Sprudlwassr/FlexPrint/documents/graphics/Letzter Versuchsaufbau.jpg

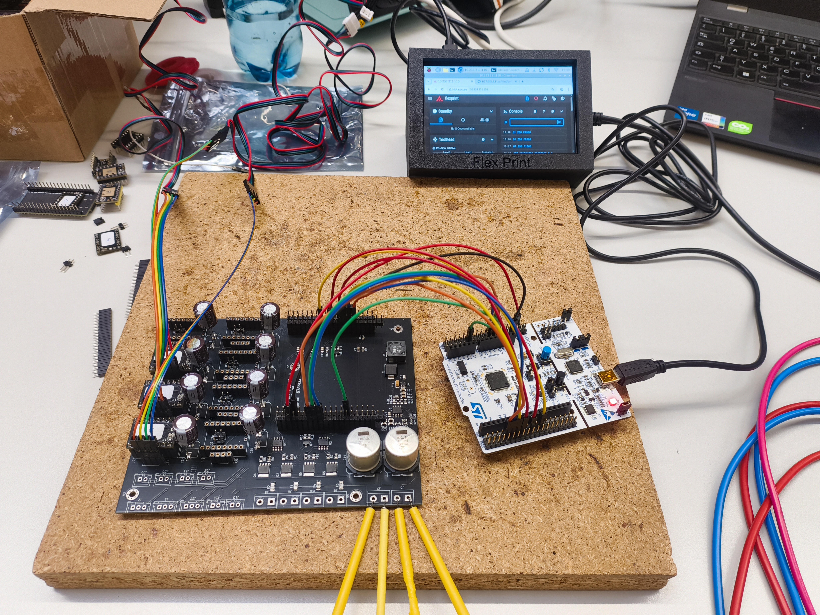
documents/graphics/Letzter Versuchsaufbau.jpg
