Sprudlwassr/FlexPrint/documents/graphics/IMG_20260625_225233708.jpg

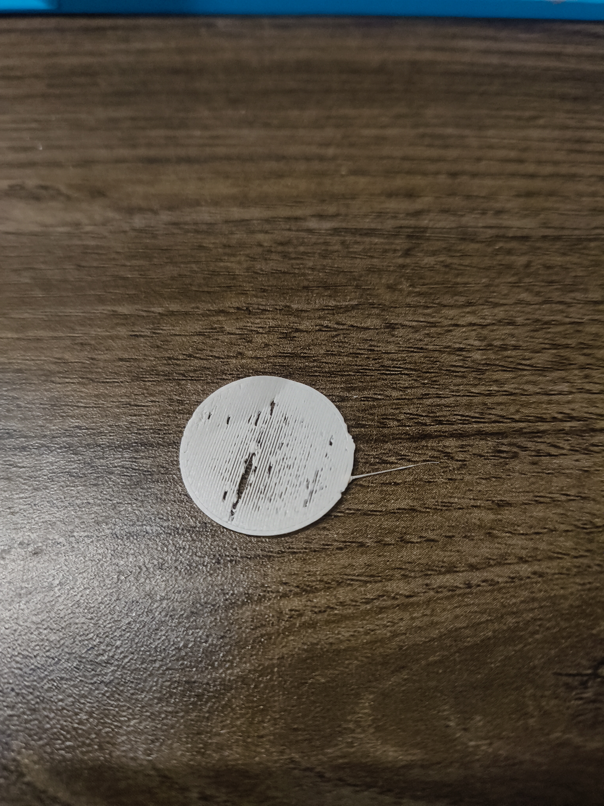
documents/graphics/IMG_20260625_225233708.jpg
