Sprudlwassr/FlexPrint/documents/Doku_Fab_v1.docx

# 1 Entwicklung der Steppertreiberplatine

## Anforderungen an die Treiberplatine

Kernaufgabe der Platine ist es, einen bipolaren Schrittmotor sauber zu treiben – und das unter Bedingungen, die sowohl elektrisch als auch thermisch einiges verlangen. Der Einsatz im 3D-Drucker bringt dabei zwei Anforderungen besonders in den Vordergrund: Der Motor soll möglichst leise laufen, und der Strom muss stabil geregelt bleiben. Damit Motorstrom und Microstepping nicht fest verdrahtet sind, sondern sich flexibel einstellen lassen, wird eine serielle Schnittstelle zur digitalen Konfiguration benötigt.

Mit 24 V Versorgungsspannung arbeitet das System – die Leistungsseite der Platine muss das von Grund auf berücksichtigen. Leiterbahnen, die hohe Motorströme führen, brauchen entsprechend Querschnitt. Auf der anderen Seite der Platine, dort wo die Logik sitzt, ist 3,3 V das Maß der Dinge, passend zur verwendeten Mikrocontrollerumgebung.

Von Anfang an war Modularität gewünscht. Jeder Treiber bekommt seine eigene kleine Platine – fällt einer aus, lässt er sich rasch tauschen, ohne den Rest anzufassen. Nebenbei macht das die Anordnung auf dem Mainboard flexibler und erlaubt es, Wärme dort abzuführen, wo es am sinnvollsten ist.

Mehrere Treiber teilen sich einen gemeinsamen UART-Bus, weshalb jede Platine eindeutig adressierbar sein muss. Lötbrücken oder Konfigurationspads bieten sich dafür an. Daneben müssen STEP, DIR und ENABLE als Steuersignale für den Echtzeitbetrieb verfügbar sein.

Thermisch darf man sich keine Schwächen erlauben: Verlustleistung, die nicht abgeführt wird, wird zum Problem. Großzügig dimensionierte Kupferflächen und eine gut durchdachte Bauteilplatzierung sind hier die entscheidenden Maßnahmen.

## Auswahl des Treiber-IC

Der Treiber muss den Strom sauber regeln und dabei effizient arbeiten. Konfiguriert wird er über UART, was Pins am Mikrocontroller spart. Der Betrieb soll leise sein und Microstepping muss ebenfalls unterstützt werden damit die Bewegung feiner wird.
Elektrisch gelten folgende Vorgaben:

- 3,3V Logikpegel, weil der Mikrocontroller damit arbeitet.
- Auf der Motorseite mindestens 24V
- Dauerströme zwischen 1A und 2A RMS müssen problemlos funktionieren.

Basierend auf den Anforderungen der Treiberplatine fiel die Wahl auf den TMC2209 Treiber-IC. Er deckt alle benötigten Funktionen, wie den leisen Betrieb mittels StealthChop Technologie oder UART Konfiguration von bis zu 4 Chips pro UART, ab. Der TMC2209 arbeitet mit 24V Motorspannung und bis zu 2 Ampere (Dauerstrom). Auch wichtig ist, dass der Treiber mit den 3.3V Logikspannung die auf dem Mainboard verwendet werden klarkommt.

## Funktionsbeschreibung des Treibers

Der TMC2209 ist ein Stepper-Treiber-IC von Trinamic, der für den Einsatz in 3D-Druckern und ähnlichen Anwendungen entwickelt wurde. Er treibt bipolare Schrittmotoren mit bis zu 2A Dauerstrom und 24V Motorspannung.

Die Stromregelung läuft intern über ein Chopper-Verfahren. Dabei wird die Motorspannung schnell ein- und ausgeschaltet, quasi eine Pulsweitenmodulation, bis der gewünschte Strom erreicht ist. Der TMC2209 nutzt dafür den StealthChop2 Modus, der den Motor sehr leise macht weil die Schaltfrequenz optimiert wird. Bei höheren Geschwindigkeiten schaltet er automatisch auf SpreadCycle um, was eine präzisere Regelung bringt.

Microstepping unterstützt der TMC2209 bis zu 1/256 Schritt, was die Bewegung deutlich feiner und ruhiger macht. Konfiguriert wird alles über UART, bis zu 4 Chips können auf einem Bus betrieben werden – jeder mit eigener Adresse.

Zusätzlich hat der TMC2209 eine StallGuard Funktion, die eine sensorlose Endlagenerkennung ermöglicht. Der Motor läuft gegen einen Anschlag, der Treiber erkennt den erhöhten Widerstand und meldet das dem Mikrocontroller – ganz ohne extra Endschalter.

Die Logikseite arbeitet mit 3,3V, was direkt mit den meisten Mikrocontrollern kompatibel ist.

## Dimensionierung der Sense-Widerstände

[Tabelle aus Datenblatt S.52]

Shunt-Widerstände müssen sorgfältig ausgewählt werden. Der volle Motorstrom fließt durch die Shunt-Widerstände. Aufgrund des Chopper-Betriebs sind die Shunt-Widerstände gepulsten Strömen aus den MOSFET-Brücken ausgesetzt. Daher ist ein induktivitätsarmer Typ wie Film- oder Kompositionswiderstände erforderlich, um Spannungsspitzen zu vermeiden, die ein Schwingen an den Stromsensor-Eingängen verursachen und zu instabilen Messergebnissen führen würden.

Ebenso ist ein induktivitätsarmes, niederohmiges Leiterplattenlayout unerlässlich. Gemeinsame GND-Pfade für die beiden Shunt-Widerstände müssen unbedingt vermieden werden, da dies zu einer Kopplung zwischen den beiden Strommesssignalen führen würde. Eine massive Massefläche ist am besten geeignet.

Der Shunt-Widerstand muss in der Lage sein, den Motorspitzenstrom bei Motorstillstand zu führen, sofern die Standby-Leistung nicht reduziert wird. Unter normalen Bedingungen führt der Shunt-Widerstand weniger als den Effektivstrom der Spule, da während der Freilaufphasen (Slow Decay) kein Strom durch den Shunt-Widerstand fließt. Ein Typ mit 0,5 W ist für die meisten Anwendungen bis 1,2 A Effektivstrom ausreichend.

Für das Projekt wurde ein Shunt von 120m Ohm ausgewählt. Aus der Tabelle kann entnommen werden, dass dies einen RMS-Strom von 1.64A zur Folge hat. Der größte Vorteil von ~1.7A zu den maximalen ~2A ist, dass die Verlustleistung um knapp 40% verringert wird, bei nur 17% Einbußen an Kraft. Dazu kommt, dass der TMC2209 Chip, wenn er am Limit (2A) läuft, nicht mehr schön im StealthChop Modus bleibt und dann Schrittverluste auftreten können.

## UART-Kommunikation

### Übersicht

Der TMC2209 nutzt eine Single-Wire UART-Schnittstelle – das heißt, Senden und Empfangen laufen über einen einzigen Pin: PDN_UART.

Die Baudrate wird automatisch erkannt, muss also nicht fest konfiguriert werden. Typisch werden 9.600 – 500.000 Baud verwendet (Standard 115.200 Baud).

### One-Wire Bus

Normalerweise hat UART zwei Leitungen: TX (Senden) und RX (Empfangen). Beim TMC2209 werden beide auf einer einzigen Leitung zusammengeführt.

Das geht so:

[BILD VOM UART PIN RX UND TX MIT 1K]

TX und RX des Mikrocontrollers sind über einen 1-kΩ-Widerstand miteinander verbunden und führen gemeinsam zum PDN_UART-Pin des TMC2209.

Alles, was der Mikrocontroller sendet, landet auch sofort auf seiner eigenen RX-Leitung → das nennt man Echo. Diese Echo-Bytes müssen in der Software einfach ignoriert/übersprungen werden.

Der Bus muss im Leerlauf auf High liegen (wie bei Standard-UART).

Es wird immer nur in eine Richtung gleichzeitig kommuniziert (Halbduplex).

Bis zu 4 TMC2209 können an einem Bus hängen – Adresse wird über die Pins MS1 und MS2 eingestellt.

### Datagrammstruktur

Jede Kommunikation besteht aus kurzen Datenpaketen (Datagrammen).

Schreiben (4 → 8 Bytes vom MC zum TMC2209):

Byte | Inhalt
0 | Sync
1 | Adresse
2 | Register + Write
3-6 | 32-Bit Datenwort (MSB beginnend)
7 | CRC (Prüfsumme)

Lesen (erst 4 Bytes senden, dann 8 Bytes Antwort empfangen):

Byte | Inhalt
0 | Sync
1 | Adresse
2 | Register (ohne Write)
3 | CRC

Die Antwort des Treibers sieht aus wie der Schreibvorgang mit 8 Byte Paketgröße.

### Adressierung

Die Adressen der Chips werden über die Pins MS1 und MS2 wie folgt eingestellt:

MS2 | MS1 | Adresse
0 | 0 | 0
0 | 1 | 1
1 | 0 | 2
1 | 1 | 3

## STEP/DIR Signalführung

### Übersicht

STEP und DIR sind im Prinzip zwei simple Signale. Das Step-Signal gibt an, ob ein Schritt gemacht werden soll oder nicht und das Dir-Signal gibt an, in welche Richtung der Schritt geht.

### Pegel & Kompatibilität

Der TMC2209 unterstützt sowohl 3,3 V als auch 5 V Logik – welcher Pegel gilt, eingestellt wird dies über den VCC_IO-Pin.

Liegt VCC_IO auf 3,3 V, arbeiten alle digitalen Pins mit 3,3-V-CMOS-Pegeln.

Wichtig dabei: Die Eingänge STEP, DIR und ENN sind nicht 5V-tolerant, wenn VCC_IO auf 3,3 V liegt.

### Timing

Die Signale müssen bestimmte Mindestzeiten einhalten, damit der Treiber jeden Schritt zuverlässig erkennt.

Die wichtigste Regel betrifft das Verhältnis von DIR und STEP: DIR muss mindestens 20 ns vor der steigenden Flanke von STEP stabil anliegen (Setup-Zeit, t_DSU), und auch nach der Flanke noch mindestens 20 ns gehalten werden (Hold-Zeit, t_DHD).

Wechseln DIR und STEP zu exakt dem gleichen Zeitpunkt, kann der Treiber einen falschen Schritt in die falsche Richtung machen.

Der STEP-Puls selbst muss mindestens 100 ns High bleiben (t_HIGH) und danach mindestens 100 ns Low bleiben (t_LOW), bevor der nächste Puls kommen darf. Kürzere Pulse werden vom Treiber möglicherweise gar nicht erkannt.

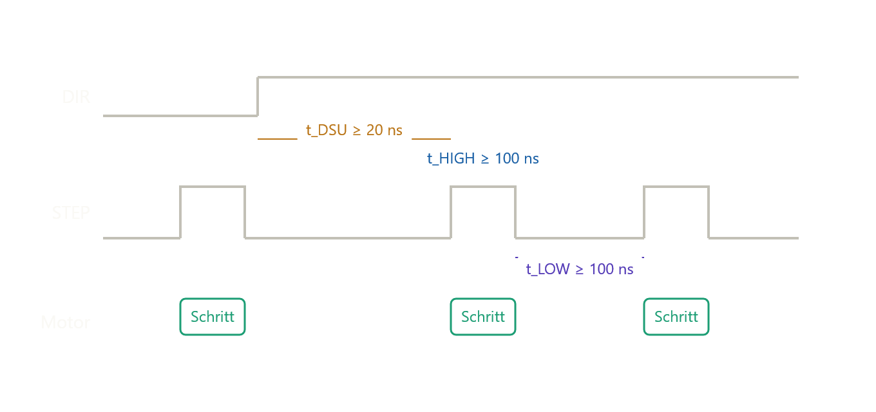
[picture p3: figure]

## Versorgungsspannung der Treiber

Jeder TMC2209 benötigt zwei getrennte Versorgungsspannungen: VM (Motorversorgung) und VIO (Logikversorgung).

### VM – Motorversorgung (24V)

VM wird direkt vom 24V Hauptnetzteil gespeist und versorgt die H-Brücken des Treibers, die den Motorstrom schalten. Pro Treiber ist ein 100µF Elektrolytkondensator (C36) parallel zu VM geschaltet, der als Bulk-Speicher dient und kurzzeitige Stromspitzen beim Schalten der H-Brücken abpuffert.

### VIO – Logikversorgung (3.3V)

VIO wird von der 3.3V Schiene des Mainboards gespeist, die vom MIC5219-3.3YM5 LDO (Linearregler) bereitgestellt wird. Dieser wird seinerseits vom TPS54560BDDA (12V→5V Schaltregler) versorgt — die vollständige Kaskade lautet also: 24V → 12V (extern) → 5V (TPS54560BDDA) → 3.3V (MIC5219). VIO versorgt die digitale Logik des TMC2209 sowie die UART-Schnittstelle. Pro Treiber ist ein 100nF Keramikkondensator (C20) an VIO platziert.

### Einschaltreihenfolge

Die korrekte Einschaltreihenfolge (VM vor VIO) ist hardwareseitig durch einen Spannungsteiler an dem Enable-Pin (EN) des TPS54560BDDA abgesichert. Die Widerstände R25 (11kΩ) und R26 (100kΩ) bilden einen Spannungsteiler von der 24V Schiene auf EN — der Regler bleibt solange deaktiviert bis die 24V Versorgung eine Schwelle von ca. 12.6V überschreitet. Da VM direkt von 24V kommt ohne weitere Wandlerstufe, ist garantiert dass VM bereits stabil anliegt bevor der TPS54560BDDA die 5V Schiene und damit die gesamte VIO-Kaskade (5V → 3.3V) aktiviert.

## Entkopplung und Filterung

Um hochfrequente Störungen durch das schnelle Schalten der H-Brücken zu unterdrücken und eine stabile Versorgung sicherzustellen, sind an jedem TMC2209 mehrere Entkopplungsmaßnahmen implementiert.

### VM-Entkopplung

An der VM-Versorgung jedes Treibers ist am Mainboard ein 100µF Elektrolytkondensator, dieser wird benötigt zum Spannungsspitzen durch die Motoransteuerung kompensieren. Auf der Treiberplatine sind zusätzlich 2x 10µF sowie 3x 100nF an VM vorgesehen. Der Charge-Pump Kondensator C3 an CPO/CPI ist laut Datenblatt für den internen Spannungsverdoppler des TMC2209 erforderlich. Dieser wird benötigt um die Treiber FETs vollständig durchzuschalten.

### VIO-Entkopplung

An VIO ist am Steckplatz der Treiberplatine ein 100nF Keramikkondensator (C20) platziert, dieser unterdrückt hochfrequente Störungen auf der Logikversorgung die durch UART-Kommunikation oder digitale Schaltvorgänge entstehen können. Dazu kommen weitere zwei Kondensatoren C1 (100nF) und C2 (4.7µF), die auf der Treiberplatine selbst, möglichst nah am IC platziert sind.

## Thermisches Design

### Verlustleistung

Der TMC2209 dissipiert im Betrieb Verlustleistung primär über die integrierten H-Brücken. Die Verlustleistung pro Treiber berechnet sich nach:

P=I^2 *R_(dson)

Der TMC2209 besitzt laut Datenblatt einen kombinierten R_DS(on) von ca. 0.34Ω (High-Side + Low-Side je 0.17Ω). Damit ergibt sich:

Bei 0.8A RMS (Inbetriebnahme/Testbetrieb): P=0.8^2 *0.34=0.22W pro Treiber

Bei 1.5A RMS (Volllastbetrieb): P=1.5^2 *0.34=0.77W pro Treiber

Bei sieben verbauten Treibern (2x XY, 3x Z, 1x Extruder, 1x Reserve) ergibt sich die gesamte thermische Last:

Bei 0.8A: P_(ges) =7*0.22W=1.53W

Bei 1.5A: P_(ges) =7*0.77W=5.36W

### Wärmeableitung über das PCB

Der TMC2209 im QFN28-Gehäuse besitzt ein freiliegendes Thermal Pad auf der Unterseite, das den Großteil der Wärme an das PCB abgibt. Da die Treiberplatine als separates Modul ausgeführt ist (15.48 × 20.44mm), wurde unter dem Thermal Pad eine Matrix aus Thermal Vias platziert die die Wärme auf die Rückseite der Platine überträgt. Dort vergrößert eine Kupferfläche die effektive Abstrahlfläche. Ein direktes Exposed Pad auf der Rückseite wurde aus fertigungstechnischen Gründen nicht vorgesehen.

### Aktive Kühlung

Auf der Oberseite jedes Treibermoduls wird ein kompakter Kühlkörper aufgeklebt. Das Druckergehäuse wird mit mindestens einem Lüfter ausgestattet der für ausreichend Luftzirkulation im Elektronikbereich sorgt und die von den Kühlkörpern abgegebene Wärme abtransportiert.

## Schaltplan der Treiberplatine

Der vollständige Schaltplan der Treiberplatine ist in Abbildung X dargestellt. Er zeigt den TMC2209 im QFN28-Gehäuse mit allen peripheren Beschaltungselementen: die Entkopplungskondensatoren an VM und VIO, den Charge-Pump Kondensator C3, die Sense-Widerstände R4 und R5 (je 120 mΩ) zur Strommessung, sowie den PDN_UART Anschluss mit Pull-up Widerstand R2 (20kΩ). Der einstellbare Widerstand RV1 ermöglicht die manuelle Anpassung des Referenzstroms über VREF. Die Motorausgänge (OUTA1, OUTA2, OUTB1, OUTB2) sowie alle Steuersignale (STEP, DIR, EN, UART) werden über zwei 8-polige Steckverbinder (J1, J2) nach außen geführt.

## Layout der Treiberplatine

Das PCB-Layout der Treiberplatine ist in Abbildung X dargestellt. Die Platine hat eine Abmessung von 15.48 × 20.44mm und ist als zweiseitiges Layout ausgeführt. Der TMC2209 ist zentral platziert, die Entkopplungskondensatoren an VM befinden sich direkt oberhalb des ICs um die parasitären Induktivitäten der Versorgungsleitungen minimal zu halten. Die Sense-Widerstände R4 und R5 sind unmittelbar an den Motorausgängen platziert. Unter dem Thermal Pad des TMC2209 befindet sich eine Via-Matrix zur thermischen Anbindung an die Rückseite. Die Steckverbinder sind an den Außenkanten der Platine angeordnet um eine einfache Montage auf dem Mainboard zu ermöglichen.

## Aufbau der Treiberplatine

[Bilder vom Aufbau/Testaufbau]

Der Aufbau der Treiberplatine erwies sich aus mechanischer Sicht relativ einfach trotz des sehr kleinen Formfaktors der Platinen. Nachdem alle Platinen aufgebaut waren, wurde eine optische Kontrolle an allen Platinen durchgeführt, die keine Mängel hervor hob. Schließlich wurde die Eingangsimpedanz-Messung gemacht. Zu den eigenst hergestellten Platinen wurde auch ein Satz fertige Treiberboards gekauft für unwahrscheinlichen Fall, dass der eigene Entwurf scheitert. Um die Eingangsimpedanz zu kontrollieren wurde auch eine gekaufte Platine gemessen. Die Impedanzen waren alle ca. auf gleichem Niveau, außer bei einer Platine, diese hatte einen Kurzschluss am Chip der nicht beseitigt werden konnte.
[BILD VON MESSUNG]

Nach der Impedanzmessung folgt der erste Testaufbau. Dabei wurde ein kritisches Detail des Datenblatts zunächst nicht beachtet: Die Logikversorgung VIO darf nicht vor der Motorversorgung VM angelegt werden. Bei falscher Einschaltreihenfolge wird der Treiber zerstört. Im Zuge der Inbetriebnahme wurden auf diese Weise zwei TMC2209 beschädigt, was die Notwendigkeit einer hardwareseitigen Absicherung der Einschaltreihenfolge verdeutlichte - die in Kapitel 1.7 beschriebene Lösung über den Spannungsteiler an EN des TPS54560BDDA wurde daraufhin implementiert.

Der Grund für die Empfindlichkeit liegt in der Halbleitertechnologie: Wenn VIO anliegt aber VM noch nicht vorhanden ist, versucht der Treiber zu initialisieren, ohne dass die Leistungsstufe betriebsbereit ist. Die Gate-Spannung der H-Brücken ist in diesem Zustand undefiniert und die internen Schutzschaltungen arbeiten nicht korrekt. Wird VM anschließend angelegt, entsteht ein unkontrollierter Einschaltstrom der die H-Brücken irreversibel zerstört.
[BILD ZUHAUSE MESSAUFBAU FALLS VORHANDEN]

Nachdem die Einschaltreihenfolge korrigiert wurde, konnte der Treiber erfolgreich in Betrieb genommen werden. Über das Potentiometer wurde die Stromgrenze auf ca. 1A eingestellt. Nach dem Einschalten der Versorgungsspannungen war der erste Schritt der Funktionsprüfung zu kontrollieren ob der Haltestrom aktiv ist. Da sich der Motor nicht von Hand drehen ließ, war die grundlegende Funktion bestätigt.

Anschließend wurde versucht den Motor mittels eines ESP32 anzusteuern. Dazu wurden zunächst nur die Signale STEP und DIR verwendet. Mit wenigen Zeilen Code begann sich der Motor zu drehen, jedoch mit starken Vibrationen. Eine Überprüfung aller Anschlüsse und der Verdrahtung ergab keinen Fehler.

Daraufhin wurde die Ansteuerung über die One-Wire UART Schnittstelle versucht. Hierfür wurde eine bestehende Bibliothek für den ESP32 verwendet. Nach einigen Versuchen drehte sich der Motor über UART deutlich ruhiger und nahezu geräuschlos. Die Ursache für die Vibrationen bei der reinen STEP/DIR Ansteuerung lag vermutlich in der fehlenden UART-Konfiguration - ohne diese arbeitet der TMC2209 mit den internen Standardwerten, was unter anderem die StealthChop und Interpolationsfunktionen deaktiviert lässt und zu erhöhten Vibrationen führt.

[BILD ZUHAUSE MESSAUFBAU / SIGNALE FALLS VORHANDEN]

# 2 Entwicklung des Mainboards

## Anforderungen

Das Mainboard bildet das Herzstück des 3D-Druckers und übernimmt die zentrale Steuerung aller Antriebe, Heizungen, Sensoren und Lüfter. Die Anforderungen ergeben sich direkt aus dem mechanischen Aufbau des Druckers sowie den eingesetzten Komponenten.

### Motoransteuerung

Der Drucker verfügt über sieben aktiv genutzte Schrittmotoren: zwei für die CoreXY-Kinematik (X, Y), drei für die Z-Achse, zwei für die Extruder sowie einen inaktiven Reservetreiber für zukünftige Erweiterungen. Jeder Motor wird über einen eigenen TMC2209 Treiber angesteuert, der als separates Modul auf das Mainboard gesteckt wird. Das Mainboard muss dafür acht Steckplätze mit je STEP, DIR, EN und UART bereitstellen.

### Heizungsansteuerung

Zwei Hotends und ein beheiztes Druckbett müssen angesteuert werden. Die Hotends werden mit 24V und je 60W betrieben, das Druckbett mit 24V und 288W. Für jeden Kanal ist eine eigene MOSFET-Treiberstufe mit Sicherung vorgesehen.

### Temperatursensoren

Für jedes Hotend sowie für das Druckbett ist ein Thermistor-Eingang erforderlich. Die Signale werden über einen ADC-Pin des Mikrocontrollers eingelesen.

### Lüftersteuerung

Zwei PWM-gesteuerte Lüfterkanäle sind für die Bauteilkühlung der Toolheads vorgesehen. Die Gehäuse- und Elektronikkühlung wird über separat versorgte Lüfter ohne PWM-Regelung realisiert.

### Endstops

Drei Endstop-Eingänge für die Achsen X, Y und Z sind erforderlich. Die Signale werden mit Pullup-Widerständen auf 3,3V gehalten.

### Spannungsversorgung

Das Mainboard wird mit 24V versorgt. Intern werden daraus 12V (extern gewandelt), 5V (TPS54560BDDA) und 3,3V (MIC5219) erzeugt. Die 3,3V Schiene versorgt den Mikrocontroller und die Logik aller Treiber.

### Modularität und Erweiterbarkeit

Durch den modularen Aufbau mit steckbaren Treibermodulen lassen sich defekte Treiber einfach tauschen. Ein Reservesteckplatz ermöglicht die spätere Erweiterung um einen weiteren Motor ohne Änderung am Mainboard.

## Auswahl des Mikrocontrollers

Zu Beginn der Planung wurde der ESP32 als Hauptcontroller in Betracht gezogen, da er über integriertes WLAN, ausreichend GPIO-Pins und eine hohe Rechenleistung verfügt. Im Verlauf der Konzeptionsphase stellte sich jedoch heraus, dass Klipper - die gewählte Firmware - den ESP32 nicht als vollwertigen MCU unterstützt, sondern lediglich als WLAN-Brücke zwischen Host und eigenem Mikrocontroller. Da Klipper eine enge Echtzeitkommunikation zwischen Host (Raspberry Pi) und MCU erfordert, fiel die Wahl auf den STM32F446RE, der von Klipper vollständig unterstützt wird.

Als Trägerboard wurde das STM32F446RE Nucleo Development Board gewählt. Dieses Board stellt alle benötigten Pins des STM32F446RE über Steckleisten zur Verfügung und verfügt über einen integrierten ST-Link Debugger, der das Flashen und Debuggen der Klipper-Firmware ohne zusätzliche Hardware ermöglicht. Für den Einsatz in einem Diplomarbeitsprojekt bietet das Nucleo Board damit einen wesentlichen Vorteil gegenüber einem direkt bestückten STM32: es reduziert die Komplexität des Mainboard-Designs und minimiert das Risiko von Bestückungsfehlern am Mikrocontroller selbst.

Der STM32F446RE verfügt über ausreichend GPIO-Pins für alle benötigten Funktionen: sieben STEP/DIR/EN Signale für die Schrittmotortreiber, mehrere UART-Busse für die TMC2209 Kommunikation, ADC-Eingänge für die Temperatursensoren sowie PWM-Ausgänge für Heizungen und Lüfter.

## Funktionsbeschreibung des Mikrocontrollers

Der STM32F446RE ist ein 32-Bit Mikrocontroller der STM32F4-Serie von STMicroelectronics, basierend auf dem ARM Cortex-M4 Kern mit einer Taktfrequenz von bis zu 180 MHz sowie einer integrierten Floating Point Unit (FPU). Diese Rechenleistung ist für den Einsatz mit Klipper wichtig, da die Firmware eine hohe Schrittrate für präzise Bewegungssteuerung erfordert.

### Relevante Peripherie für das Mainboard

Für die Schrittmotortreiber werden pro Treiber je ein GPIO-Pin für STEP, DIR und EN verwendet — insgesamt 24 Pins für acht Treiber. Die UART-Kommunikation mit den TMC2209 erfolgt über dedizierte USART-Schnittstellen des STM32, wobei mehrere Treiber einen gemeinsamen Bus teilen und über ihre MS1/MS2 Pins adressiert werden.

Die Temperatursensoren für Hotends und Druckbett werden über die integrierten ADC-Eingänge eingelesen. Der STM32F446RE verfügt über drei ADC-Einheiten mit insgesamt 16 verfügbaren Kanälen, was ausreichend Reserve für alle Temperaturmessungen und zukünftige Erweiterungen bietet.

Für die PWM-gesteuerten Ausgänge (Heizungen, Lüfter) werden Timer-Peripherien des STM32 genutzt. Die Endstop-Signale werden als einfache GPIO-Eingänge mit Pull-up Widerständen eingelesen.

Die Kommunikation zwischen STM32 und dem Raspberry Pi als Host erfolgt über den integrierten ST-Link des Nucleo Boards, der sich gegenüber dem Raspberry Pi als virtueller COM-Port über USB meldet. Klipper nutzt diese serielle Verbindung zur Echtzeitkommunikation mit dem Mikrocontroller.

## Spannungsversorgung

### Übersicht der Versorgungsschienen

Das Mainboard wird mit 24V vom Hauptnetzteil versorgt. Daraus werden intern mehrere Spannungsebenen erzeugt die für die verschiedenen Komponenten benötigt werden:

Spannung | Verwendung
24V | Motoren, Hotends, Druckbett, Lüfter
12V | Versorgung für Schaltregler, FET Steuerspannung
5V | Lüfter
3.3V | Logikspannung, Nucleo Board und Treiber Versorgung

### 24V auf 5V Schaltregler (TPS54560BDDA)

Die 5V Versorgung wird durch den Schaltregler TPS54560BDDA erzeugt, der aus der extern gewandelten 12V Schiene speist. Der Regler arbeitet als Tiefsetzsteller mit einer Induktivität von 7.2µH und drei parallelen Ausgangskondensatoren (je 47µF) zur Glättung. Die Ausgangsspannung wird über den Spannungsteiler R21 (53.6kΩ) und R22 (10.2kΩ) am FB-Pin auf 5V eingestellt. Am Eingang sind vier parallele 2.2µF Keramikkondensatoren zur Entkopplung platziert.

Die Aktivierung des Reglers ist hardwareseitig über einen Spannungsteiler an EN abgesichert - wie bereits in Kapitel 1.7 beschrieben, stellt dieser sicher dass die 5V Schiene und damit die gesamte VIO-Kaskade erst aktiv wird wenn die 24V Versorgung stabil anliegt.

### 5V auf 3,3V Linearregler (MIC5219)

Die 3,3V Versorgung wird durch den LDO-Linearregler MIC5219-3.3YM5 aus der 5V Schiene erzeugt. Am Ausgang sind ein 2.2µF Tantalkondensator sowie ein 470pF Keramikkondensator zur Stabilisierung platziert. Der MIC5219 versorgt die Logik aller TMC2209 Treiber (VIO), die Endstop-Pullups sowie die digitalen Signalleitungen des Mainboards.

### Einschaltreihenfolge

Die Einschaltreihenfolge wurde bereits ausführlich in Kapitel 1.7 behandelt und gilt unverändert für das Mainboard. VM (24V) liegt stets vor VIO (3,3V) an, was durch den Spannungsteiler an EN des TPS54560BDDA hardwareseitig sichergestellt ist.

## Ansteuerung der Schrittmotortreiber

### STEP/DIR/EN Signalführung

Wie in Kapitel 1.6 beschrieben, erfolgt die Grundansteuerung jedes TMC2209 über drei Signale: STEP, DIR und EN. Auf dem Mainboard führt der STM32F446RE diese Signale über dedizierte GPIO-Pins zu den jeweiligen Treibersteckplätzen. Pro Treiber sind die drei Leitungen direkt vom Nucleo Board zu den Steckverbindern der Treibermodule geroutet.

Der EN-Pin ist bei allen Treibern aktiv-low, das bedeutet der Treiber ist deaktiviert wenn EN auf High liegt. Beim Start des Systems sind alle EN-Pins durch Pull-up Widerstände auf 3,3V gezogen, wodurch die Treiber erst dann Strom in die Motoren schalten wenn Klipper die Kontrolle übernommen hat und die Pins aktiv auf Low zieht. Dies verhindert unkontrollierte Motorbewegungen beim Hochfahren des Systems.

### UART-Bus Verteilung

Die Konfiguration der TMC2209 erfolgt über UART wie in Kapitel 1.5 beschrieben. Auf dem Mainboard sind die acht Treiber auf zwei UART-Busse aufgeteilt, da der TMC2209 maximal vier Chips pro Bus unterstützt. Die Adressierung erfolgt über die MS1 und MS2 Pins der Treibermodule, die über Lötbrücken oder Steckbrücken eingestellt werden.

Die UART-Leitungen werden vom STM32 über 1kΩ Widerstände auf den gemeinsamen Bus geführt, wie in der One-Wire Beschaltung aus Kapitel 1.5.2 beschrieben. Jeder Treiber ist damit einzeln konfigurierbar und auslesbar ohne die anderen Treiber am Bus zu beeinflussen.

## Hotend- und Bettansteuerung

### Auswahl MIC4426

Für die Ansteuerung der Leistungs-MOSFETs wird der MIC4426 Gate-Treiber IC eingesetzt. Der MIC4426 ist ein dualer Low-Side MOSFET-Treiber der mit einer Versorgungsspannung von 4,5V bis 18V betrieben werden kann und Ausgangsströme von bis zu 1,5A liefert. Auf dem Mainboard wird er mit 12V versorgt, was ausreichend Gate-Spannung liefert um die eingesetzten N-Kanal MOSFETs vollständig durchzusteuern. Der Logikeingang des MIC4426 erkennt Signale ab 2,4V als High, womit die 3,3V Ausgangspegel des STM32 direkt kompatibel sind ohne zusätzliche Pegelanpassung.

Beide Ausgänge des MIC4426 sind invertierend — ein High-Signal am Eingang ergibt ein Low-Signal am Ausgang und umgekehrt. Das bedeutet dass die Steuersignale vom STM32 in der Klipper-Konfiguration mit dem ! Operator invertiert werden müssen, damit die MOSFETs im Ruhezustand gesperrt bleiben und die Heizelemente nicht unkontrolliert aufheizen.

### Signalweg

Das PWM-Signal vom STM32 (3,3V Logikpegel) wird an den Eingang des MIC4426 geführt. Da der MIC4426 invertierend arbeitet und mit 12V versorgt wird, gibt er am Ausgang ein invertiertes Signal mit 12V Hub aus. Dieses Signal treibt direkt das Gate des PSMN5R2-60YL MOSFET. Mit 12V Gate-Spannung schaltet der MOSFET vollständig durch und gibt den Strompfad von 24V durch das Heizelement nach GND frei.

### MOSFET Auswahl

Für alle drei Heizkreise (zwei Hotends, ein Druckbett) wird der PSMN5R2-60YL N-Kanal MOSFET eingesetzt. Dieser eignet sich durch seinen niedrigen R_DS(on) von 5.2mΩ besonders gut für die hohen Ströme des Druckbetts (288W / 24V = 12A). Jeder MOSFET ist mit einem 100kΩ Pull-down Widerstand am Gate gegen GND beschaltet, der sicherstellt dass das Gate im ungetriebenen Zustand definiert auf Low liegt und der MOSFET gesperrt bleibt.

### Schutzmaßnahmen

Jeder Heizkreis ist durch eine eigene Sicherung abgesichert. Das Druckbett erhält eine 15A Sicherung (288W / 24V ≈ 12A, mit 25% Reserve), die beiden Hotends je eine 3A Sicherung (60W / 24V = 2.5A, mit Reserve). Im Fehlerfall schützt die Sicherung vor einem Kabelbrand.

### Thermisches Design der MOSFETs

Die Verlustleistung der MOSFETs berechnet sich nach:

P=I^2 *R_(dson)

Der PSMN5R2-60YL hat laut Datenblatt einen typischen R_DS(on) von 5,2mΩ bei V_GS = 10V. Mit 12V Gate-Spannung vom MIC4426 liegt der tatsächliche R_DS(on) noch etwas darunter, weshalb die Berechnung als konservative Abschätzung gilt.

Hotend (I = 2,5A): P=2.5^2 *0.0052=0.033W pro MOSFET

Druckbett (I = 12A): P=12^2 *0.0052=0.749W

Die Verlustleistungen sind aufgrund des sehr niedrigen R_DS(on) gering. Die MOSFETs sind im SOT669 Gehäuse ausgeführt, das ein freiliegendes Thermal Pad auf der Unterseite besitzt über das die Wärme direkt an das PCB abgegeben wird. Im Layout sind unter den MOSFETs großzügige Kupferflächen vorgesehen die als Wärmesenke dienen. Eine zusätzliche aktive Kühlung ist aufgrund der geringen Verlustleistungen nicht erforderlich - die passive Wärmeabgabe über die Kupferfläche ist ausreichend.

## Lüftersteuerung

Für die PWM-Steuerung der Bauteilkühlung sind zwei unabhängige Lüfterkanäle vorgesehen. Als Schaltelement wird jeweils ein AO3400A N-Kanal MOSFET im SOT-23 Gehäuse eingesetzt. Der AO3400A ist für diese Anwendung gut geeignet da er bei einer Gate-Spannung von 3,3V bereits vollständig durchschaltet - ein vorgelagerter Gate-Treiber wie der MIC4426 ist daher nicht erforderlich, der STM32 kann den MOSFET direkt ansteuern.

Die Bauteilkühlung wird mit 24V versorgt und über PWM-Signale vom STM32 geregelt. Klipper steuert die Lüfterdrehzahl abhängig von der Druckgeschwindigkeit und dem verwendeten Material.

Für die Verlustleistung gilt analog zu Kapitel 2.6.5:

P=I^2 *R_(dson)

Ein typischer 24V Lüfter zieht ca. 0,1–0,3A. Der AO3400A hat einen R_DS(on) von ca. 40mΩ bei V_GS = 3,3V.

Damit ergibt sich: P=0.33^2 *0.04=0.004W

Die Verlustleistung ist vernachlässigbar gering, eine zusätzliche Wärmeabfuhr ist nicht erforderlich.

### Hotend- und Gehäuselüfter

Der Hotend-Lüfter sowie die Gehäuselüfter für die Elektronikkühlung werden nicht über PWM geregelt sondern laufen dauerhaft mit voller Drehzahl sobald das System mit Spannung versorgt wird. Sie sind direkt an die 24V beziehungsweise 5V Versorgung angeschlossen ohne schaltbare Stufe. Diese Vereinfachung ist bewusst gewählt da zum Beispiel der Hotend-Lüfter aus Sicherheitsgründen immer laufen soll solange das System aktiv ist, und die Gehäuselüfter eine konstante Kühlung der Elektronik sicherstellen sollen.

## Temperatursensoren

Für die Temperaturerfassung werden an beiden Hotends sowie am Druckbett NTC-Thermistoren eingesetzt. Ein NTC (Negative Temperature Coefficient) Widerstand verringert seinen Widerstandswert mit steigender Temperatur - diese Widerstandsänderung wird vom ADC des STM32 ausgelesen und in Klipper in einen Temperaturwert umgerechnet.

### Beschaltung

Jeder Thermistor ist als Spannungsteiler gegen 3,3V beschaltet: ein fixer Pull-up Widerstand liegt zwischen 3,3V und dem ADC-Pin, der Thermistor zwischen ADC-Pin und GND. Mit steigender Temperatur sinkt der Thermistorwiderstand, die Spannung am ADC-Pin sinkt ebenfalls - Klipper berechnet daraus über eine Kennlinie die aktuelle Temperatur.

### Sensor-Typ

In der Klipper-Konfiguration muss der korrekte Sensor-Typ angegeben werden damit die Kennlinie stimmt. Für das Bambu X1C Klon Hotend wird der Typ Generic 3950 verwendet, was dem NTC 3950 100k Thermistor entspricht.

### ADC Schutz

Die Thermistor-Eingänge sind empfindlich gegenüber Überspannungen. Ein zu hoher Spannungswert am ADC-Pin - beispielsweise durch einen Kabelbruch oder Kurzschluss - wird von Klipper als ADC out of range Fehler erkannt und löst einen sofortigen Shutdown des Druckers aus um Schäden zu verhindern.

## Endstops

Für die Achsenbegrenzung sind drei Endstop-Eingänge auf dem Mainboard vorgesehen: je einen für die X-, Y- und Z-Achse. Es werden mechanische Endschalter verwendet die einen einfachen Schließkontakt bilden.

### Beschaltung

Jeder Endstop-Eingang ist über einen Pull-up Widerstand auf 3,3V gezogen. Im Ruhezustand (Schalter offen) liegt der IO-Pin auf High. Wird der Schalter betätigt, verbindet er den Pin mit GND und der Pegel fällt auf Low. Klipper wertet diesen Pegelwechsel als ausgelösten Endstop und stoppt die Bewegung der entsprechenden Achse.

### Positionierung

Die X- und Y-Endstops sind fix am Rahmen des Druckers montiert. Der Z-Endstop wird durch den Klicky Probe am Toolhead ersetzt, der automatisch vor der Z-Kalibrierung aufgenommen und danach wieder abgelegt wird.

### Signalpegel

Da die Endstops passive mechanische Schalter sind benötigen sie keine eigene Versorgungsspannung. Der Pull-up auf 3,3V wird direkt vom Mainboard bereitgestellt und ist kompatibel mit den GPIO-Eingängen des STM32.

## Entkopplung und Filterung

Die grundlegenden Prinzipien der Entkopplung wurden bereits in Kapitel 1.8 für die Treiberplatine beschrieben. Auf dem Mainboard werden dieselben Maßnahmen angewendet, ergänzt durch zusätzliche Entkopplung an den Mainboard spezifischen Komponenten.

### Versorgungseingang

An den Versorgungseingängen sind je ein 470µF Elektrolytkondensator an der 12V sowie an der 24V Schiene platziert. Diese puffern kurzzeitige Stromspitzen und stabilisieren die Eingangsspannung.

### Schaltregler TPS54560BDDA

Am Eingang des Schaltreglers sind vier parallele 2,2µF Keramikkondensatoren zur hochfrequenten Entkopplung platziert. Am Ausgang befinden sich drei parallele 47µF Kondensatoren zur Glättung der 5V Schiene. Der Bootstrap-Kondensator (0,1µF) versorgt den internen High-Side Gate-Treiber des Schaltreglers: Da der Source-Pin des High-Side MOSFETs nicht auf GND liegt sondern mit dem Schaltknoten mitschwimmt, wird der Bootstrap-Kondensator in der Off-Phase über eine interne Diode aufgeladen und liefert in der On-Phase die nötige erhöhte Gate-Spannung - quasi eine lokale Hilfsspannungsquelle. Die Kompensationsnetzwerke sind laut Datenblatt für den stabilen Betrieb des Regelkreises erforderlich.

### Linearregler MIC5219

Am Ausgang des MIC5219 sind ein Tantalkondensator (2,2µF) sowie ein Keramikkondensator (470pF) zur Stabilisierung der 3,3V Schiene platziert.

### Treibersteckplätze

An jedem der acht Treibersteckplätze sind je ein 100nF Keramikkondensator an VIO sowie ein 100µF Elektrolytkondensator an VM platziert. Diese puffern kurzzeitige Stromspitzen beim Schalten der H-Brücken lokal am Steckplatz.

### Thermistor-Eingänge

Jeder der vier Thermistor-Eingänge ist mit einem 10µF Kondensator gegen Analog-Ground entkoppelt. Ein Pull-up Widerstand von je 4,7kΩ auf 3,3V stellt den korrekten Ruhepegel sicher.

## Schaltplan des Mainboards

Der vollständige Schaltplan des Mainboards ist in Abbildung X dargestellt. Er zeigt alle Funktionsblöcke des Mainboards: die Spannungsversorgung mit TPS54560BDDA und MIC5219, das Nucleo F446RE Development Board als Hauptcontroller, die acht Treibersteckplätze mit Entkopplung, die MOSFET-Treiberstufen für Hotends und Druckbett mit MIC4426, die Lüftersteuerung mit AO3400A MOSFETs, die Thermistor-Eingänge sowie die Endstop-Anschlüsse. Der Schaltplan ist in KiCad erstellt und in funktionale Blöcke unterteilt um die Übersichtlichkeit zu gewährleisten.

## Layout des Mainboards

Das PCB-Layout des Mainboards ist in Abbildung X dargestellt. Die Platine ist als zweiseitiges Layout ausgeführt. Die Treibersteckplätze sind in zwei Reihen angeordnet - vier Steckplätze für die Z-Achsen und den zweiten Extruder in der oberen Reihe, sowie X, Y, Extruder und Reserve in der unteren Reihe. Das Nucleo Board wird über zwei Steckleisten aufgesteckt und nimmt den zentralen Bereich der Platine ein. Die Leistungskomponenten (MOSFETs, Sicherungen, Versorgungsanschlüsse) sind an den Außenkanten platziert um kurze Wege für die hohen Ströme zu gewährleisten und die Wärmeentwicklung vom Nucleo Board fernzuhalten.

## Aufbau und Inbetriebnahme des Mainboards

[Bilder vom Aufbau]

Die Bestückung des Mainboards erfolgte manuell. Nach der optischen Kontrolle aller Lötstellen wurde zunächst die Spannungsversorgung überprüft - die 5V und 3,3V Schienen wurden ohne Last gemessen und auf korrekte Ausgangsspannung kontrolliert. Anschließend wurde das Nucleo Board aufgesteckt und Klipper auf den STM32F446RE geflasht.

Die ersten Tests galten den Schrittmotoren. Nach dem Anschließen der Motoren zeigte sich das eine falsche Polung der Motorspulen zu einer umgekehrten Drehrichtung führt, was durch Invertierung der Drehrichtung in der Klipper-Konfiguration korrigiert werden kann. In einem Fall wurden die beiden Spulenpaare eines Motors überkreuzt angeschlossen — der Motor vibrierte stark und drehte sich nicht. Ursache ist das bei überkreuztem Anschluss die magnetischen Felder der beiden Spulen nicht mehr im richtigen Phasenverhältnis zueinander stehen und kein gerichtetes Drehmoment erzeugen können. Nach korrekter Verdrahtung drehten alle Motoren einwandfrei.

Die anschließende Inbetriebnahme der Heizkreise zeigte ein unerwartetes Verhalten: Das Hotend heizte unmittelbar nach dem Einschalten unkontrolliert auf. Die Ursache lag in der invertierenden Charakteristik des MIC4426 in Kombination mit dem beim Start undefiniertem Zustand der STM32 Pins - wie in Kapitel 2.6.1 beschrieben. Das Problem wurde durch die Invertierung der Heizpins in der Klipper-Konfiguration mit dem ! Operator behoben.

Nach der Korrektur konnte der PID-Regler für das Hotend erfolgreich kalibriert werden.

Als verbesserungswürdig stellte sich im Nachhinein heraus dass keine PWM-Steuerung für Hotend- und Gehäuselüfter vorgesehen wurde, was die Geräuschentwicklung des Druckers unnötig erhöht. Zusätzliche Versorgungsanschlüsse für 5V und 12V wären sinnvoll um externe Komponenten einfacher versorgen zu können. Ein Verpolschutz am Versorgungseingang fehlt in der aktuellen Version und sollte in einer Revision ergänzt werden um das Board vor falscher Polung zu schützen. Die Position des Nucleo Boards auf der Platine erwies sich als suboptimal und muss in einer überarbeiteten Version angepasst werden.

In einer zukünftigen Revision wäre es zudem sinnvoll den STM32F446RE direkt auf das Mainboard zu bestücken anstatt das Nucleo Development Board zu verwenden - insbesondere wenn mehr Funktionen benötigt werden. Dies würde den Formfaktor reduzieren, die Robustheit erhöhen und eine direkte USB-Verbindung zum Raspberry Pi ermöglichen ohne den Umweg über den ST-Link.

# 3 Mechanischer Aufbau

## Anforderungen an die Mechanik

Der Drucker soll einen möglichst großen Druckbereich bei gleichzeitig hoher Druckgeschwindigkeit und Präzision bieten. Die CoreXY Kinematik wurde gewählt da sie im Vergleich zu kartesischen Systemen höhere Druckgeschwindigkeiten ermöglicht, weil der Druckkopf leichter ist - die Motoren sind fix am Rahmen montiert und bewegen sich nicht mit. Der modulare Aufbau mit dem MadMax Toolchanger ermöglicht zusätzlich den Einsatz mehrerer Toolheads.

## Rahmen

Als Rahmenmaterial werden 4040 Aluminiumprofile verwendet, die durch ihre doppelte Profilbreite gegenüber den üblichen 2020 Profilen eine deutlich höhere Steifigkeit bieten. Dies reduziert Vibrationen während des Drucks und ermöglicht höhere Druckgeschwindigkeiten ohne Qualitätsverlust. Die XY-Gantry ist aus leichteren 2020 Profilen aufgebaut um das bewegte Gewicht zu minimieren.

## Kinematik

### Prinzip

Bei der CoreXY Kinematik sind beide Motoren für die X/Y Bewegung fix am Rahmen montiert. Die Bewegung des Druckkopfes ergibt sich aus der kombinierten Ansteuerung beider Motoren: Drehen beide Motoren in die gleiche Richtung bewegt sich der Druckkopf in X-Richtung, drehen sie gegenläufig in Y-Richtung. Der Riemen wird dabei in einem charakteristischen H-Muster geführt.

### Linearführungen

Für die Y-Achse werden MGN12 Linearschienen eingesetzt, für die X-Achse die schmalere MGN9. Die leichtere MGN9 auf der X-Achse reduziert das bewegte Gewicht der Gantry was sich positiv auf die erreichbare Druckgeschwindigkeit und die Resonanzfrequenz des Systems auswirkt.

### Z-Achse

Die Z-Achse wird durch drei unabhängig angesteuerte NEMA17 Motoren mit 8mm Gewindespindeln realisiert. Durch die unabhängige Ansteuerung der drei Z-Motoren kann das Druckbett automatisch ausgerichtet werden - Klipper gleicht Unebenheiten durch unterschiedliche Ansteuerung der drei Motoren aus (Z-Tilt).

## Druckbett

Das beheizte Druckbett hat eine Fläche von 400 × 400mm. Die Verbindung zwischen Druckbett und den drei Z-Spindeln erfolgt über eine Maxwell Kupplung. Diese kinematische Kupplung besteht aus drei Kontaktpunkten die das Druckbett eindeutig und reproduzierbar positionieren ohne es zu überkoppeln - das Bett kann sich thermisch ausdehnen ohne Verspannungen zu erzeugen, und ist gleichzeitig jederzeit einfach abnehmbar.

### Maxwell Kupplung

Eine Maxwell Kupplung ist eine kinematische Lagerung die auf dem Prinzip der exakten Zwangsbedingung basiert. Ein starrer Körper im dreidimensionalen Raum hat sechs Freiheitsgrade - drei translatorische (X,Y,Z) und drei rotatorische. Um ihn eindeutig zu positionieren müssen genau sechs Freiheitsgrade gebunden werden, nicht mehr und nicht weniger. Werden mehr als sechs Freiheitsgrade gebunden spricht man von Überbestimmung, was zu Verspannungen und Verzug führt - besonders problematisch bei thermischer Ausdehnung. Die Maxwell Kupplung löst dieses Problem durch drei Kontaktpunkte mit je zwei Freiheitsgradbindungen, was genau sechs ergibt. Das Druckbett liegt damit eindeutig und reproduzierbar auf, kann sich thermisch ausdehnen ohne Verspannungen zu erzeugen, und kehrt nach dem Abnehmen und Wiederaufsetzen exakt in dieselbe Position zurück.

## Toolchanger

Als Toolchanger System wird der MadMax von zruncho verwendet. Dieser ermöglicht den automatischen Wechsel zwischen mehreren Toolheads während des Drucks. Im geplanten Aufbau werden zwei Toolheads eingesetzt. Jeder Toolhead ist mit einem eigenen Extrudermotor, Hotend und Bauteilkühlung ausgestattet sodass kein Kabelwechsel beim Toolwechsel erforderlich ist.

Der Verriegelungsmechanismus ist rein passiv und kommt ohne Servos oder Aktoren aus. Der Toolhead trägt einen Arm mit drei leicht vorstehenden Schrauben, die Dockingstation einen entsprechenden Arm mit drei Schlitzen. Beim Ablegen fährt die Gantry den Toolhead zur Dockingstation, fädelt die Schrauben in die Schlitze ein und bewegt den Toolhead nach hinten - dabei rasten die Schrauben in den Schlitzen ein und halten den Toolhead sicher in der Dockingstation. Die Gantry kann anschließend wegfahren ohne den Toolhead mitzunehmen. Beim Aufnehmen läuft der Vorgang in umgekehrter Reihenfolge ab. Die gesamte Verriegelung erfolgt ausschließlich durch die präzise Bewegung der Gantry selbst.

## Toolhead

Als Toolhead wird der A4T (Another 4010 Toolhead) verwendet. Dieser ist für den Einsatz mit dem Bambu X1C Klon Hotend ausgelegt und verwendet einen Wrist-Watch Extruder mit BMG Dual-Drive Zahnrädern für präzisen Filamentvorschub. Die gedruckten Teile des Toolheads werden aus SLS Nylon (3201PA-F) von JLC3DP gefertigt, da dieses Material die thermischen Anforderungen in der Nähe des Hotends erfüllt.

# 4 Platzhalter

Platzhalter

# 5 Fazit und Ausblick

## Fazit

Ziel der Diplomarbeit war die Entwicklung eines modularen CoreXY 3D-Druckers mit eigenem Mainboard und eigenen Schrittmotortreiberplatinen. Der Großteil der gesetzten Ziele konnte im Rahmen der Diplomarbeit erreicht werden.

Die Treiberplatinen wurden erfolgreich entwickelt, gefertigt und in Betrieb genommen. Die UART-Kommunikation mit den TMC2209 funktioniert zuverlässig, die Motoren laufen leise und vibrationsfrei im StealthChop Modus. Das Mainboard wurde ebenfalls erfolgreich entwickelt und in Betrieb genommen - die Spannungsversorgung, die Motoransteuerung, die Heizkreise und die Temperatursensoren funktionieren wie geplant. Klipper läuft stabil auf dem STM32F446RE Nucleo Board und kommuniziert zuverlässig mit dem Raspberry Pi als Host.

Der mechanische Aufbau des Druckers ist zum Zeitpunkt der Abgabe weitgehend abgeschlossen. Der Rahmen aus 4040 Aluminiumprofilen, die CoreXY Gantry, der MadMax Toolchanger sowie der A4T Toolhead sind aufgebaut. Die Z-Achse befindet sich in der Fertigstellung.

Die Inbetriebnahme brachte einige unerwartete Herausforderungen mit sich - darunter die Zerstörung von zwei TMC2209 Treibern durch falsche Einschaltreihenfolge sowie ein unkontrolliert aufheizendes Hotend durch die invertierende Charakteristik des MIC4426. Diese Probleme konnten identifiziert, analysiert und behoben werden, was den Lerneffekt des Projekts zusätzlich erhöhte.

## Ausblick

Für eine zukünftige Revision des Mainboards sind folgende Verbesserungen geplant:

Der STM32F446RE sollte direkt auf das Mainboard bestückt werden anstatt das Nucleo Development Board zu verwenden. Dies würde den Formfaktor reduzieren, die Robustheit erhöhen und eine direkte USB-Verbindung zum Raspberry Pi ermöglichen. Gleichzeitig sollte die Position des Mikrocontrollers auf der Platine optimiert werden.

Ein Verpolschutz am Versorgungseingang fehlt in der aktuellen Version und sollte ergänzt werden um das Board vor Beschädigungen durch falsche Polung zu schützen. Zusätzliche Versorgungsanschlüsse für 5V und 12V würden die Anbindung externer Komponenten vereinfachen.

Die Lüftersteuerung sollte überarbeitet werden - PWM-Steuerung für alle Lüfterkanäle inklusive Hotend- und Gehäuselüfter würde die Geräuschentwicklung des Druckers deutlich reduzieren.

Mittelfristig ist die Fertigstellung der Z-Achse sowie die Inbetriebnahme des zweiten Toolheads geplant, womit der Drucker seinen vollen Funktionsumfang als Mehrfarb- bzw. Mehrmaterialdrucker erreicht.

# 6 Abbildungsverzeichnis

# 7 Quellenverzeichnis

Document2 C1 - Internal © OMICRON electronics GmbH 2026-06-01 1/1

Author Subject
