Sprudlwassr/FlexPrint/documents/Pachler_Diplom.docx

Diplomarbeit FlexPrint 3D-Drucker

Eckdaten:

CoreXY, Z-Achse mit 4 einzeln angesteuerten Motoren, Direct Drive, ESP32/STM32, TMC2209 Treiber, Nema 17 Stepper Motoren, V6 Hotend, Voron Style Toolhead, beheiztes Bett, Klipper oder Marlin Software

Besonderheiten:

Tauschbarer Toolhead (Schnellwechsler Prinzip)

Mainboard mit Treibern selbst designen

Eventuell eigene Spannungsversorgung

Baugröße:

noch undefiniert (mindestend 25x25x25 cm)

Tauschbarer Toolhead:

Magnetisch auswechselbar, Anschluss automatisch, Z-Achsen Endstopper magnetisch befestigt (verräumen wenn nicht gebraucht), Voron Style, V6 Hotend, wahrscheinlich zwischen Nozzlesizes wechseln

Mainboard:

ESP32/STM32, 7 Treiber auf dem Mainboard

Anschlüsse für: 7 Stepper Motoren, 3 Endstops, 2 Heizelemente, 2 Temp Sensoren, 3 Lüfter, Stromversorgung und Display mit SD-Slot (eventuell Touch)

Konstruktion:

CoreXY Prinzip, linear rails, Z-Achse mit 4 Motoren in jedem Eck, Vorrichtung fürs tauschen der Toolheads, Vorrichtung für Z-Achsen Endstop, Spanner für die Riemen entwickeln, Druckbett aussuchen (Glas, Magnetisch, etc)

Eventueller Zusatz:

Netzteil für 24V/12V DC aus Netzspannung

Ziel dieser Diplomarbeit ist die Entwicklung eines modularen CoreXY-3D-Druckers, der in Mechanik, Elektronik und Software flexibel an unterschiedliche Anforderungen angepasst werden kann. Viele handelsübliche 3D-Drucker bieten nur begrenzte Erweiterungsmöglichkeiten, insbesondere bei wechselbaren Druckköpfen oder zusätzlichen Motoren und Sensoren. Dies schränkt Einsatzmöglichkeiten in Forschung, Prototypenbau und Kleinserienfertigung ein.

Die Arbeit untersucht die Konstruktion einer stabilen CoreXY-Struktur mit linearer Führung und vier einzeln angesteuerten Z-Motoren sowie die Umsetzung eines magnetisch wechselbaren Toolhead-Systems. Ein weiterer Schwerpunkt liegt auf der Entwicklung eines eigenen Mainboards. Dabei kann ein STM32-Mikrocontroller zum Einsatz kommen, der die Steuerung aller Motoren, Sensoren und Heizelemente direkt ermöglicht. Die Integration einer geeigneten Steuerungssoftware (Klipper oder Marlin) wird ebenfalls untersucht.

Darüber hinaus wird die Praxistauglichkeit des Systems getestet, einschließlich der Kalibrierung, der Sicherheit der Stromversorgung und der Handhabung des modularen Toolhead-Systems. Ziel ist es, ein 3D-Drucksystem zu schaffen, das sowohl für Standarddrucke als auch für spezialisierte Anwendungen geeignet ist und gleichzeitig zukünftige Erweiterungen unterstützt.

Die Untersuchung umfasst also die Realisierung mechanischer, elektronischer und softwareseitiger Innovationen sowie deren Integration zu einem ganzheitlich optimierten, modularen Drucker, der die Flexibilität und Anpassbarkeit deutlich über den Standard handelsüblicher Geräte hinaus steigert.

Document2 C1 - Internal © OMICRON electronics GmbH 2024-12-20 1/1

Pachler Fabio Diplomarbeit
