Sprudlwassr/FlexPrint/documents/workload_distribution.docx

Pachler Fabio: 2 Aufgabenstellung

Elfarfar Samir: 3 Aufgabenstellung

Schauperl Christoph: 4 Aufgabenstellung

Erhart Alexander: 1 Aufgabenstellung

1   Aufgabenstellung 1: Mechanischer Aufbau & Modularität

Entwicklung eines modularen CoreXY-3D-Druckers mit Fokus auf Mechanik und Toolhead-System

- Konstruktion einer stabilen CoreXY-Struktur mit Linearschienen und vier unabhängig angetriebenen Z-Motoren.
- Entwicklung eines magnetisch wechselbaren Toolhead-Systems für verschiedene Düsendurchmesser.
- Integration einer Vorrichtung für magnetische Z-Endstopper.
- Auswahl und Implementierung eines geeigneten Druckbetts (z. B. Glas, PEI, magnetisch).
2   Aufgabenstellung 2: Elektronik & Mainboard-Design

Entwicklung einer individuellen Elektroniklösung für einen CoreXY-3D-Drucker

- Entwurf und Umsetzung eines eigenen Mainboards auf Basis des ESP32-Mikrocontrollers.
- Integration von TMC2209-Schrittmotortreibern und Ansteuerung von sieben Motoren.
- Erweiterung der Funktionalität über I²C-Schnittstellen.
- Bereitstellung aller notwendigen Anschlüsse (Heizelemente, Sensoren, Lüfter, Display, SD-Slot).
- Test und Kalibrierung der Firmware in Verbindung mit Mechanik und Elektronik.
3   Aufgabenstellung 3: Software & Steuerung

Implementierung und Optimierung der Steuerungssoftware für einen modularen 3D-Drucker

- Einrichtung und Anpassung von Klipper oder Marlin zur Ansteuerung der entwickelten Hardware.
- Implementierung der Steuerung für vier Z-Motoren und das modulare Toolhead-System.
- Optimierung der Bewegungsabläufe für CoreXY-Kinematik.
- Test und Kalibrierung der Firmware in Verbindung mit Mechanik und Elektronik.
- Integration eines benutzerfreundlichen Interfaces (z. B. Touch-Display, SD-Slot).
4   Aufgabenstellung 4: Erweiterungen & Innovationen

Entwicklung einer sicheren Stromversorgung sowie zusätzlicher Toolhead-Optionen und Schnittstellen.

- Entwicklung einer sicheren Stromversorgungslösung inkl. Netzteil- und Spannungswandlerdesign.
- Konzeption und Umsetzung zusätzlicher Toolhead-Optionen (z. B. größerer Extruder, Laser, Pastendrucker).
- Entwicklung von Mechanismen zur einfachen Erweiterbarkeit (z. B. modulare Anschlüsse, standardisierte Schnittstellen).
- Durchführung umfangreicher Tests zur Praxistauglichkeit der Erweiterungen.
- Dokumentation der Erweiterungskonzepte und Bewertung ihres Innovationspotentials.

Document2 C1 - Internal © OMICRON electronics GmbH 0000-00-00 1/1

Author Subject
