Sprudlwassr/FlexPrint/software/03_Dokumentation/Library_Code.docx

## 01.03.2026 – 10:00

Diese Dateien sind der Motor deiner App. Ohne sie wird React nicht geladen:

- index.html (im Hauptordner): Nicht löschen! Im Gegensatz zu alten React-Versionen ist das bei Vite dein Einstiegspunkt. Du kannst dort aber Dinge im <head> ändern (z. B. den Titel oder Google Fonts).
- src/main.jsx: Das ist die Brücke. Sie sagt React: "Nimm meine App und packe sie in das <div> mit der ID root in der index.html."
- package.json & package-lock.json: Hier stehen deine installierten Pakete drin.
- vite.config.js: Die Konfiguration für deinen lokalen Server.

Desktop Zuhause installiert:
npm install react-router-dom → mehrere Seiten
Konzept: Du definierst Routen wie /dashboard oder /jobs. Je nachdem, welcher Link unten in deiner Leiste geklickt wird, zeigt React eine andere Komponente an.

npm install react-grid-layout → Widgets
