Sprudlwassr/FlexPrint/hardware/TMC2209_driver/TMC2209_driver/Prüfungen_Platine.xlsx

Messungen Treiberplatine
 | Eingangswiderstand (VIO) |  | Eingangswiderstand (VM)
Gekauft | 948k |  | 981k
Nr. 1 | 946k |  | 945k
Nr. 2 | 941k |  | 941k
Nr. 3 | 938k |  | 942k
Nr. 4 | 4.6M Ohm | Treiberchip sitzt nicht korrekt! | 4M | treiberchip getauscht/neu gelötet nichts gebracht
Nr. 5 | 941k |  | 941k
Nr. 6 | 933k | noch nicht assembliert | 932k
Nr. 7 | 925k |  | 925k
