Sprudlwassr/FlexPrint/documents/Doku_Fab.docx

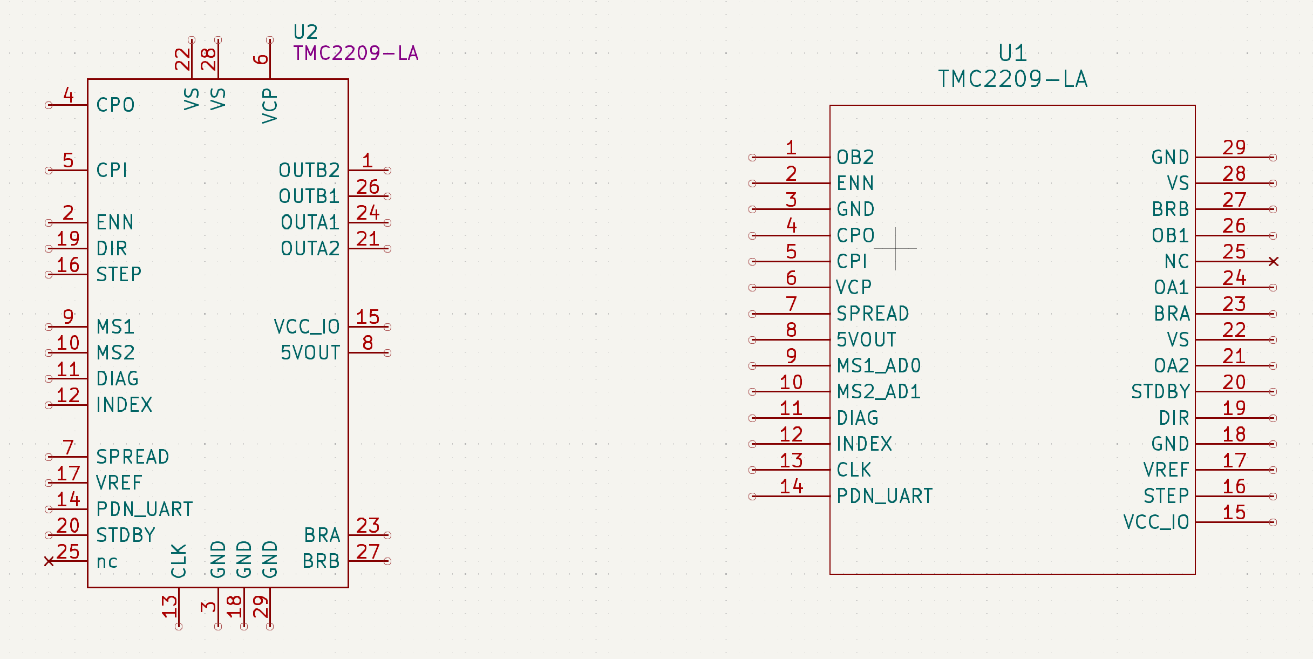
[picture p14: figure]

Vergleich Online KiCad Symbol des TMC2209 zu selbst designtem Symbol für den Treiber. Gut erkennbar, dass im Online auffindbaren Design die Pinbelegung effektiv unbrauchbar ist für den Schaltplan da die Pins der Reihe nach von 1-28 hochzählen. Das selbst erstellte Symbol bietet eine gut nutzbare und funktionale Pin-Reihenfolge für den Schaltplan.

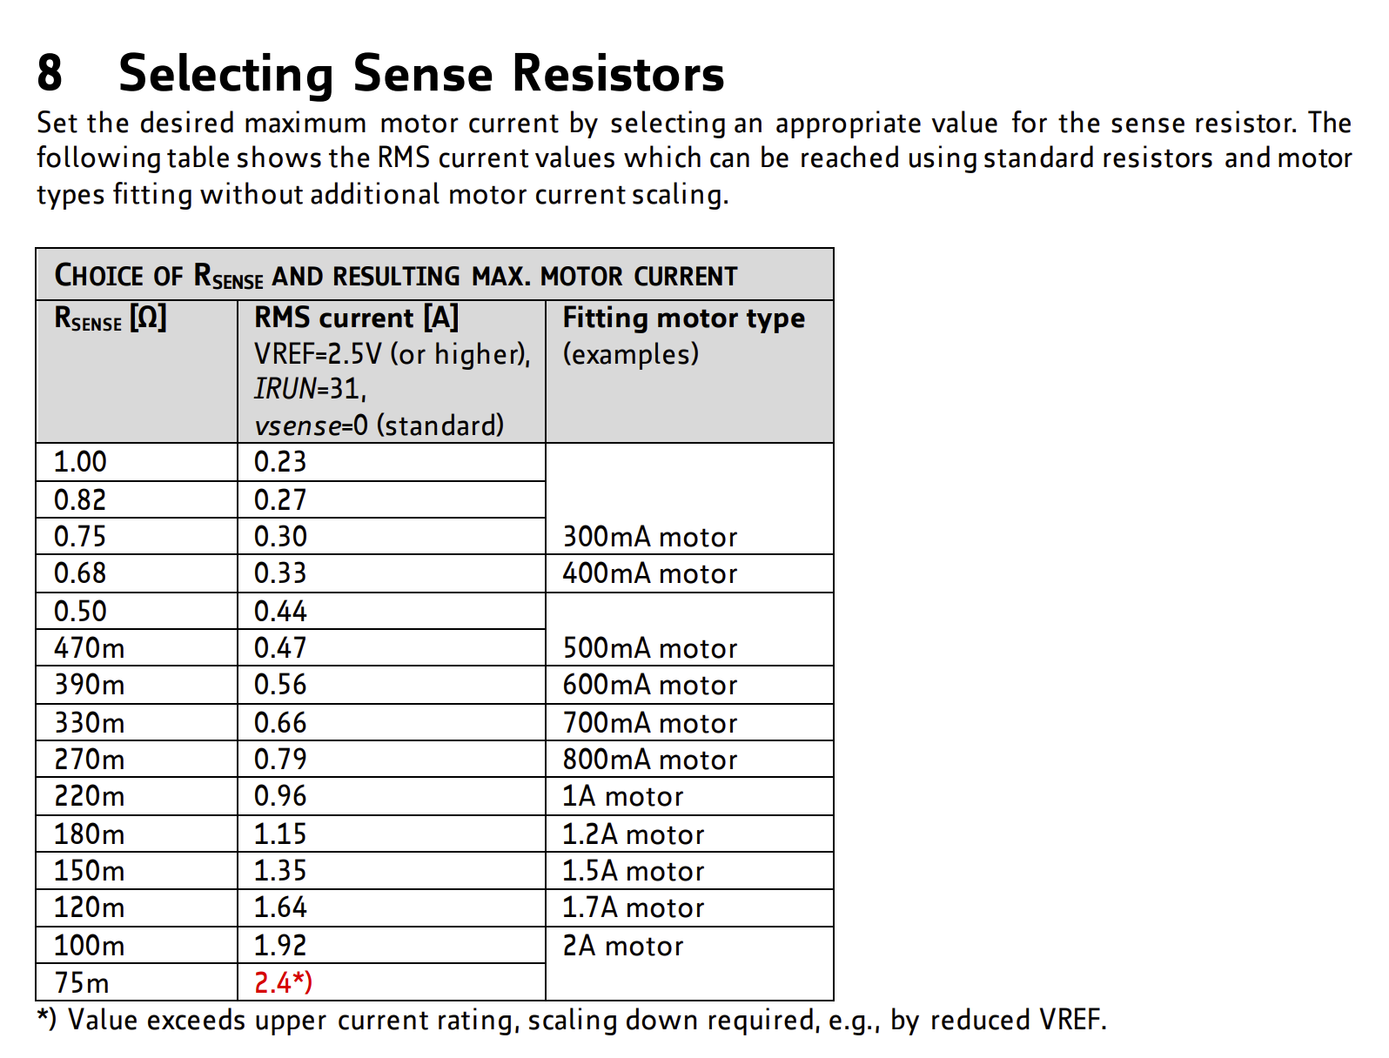
[picture p15: figure]

Block diagramm

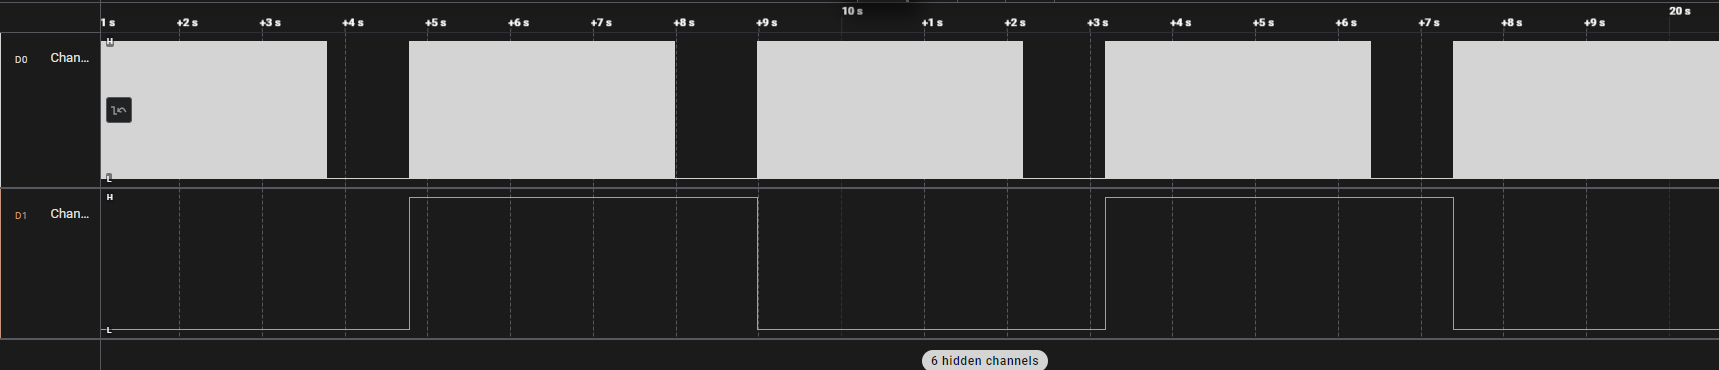
[picture p16: figure]
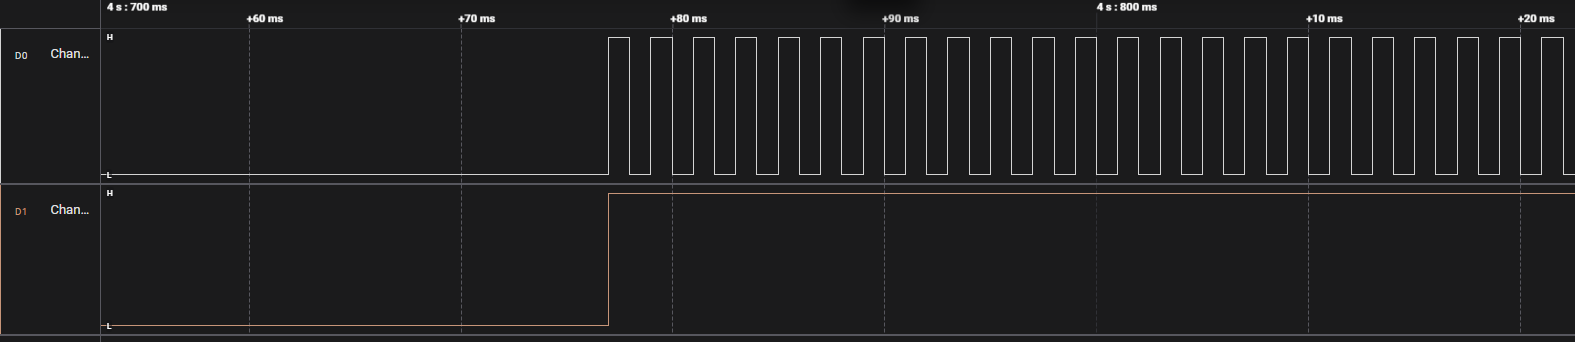
[picture p17: figure]
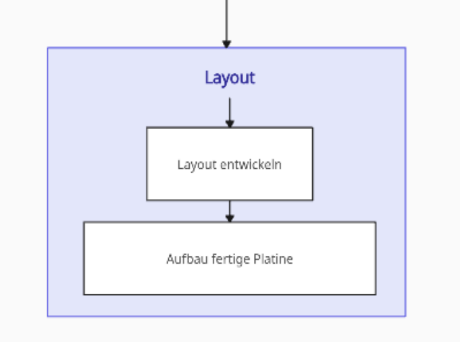
[picture p18: figure]
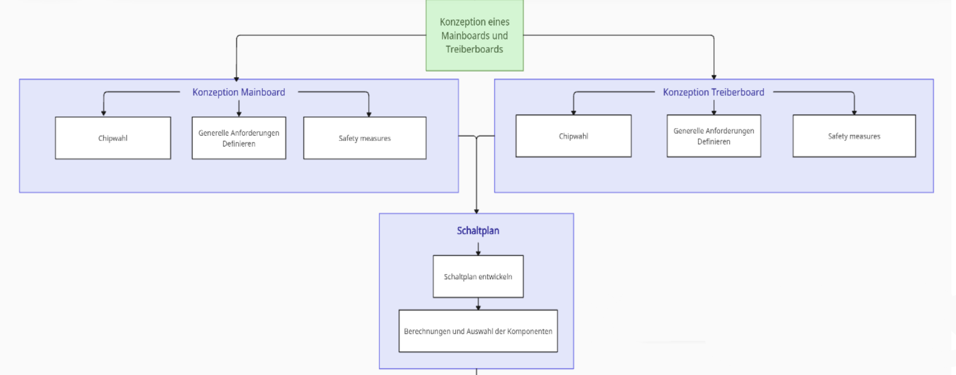
[picture p19: figure]

Document2 C1 - Internal © OMICRON electronics GmbH 2025-10-24 1/1

Author Subject
