Sprudlwassr/FlexPrint/documents/graphics/20260612_094405.png

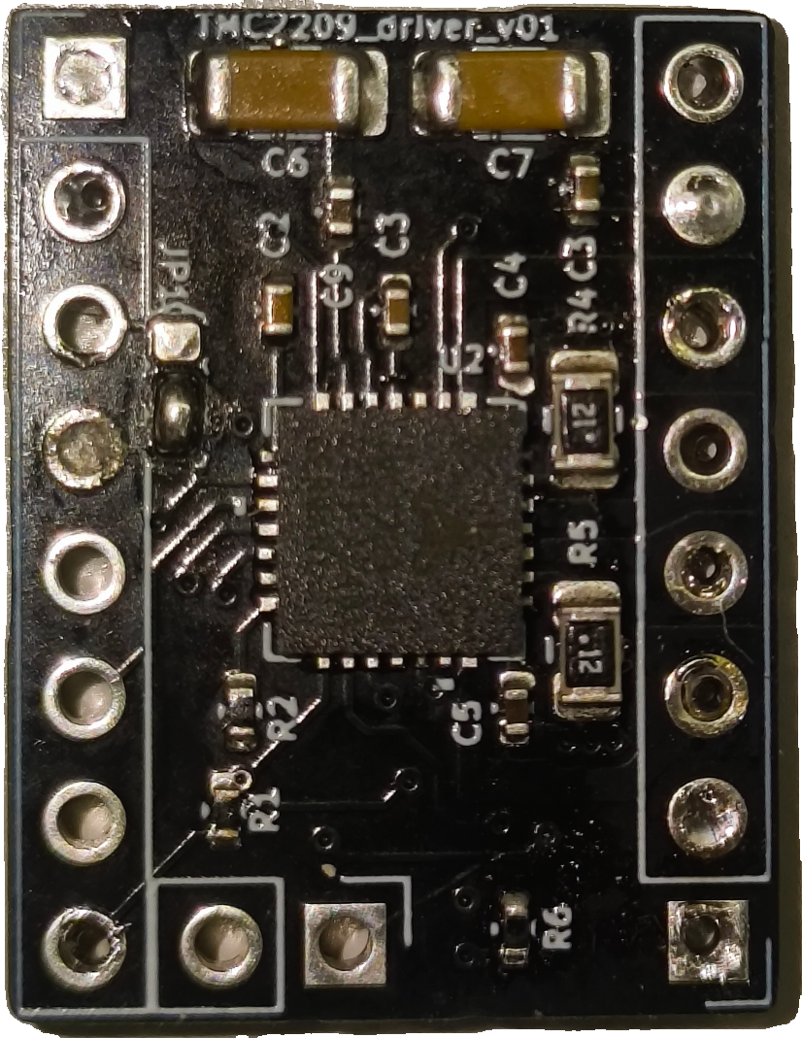
documents/graphics/20260612_094405.png
