Sprudlwassr/FlexPrint/documents/graphics/20260612_094429.png

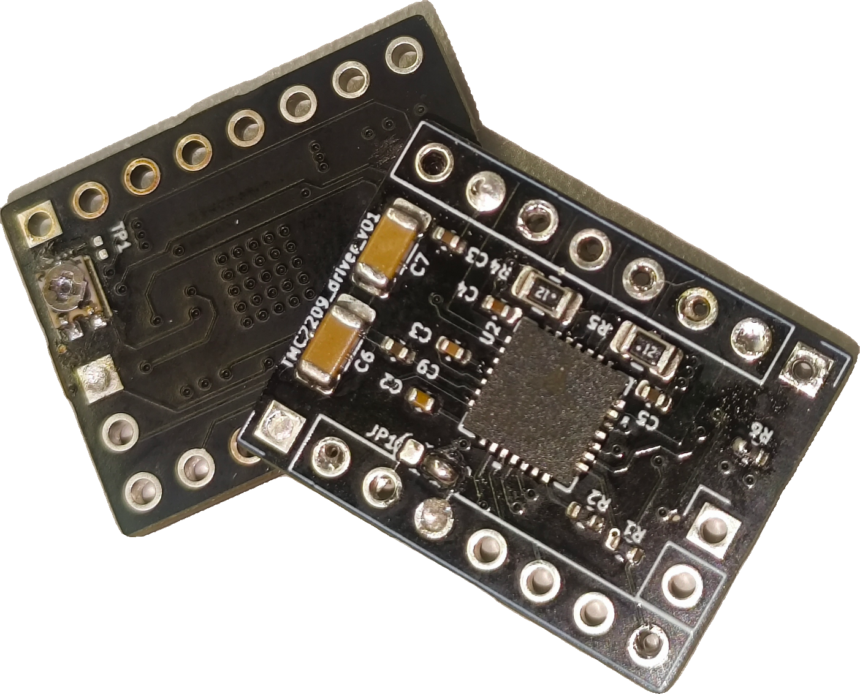
documents/graphics/20260612_094429.png
