Sprudlwassr/FlexPrint/documents/graphics/IMG_20260116_090915169.jpg

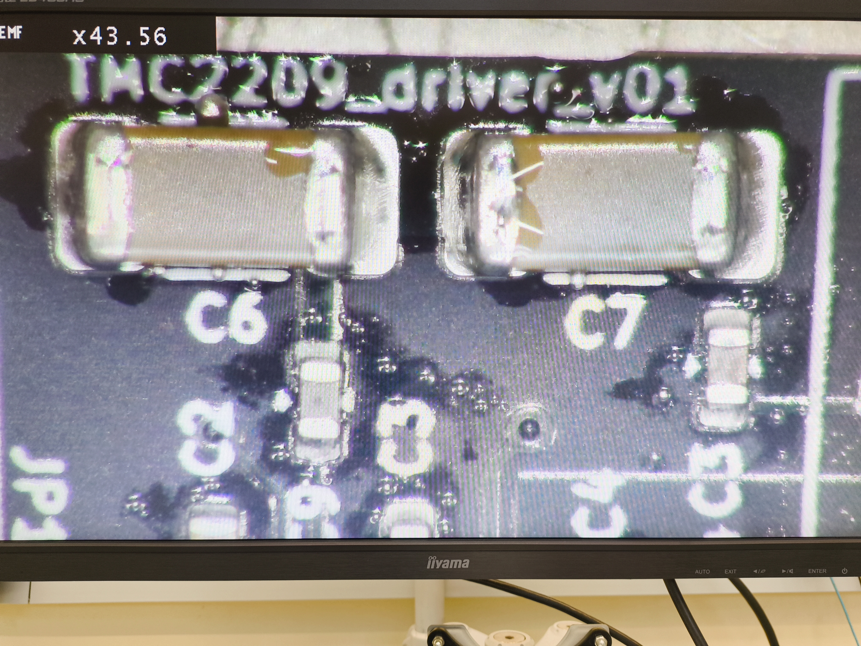
documents/graphics/IMG_20260116_090915169.jpg
