Sprudlwassr/FlexPrint/documents/graphics/IMG_20260116_090921096.jpg

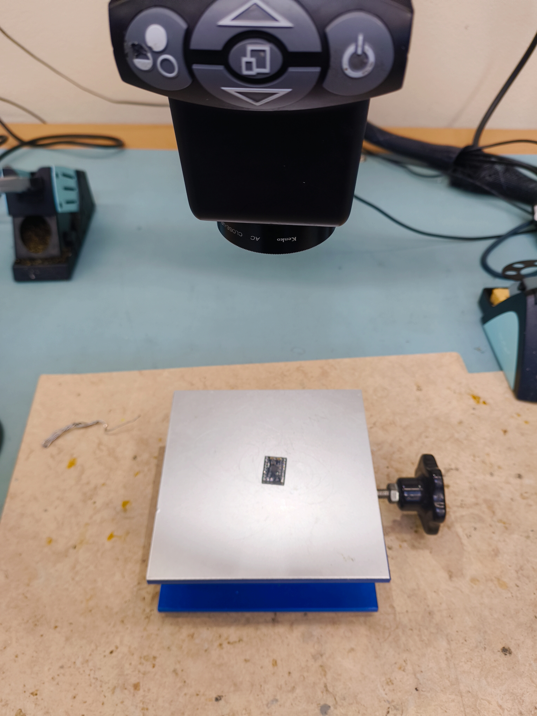
documents/graphics/IMG_20260116_090921096.jpg
