Sprudlwassr/FlexPrint/documents/graphics/IMG_20260116_090933248.jpg

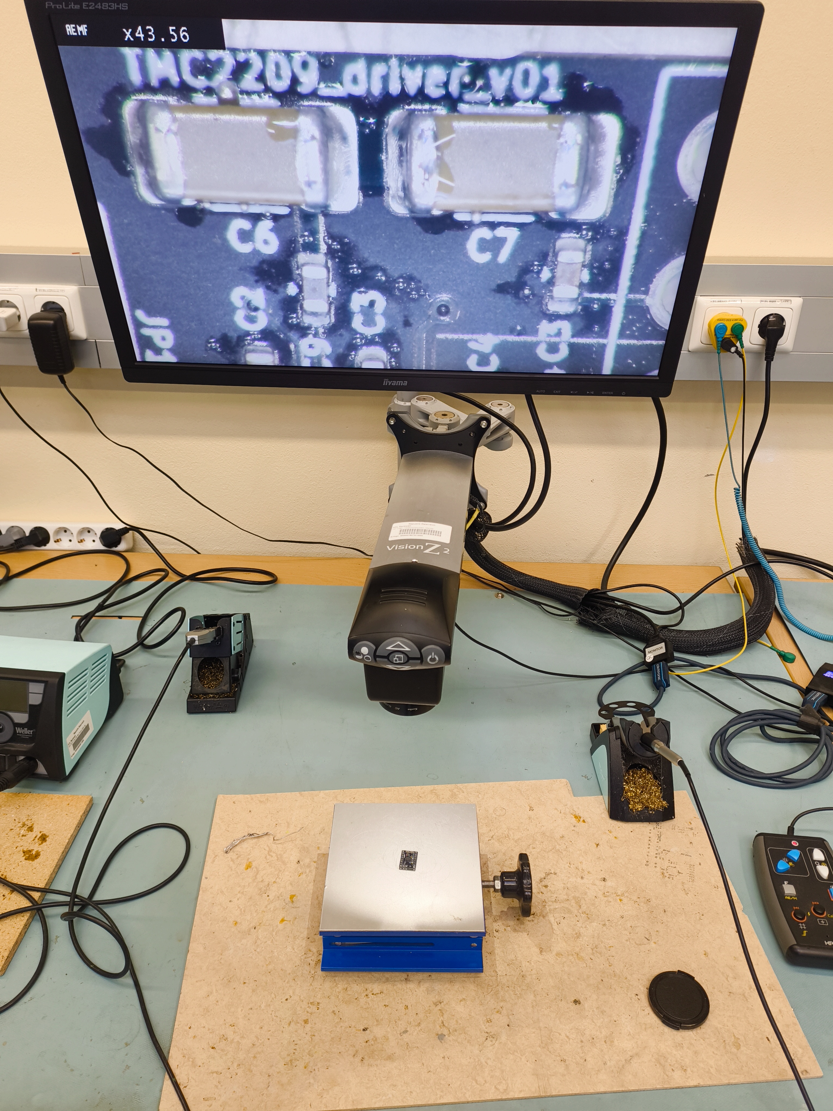
documents/graphics/IMG_20260116_090933248.jpg
