Sprudlwassr/FlexPrint/documents/graphics/IMG_20260116_173826928.jpg

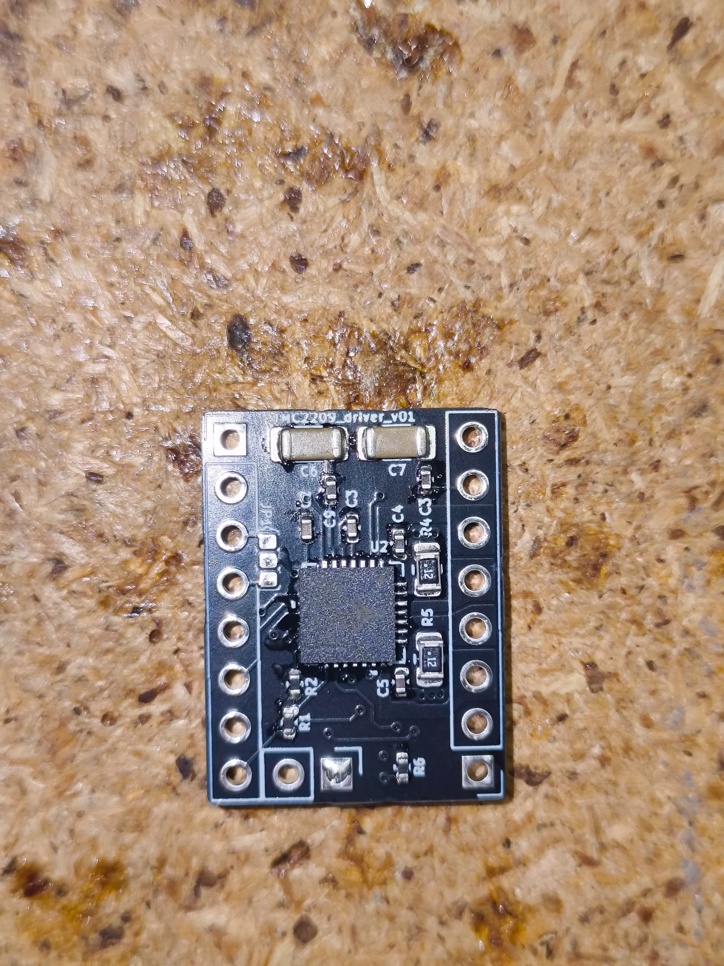
documents/graphics/IMG_20260116_173826928.jpg
