Sprudlwassr/FlexPrint/documents/graphics/IMG_20260116_173841268.jpg

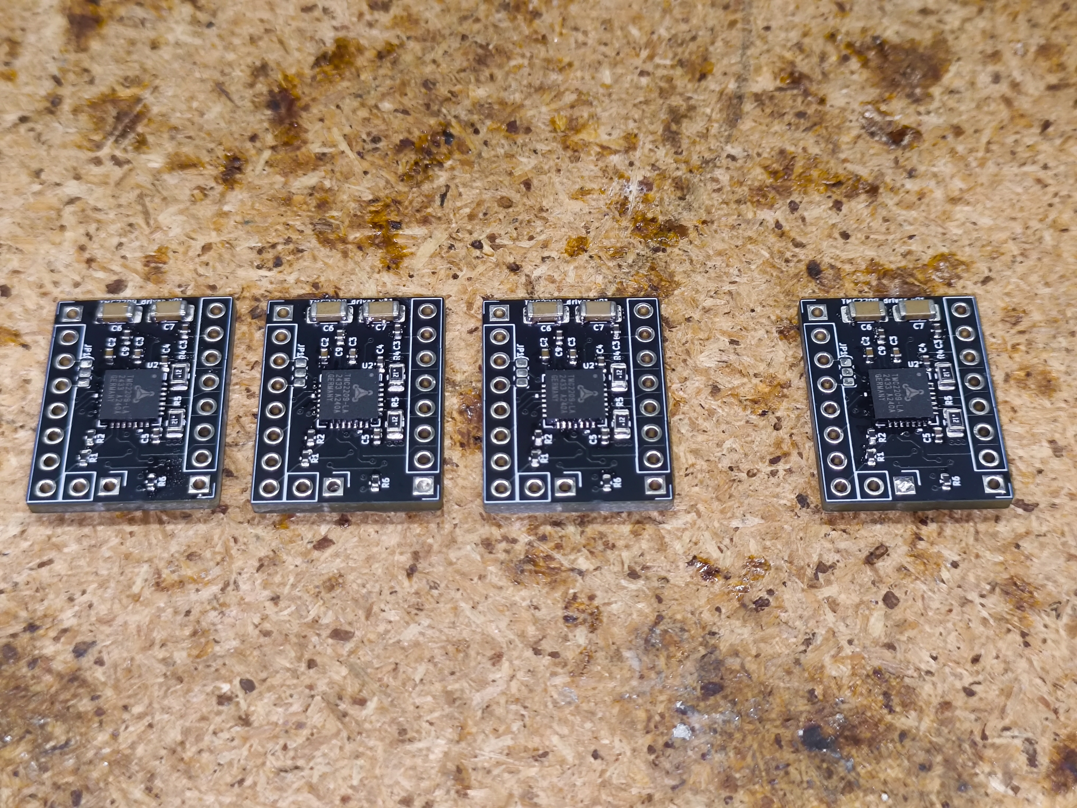
documents/graphics/IMG_20260116_173841268.jpg
