Sprudlwassr/FlexPrint/documents/graphics/IMG_20260116_175146983.jpg

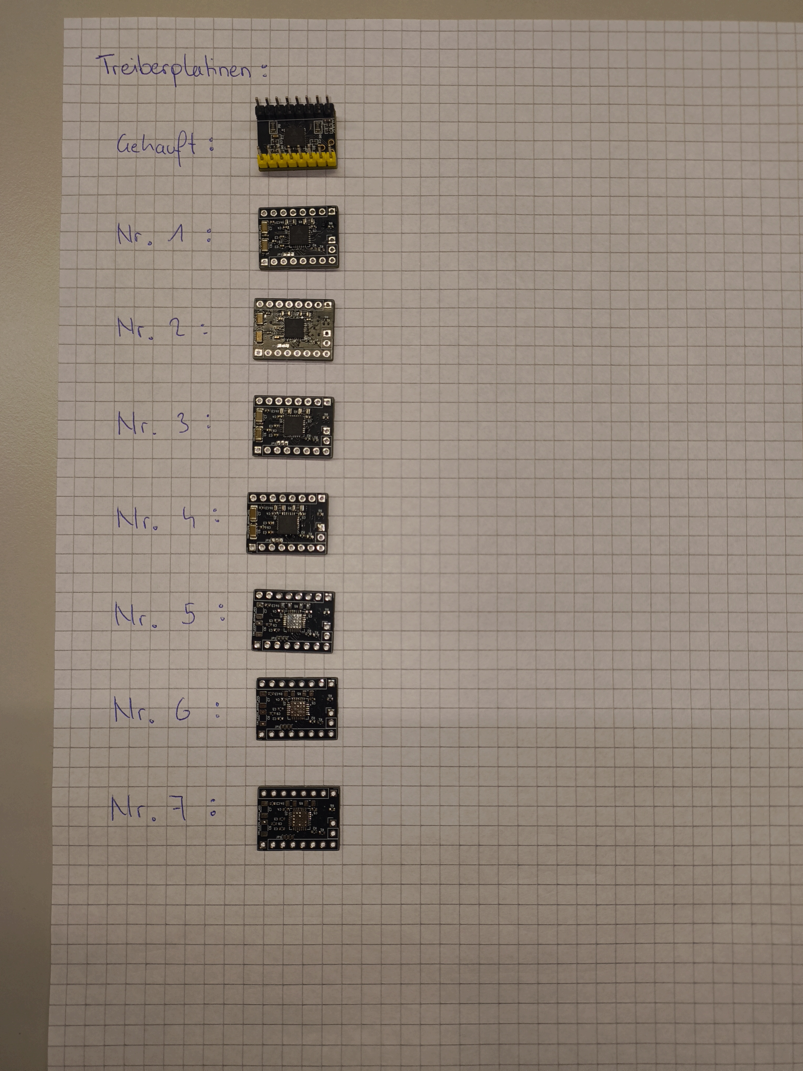
documents/graphics/IMG_20260116_175146983.jpg
