Sprudlwassr/FlexPrint/documents/graphics/IMG_20260116_175158752.jpg

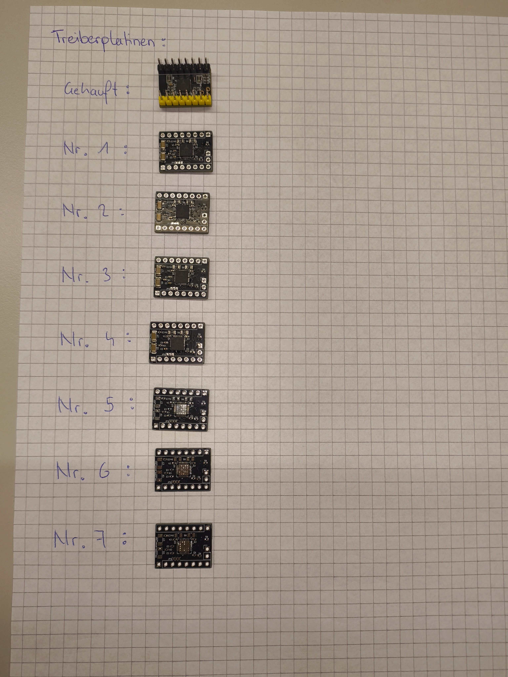
documents/graphics/IMG_20260116_175158752.jpg
