Sprudlwassr/FlexPrint/documents/graphics/IMG_20260116_175247472.jpg

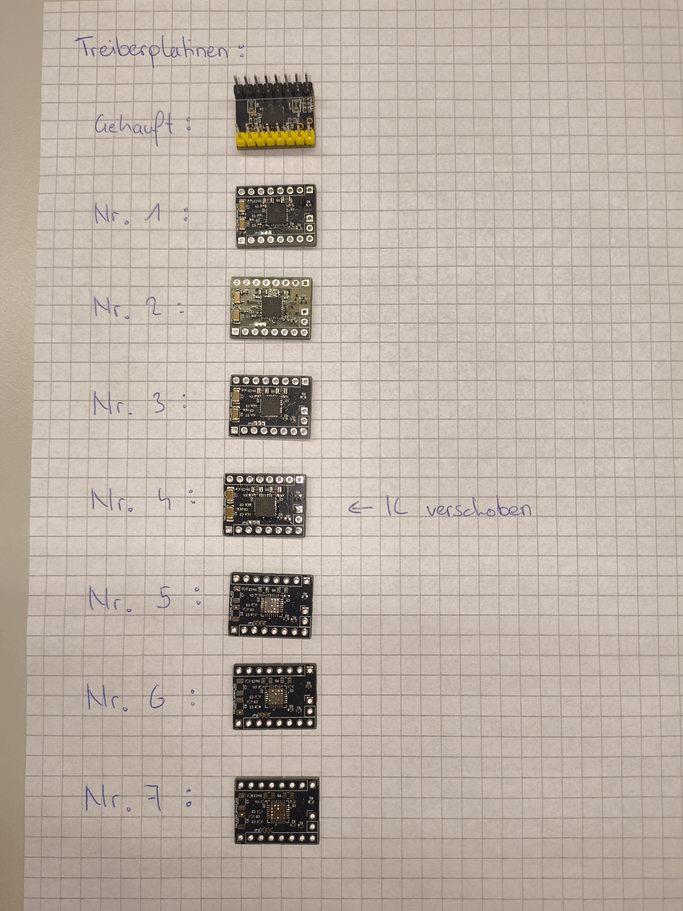
documents/graphics/IMG_20260116_175247472.jpg
