Sprudlwassr/FlexPrint/documents/graphics/IMG_20260116_175249759.jpg

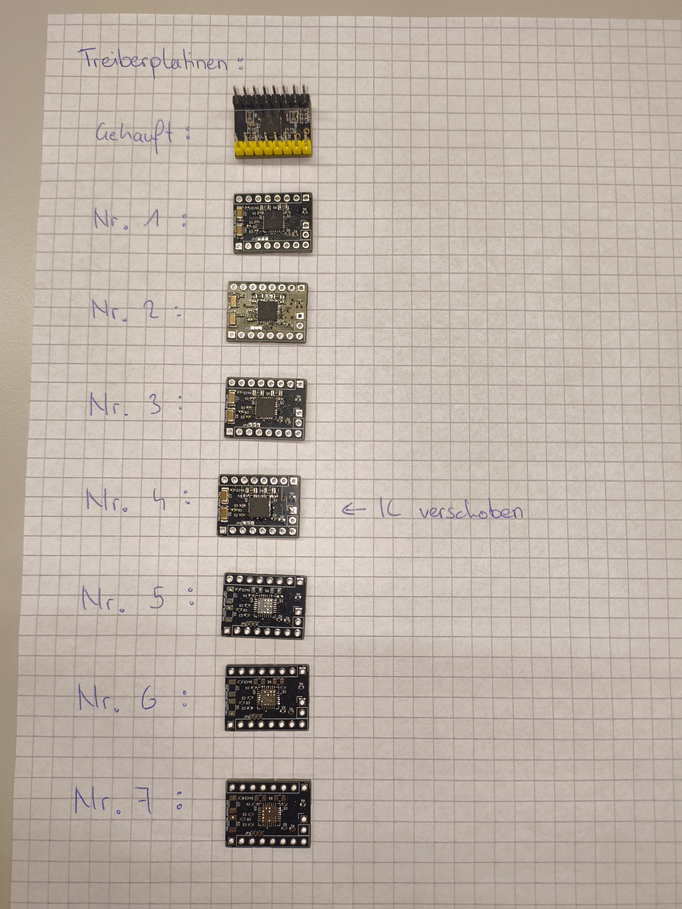
documents/graphics/IMG_20260116_175249759.jpg
