Sprudlwassr/FlexPrint/documents/graphics/IMG_20260123_173235296.jpg

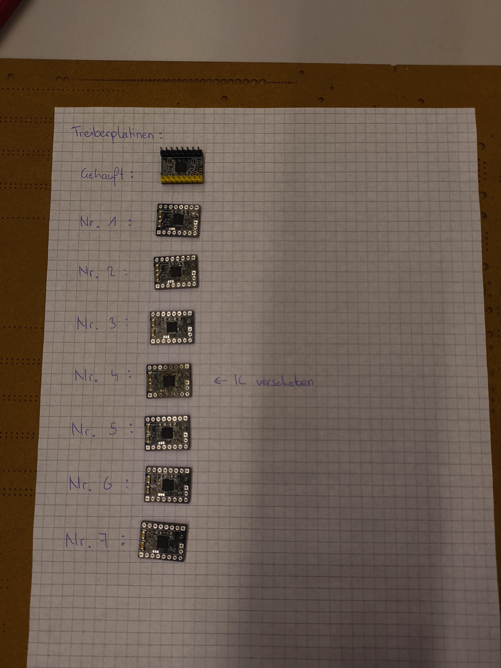
documents/graphics/IMG_20260123_173235296.jpg
