Sprudlwassr/FlexPrint/documents/graphics/IMG_20260124_211152987.jpg

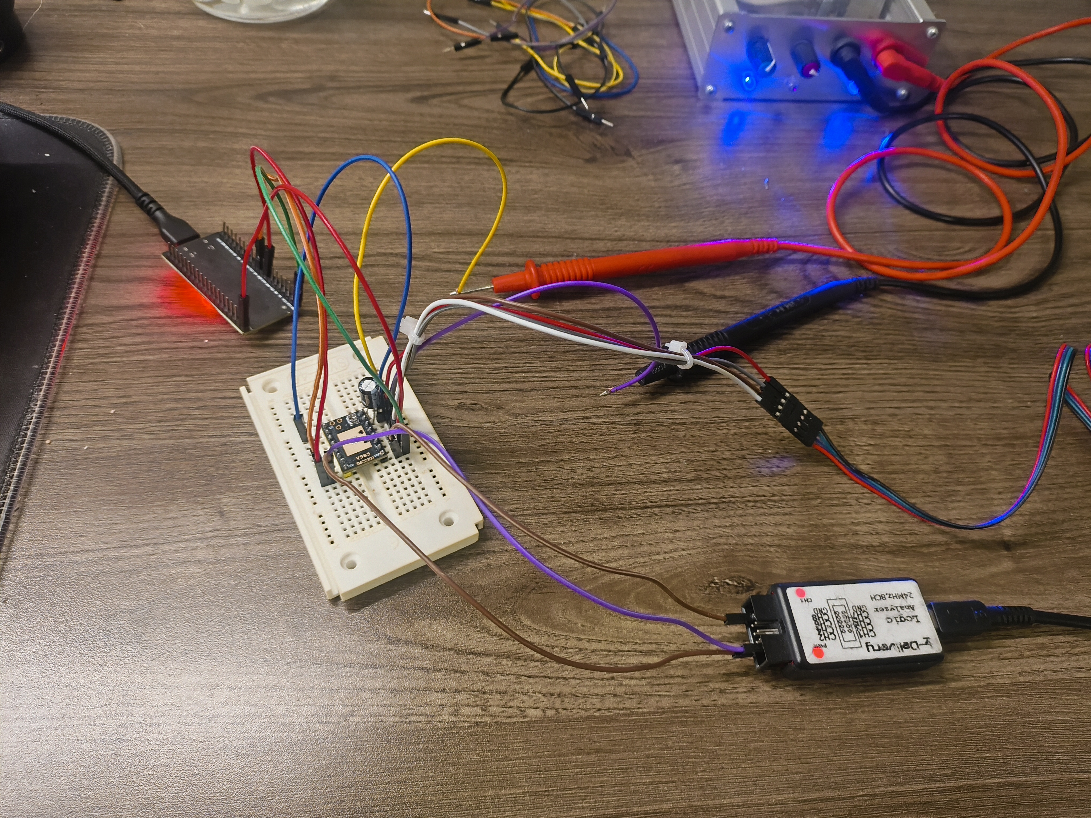
documents/graphics/IMG_20260124_211152987.jpg
