Sprudlwassr/FlexPrint/documents/graphics/IMG_20260124_211211634.jpg

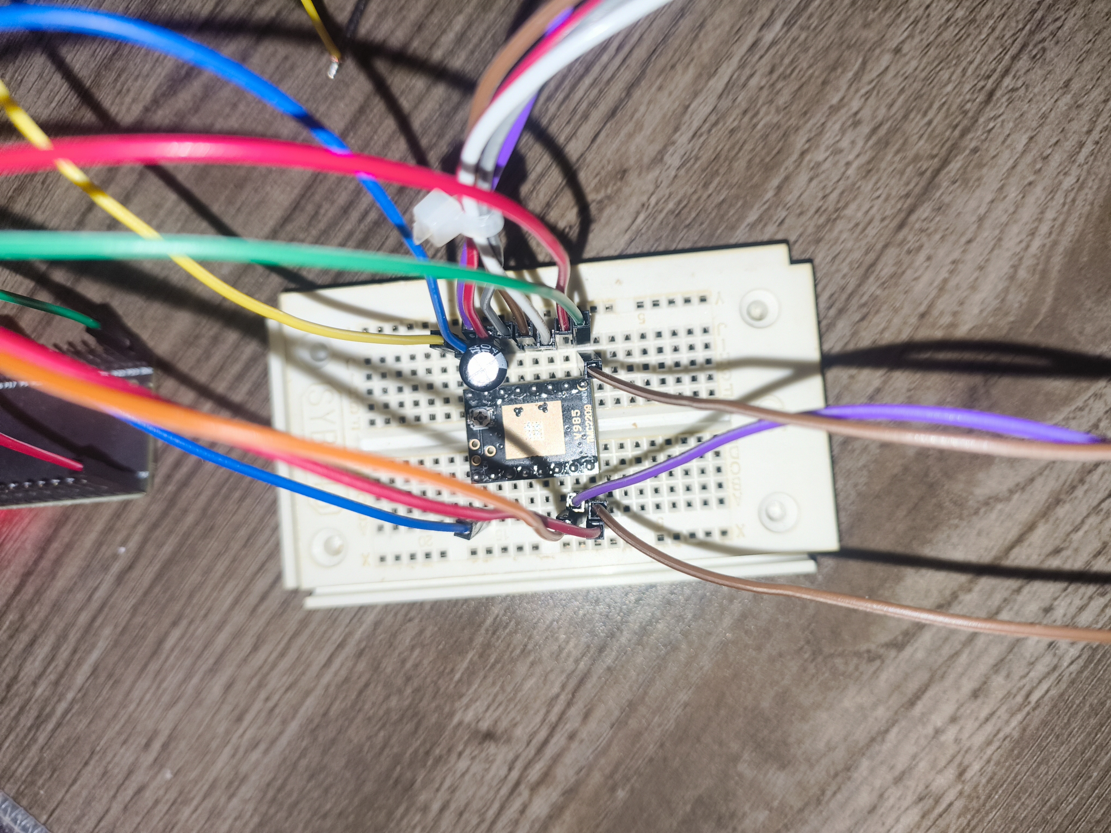
documents/graphics/IMG_20260124_211211634.jpg
