Sprudlwassr/FlexPrint/documents/graphics/IMG_20260205_154540280.jpg

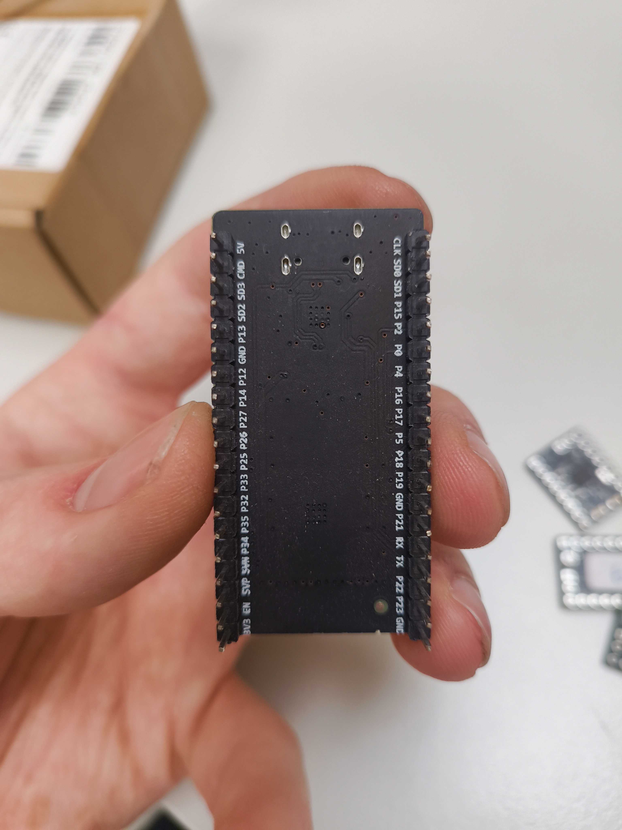
documents/graphics/IMG_20260205_154540280.jpg
