Sprudlwassr/FlexPrint/documents/graphics/IMG_20260205_172449043.jpg

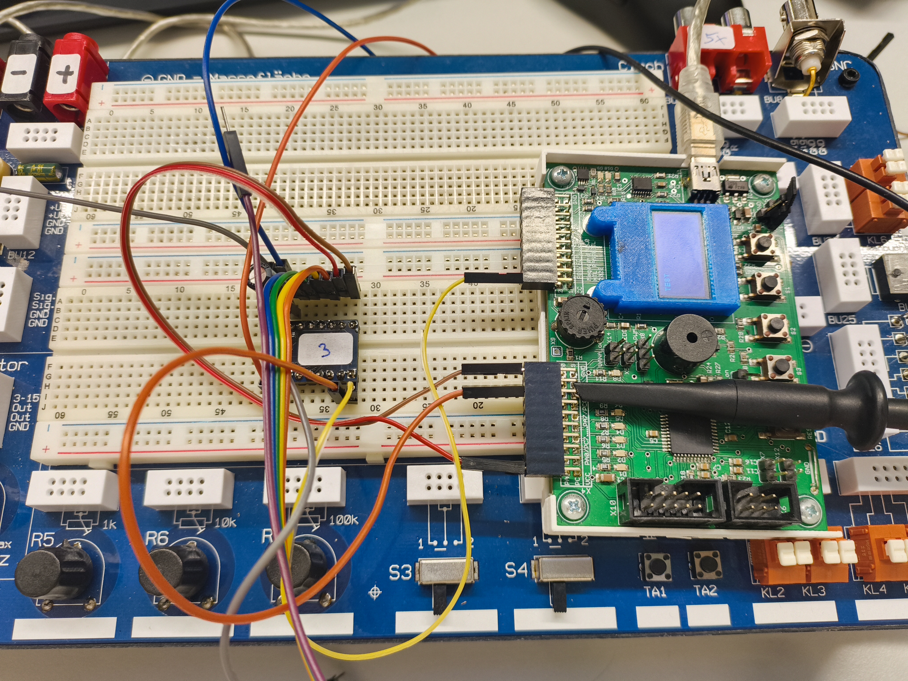
documents/graphics/IMG_20260205_172449043.jpg
