Sprudlwassr/FlexPrint/documents/graphics/IMG_20260205_172510257.jpg

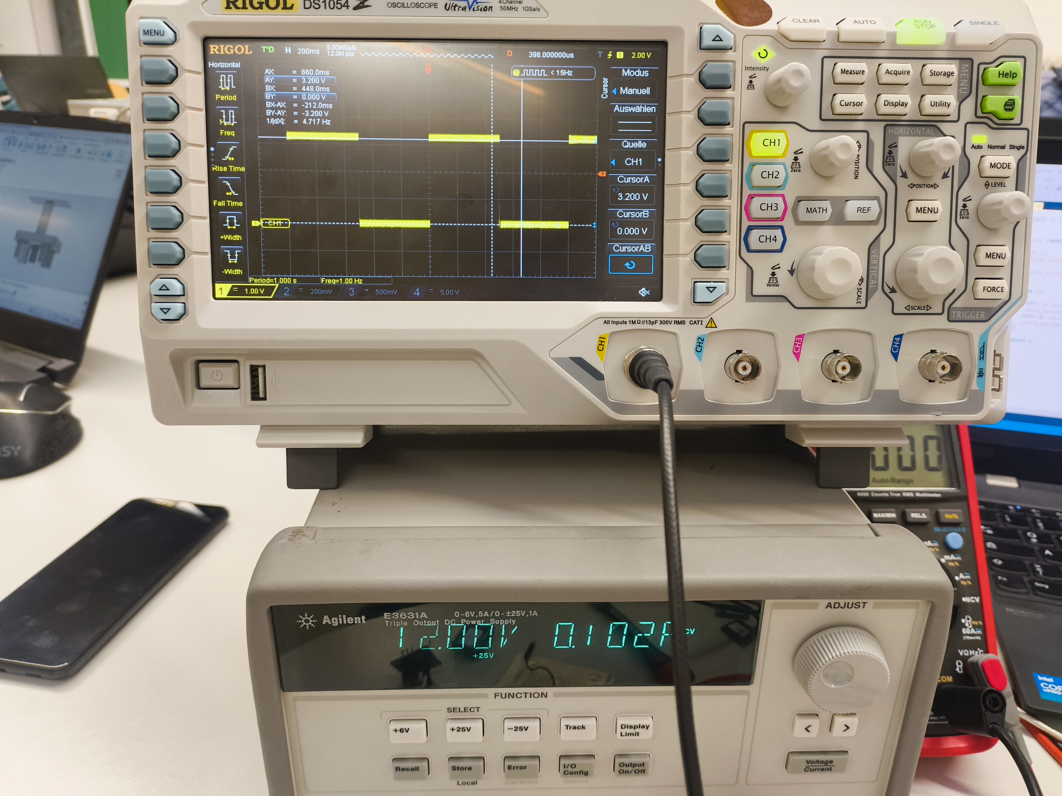
documents/graphics/IMG_20260205_172510257.jpg
