Sprudlwassr/FlexPrint/documents/graphics/IMG_20260228_110354709.jpg

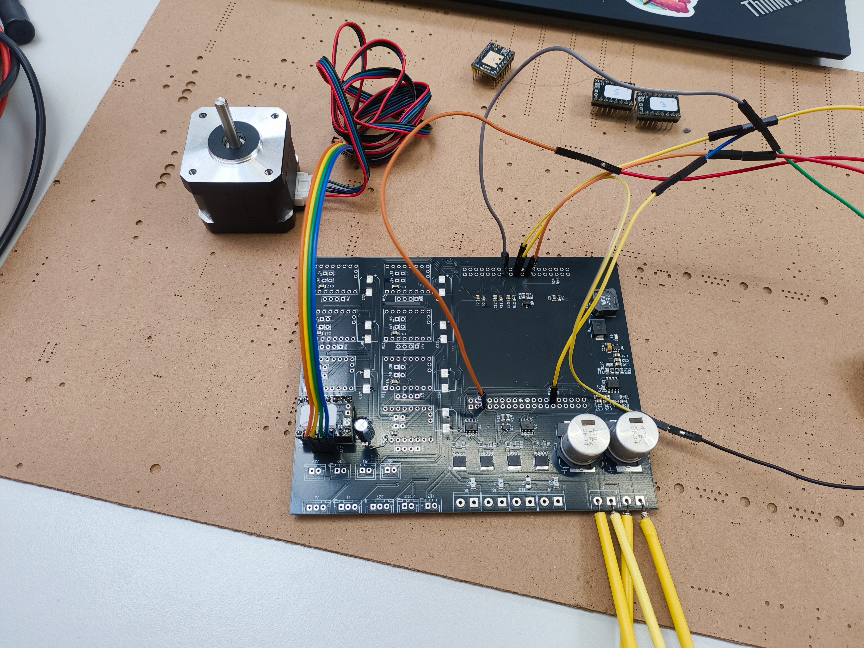
documents/graphics/IMG_20260228_110354709.jpg
