Sprudlwassr/FlexPrint/documents/graphics/IMG_20260228_110400190.jpg

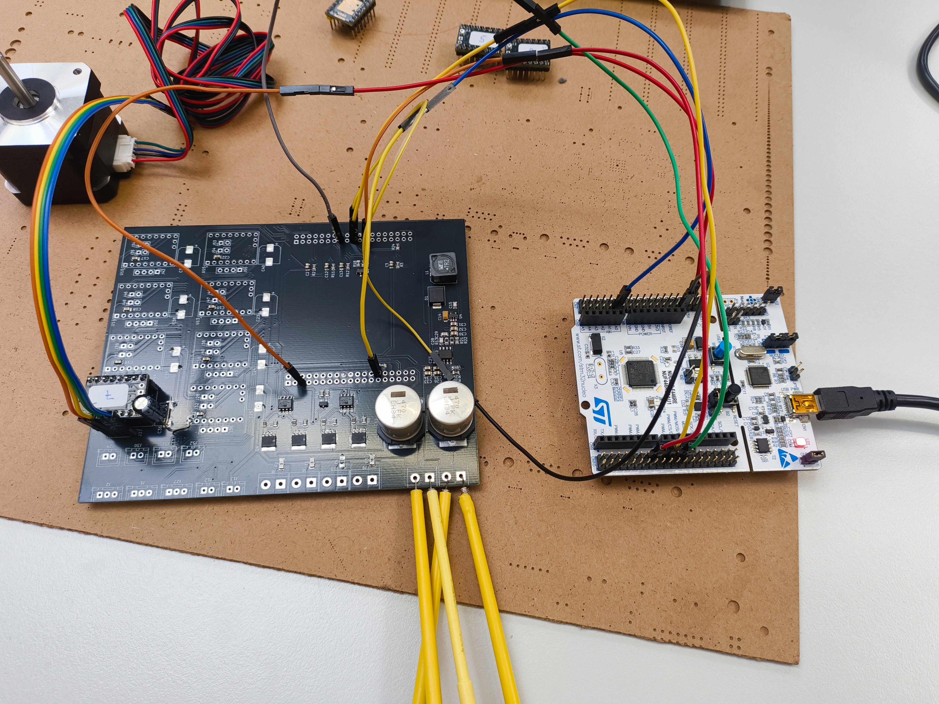
documents/graphics/IMG_20260228_110400190.jpg
