Sprudlwassr/FlexPrint/documents/graphics/IMG_20260228_110422375.jpg

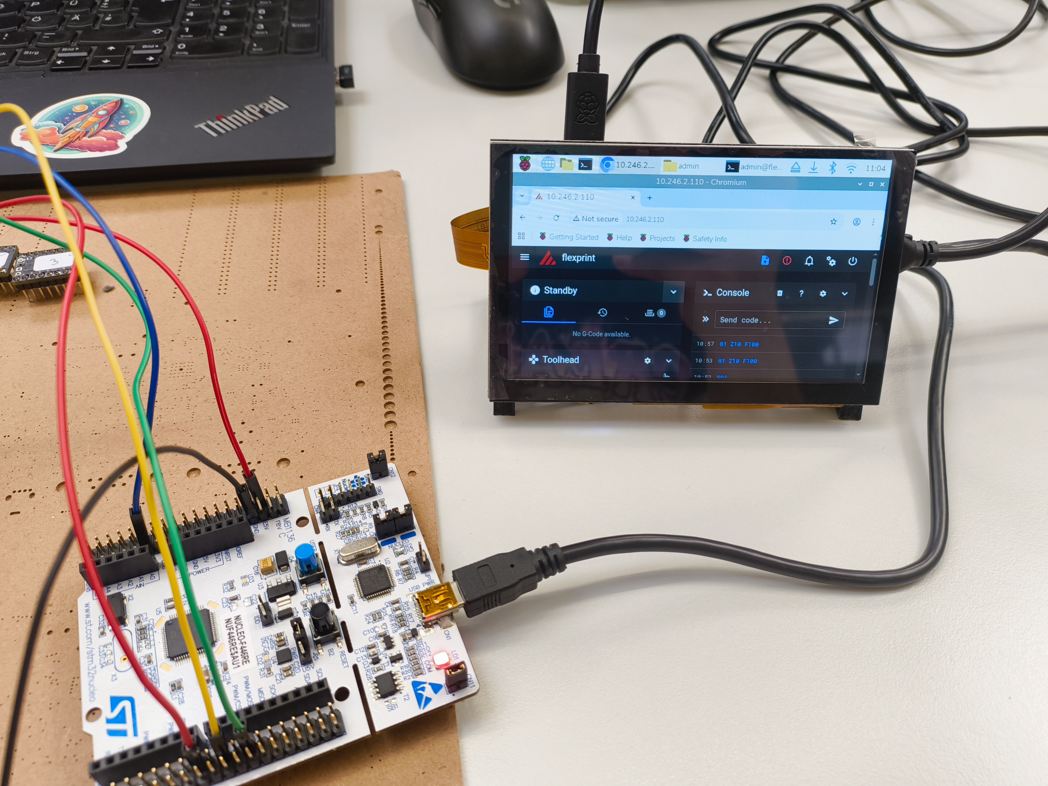
documents/graphics/IMG_20260228_110422375.jpg
