Sprudlwassr/FlexPrint/documents/graphics/IMG_20260314_154044566.jpg

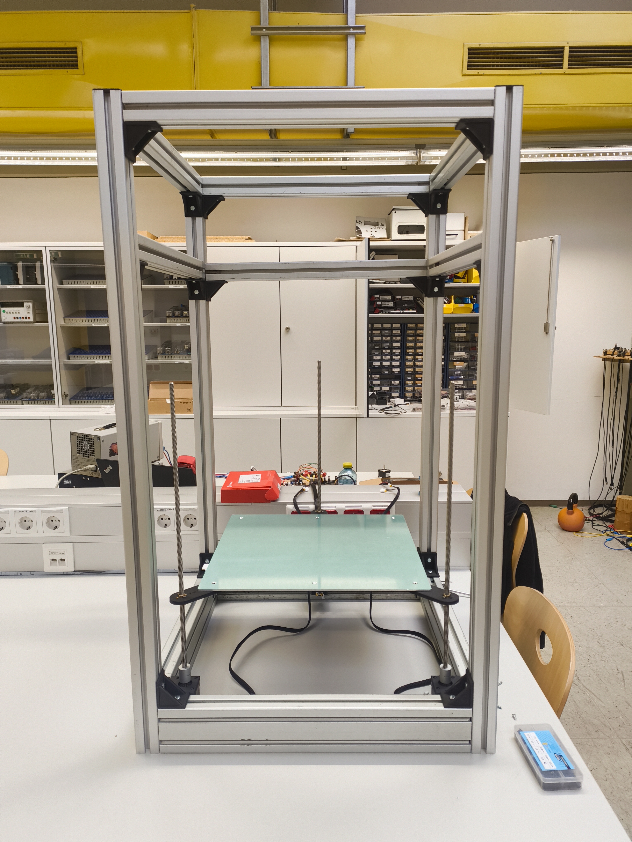
documents/graphics/IMG_20260314_154044566.jpg
