Sprudlwassr/FlexPrint/documents/graphics/IMG_20260314_215130583.jpg

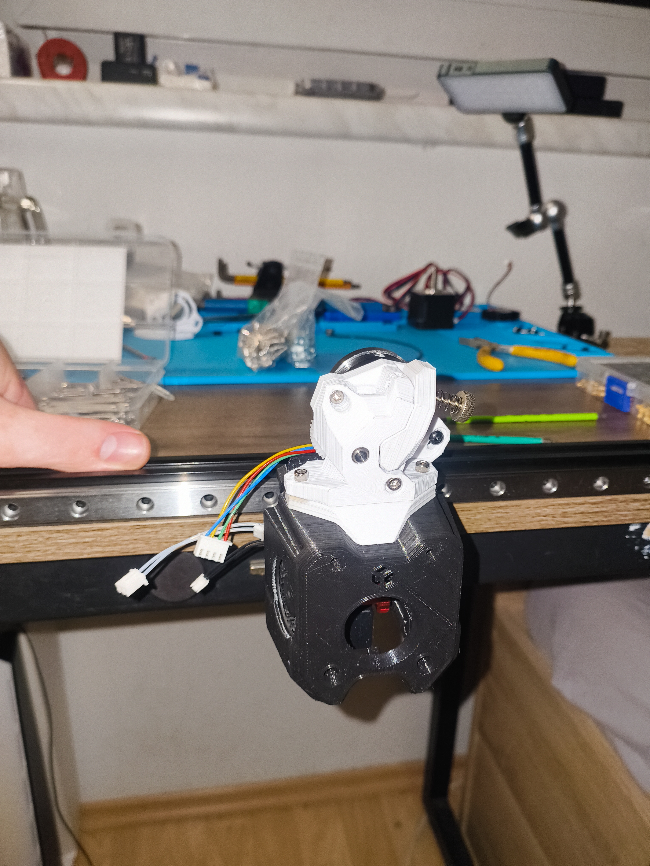
documents/graphics/IMG_20260314_215130583.jpg
