Sprudlwassr/FlexPrint/documents/graphics/IMG_20260321_155055359.jpg

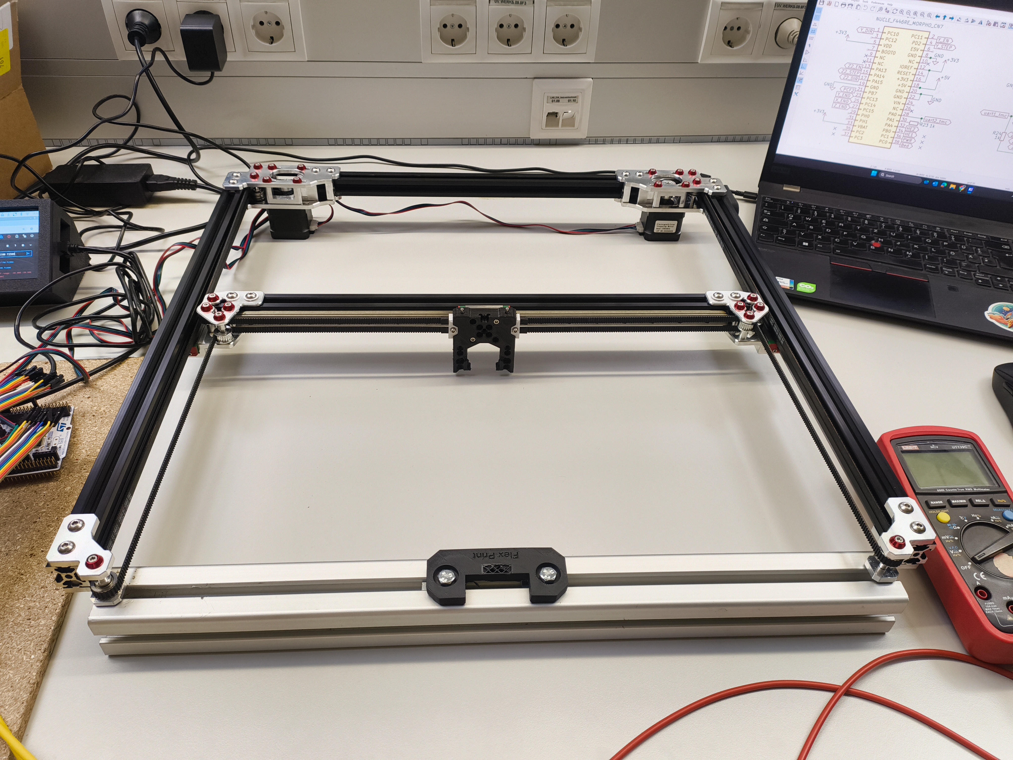
documents/graphics/IMG_20260321_155055359.jpg
