Sprudlwassr/FlexPrint/documents/graphics/IMG_20260613_175713_937.jpg

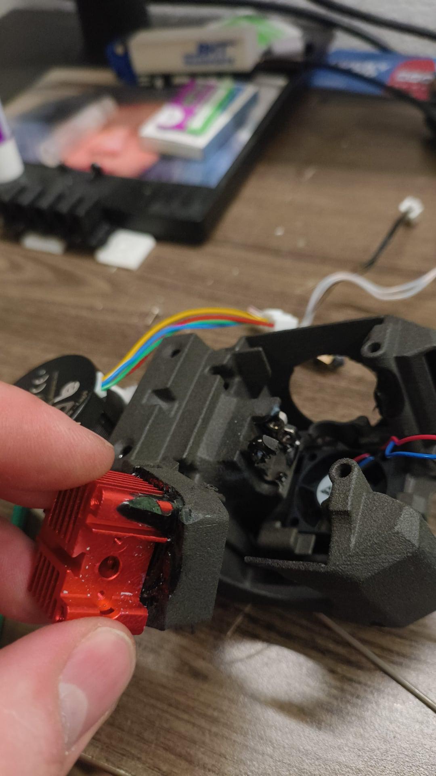
documents/graphics/IMG_20260613_175713_937.jpg
