Sprudlwassr/FlexPrint/documents/graphics/IMG_20260613_175716_790.jpg

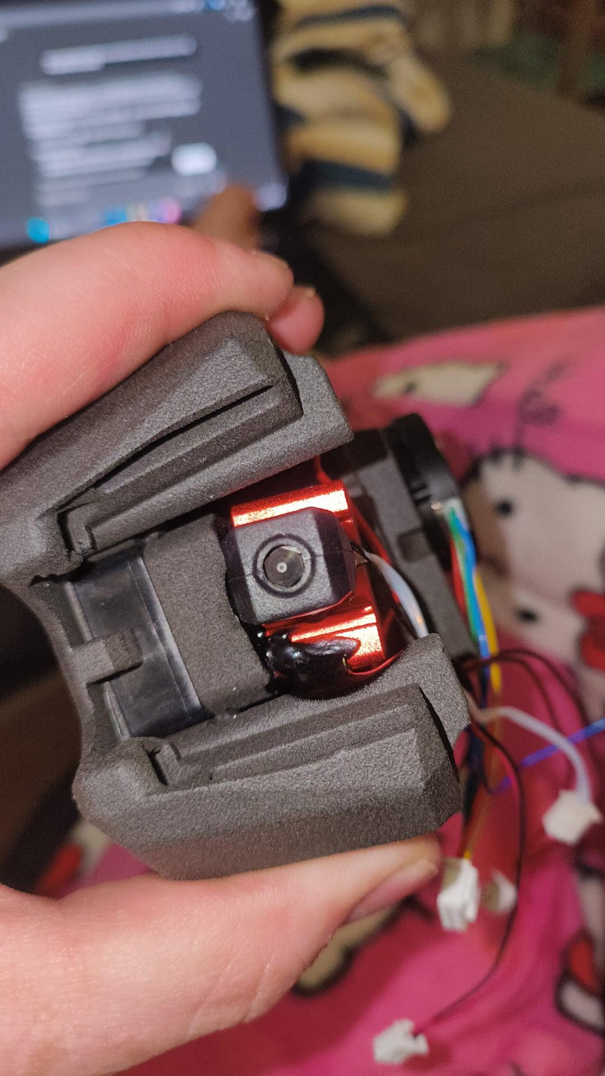
documents/graphics/IMG_20260613_175716_790.jpg
