Sprudlwassr/FlexPrint/documents/graphics/IMG_20260613_175910_537.jpg

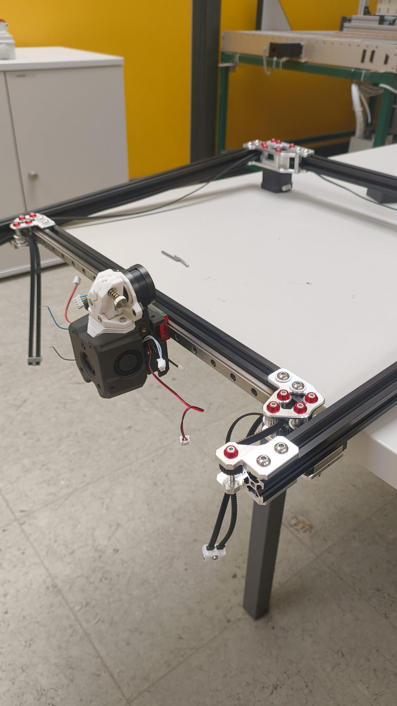
documents/graphics/IMG_20260613_175910_537.jpg
