Sprudlwassr/FlexPrint/documents/graphics/IMG_20260614_152534347.jpg

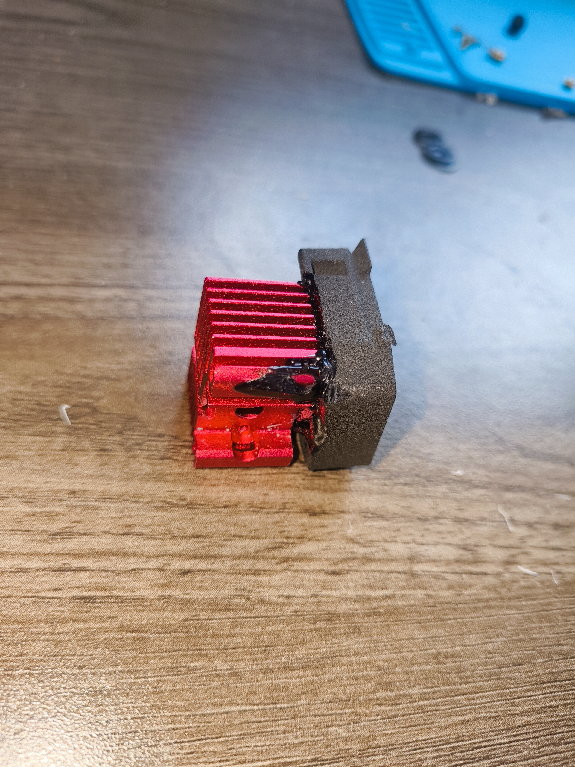
documents/graphics/IMG_20260614_152534347.jpg
