Sprudlwassr/FlexPrint/documents/graphics/IMG_20260614_152547085.jpg

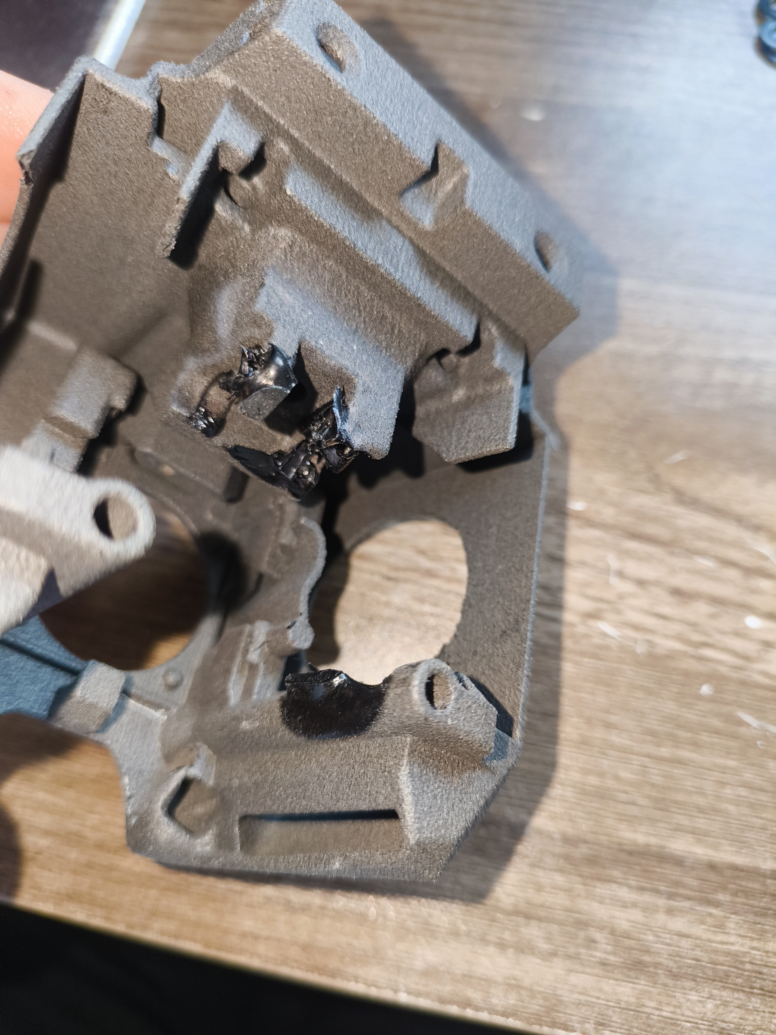
documents/graphics/IMG_20260614_152547085.jpg
