Sprudlwassr/FlexPrint/documents/graphics/IMG_20260614_152630357.jpg

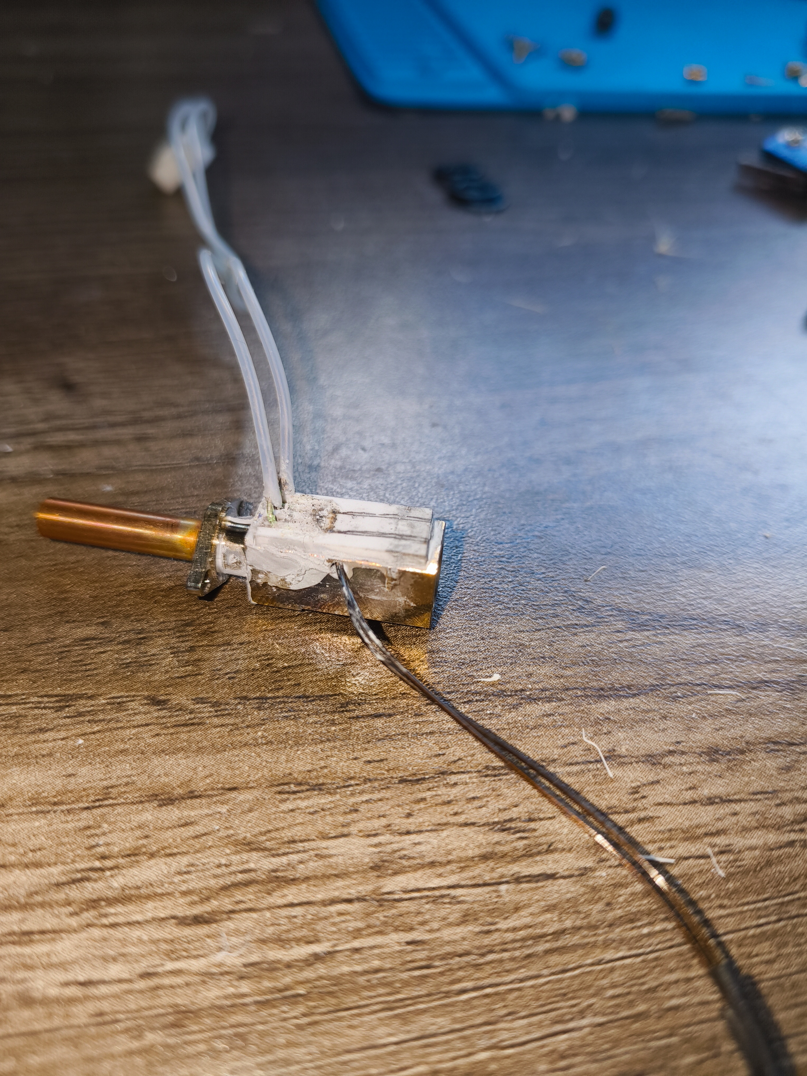
documents/graphics/IMG_20260614_152630357.jpg
