Sprudlwassr/FlexPrint/documents/graphics/IMG_20260614_153145328.jpg

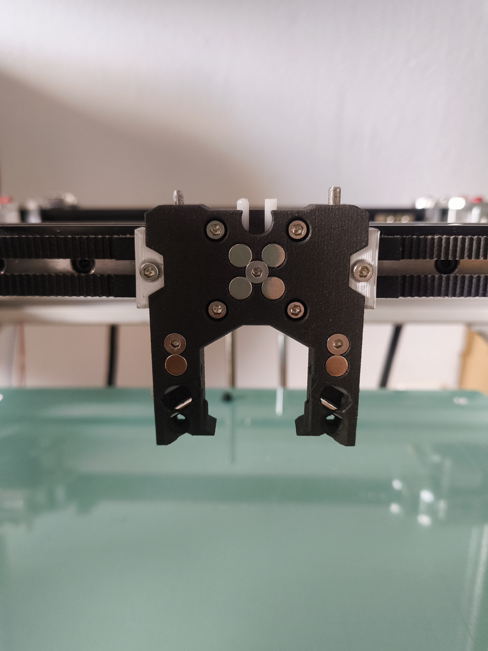
documents/graphics/IMG_20260614_153145328.jpg
