Sprudlwassr/FlexPrint/documents/graphics/IMG_20260614_153150263.jpg

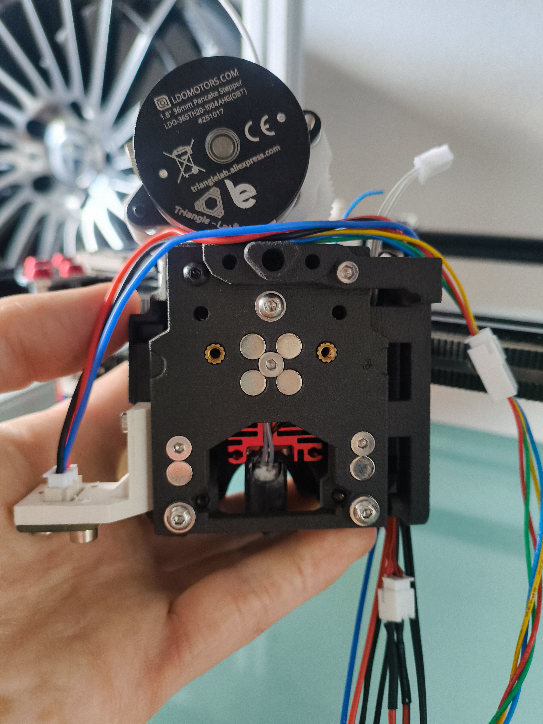
documents/graphics/IMG_20260614_153150263.jpg
