Sprudlwassr/FlexPrint/documents/graphics/IMG_20260614_153200073.jpg

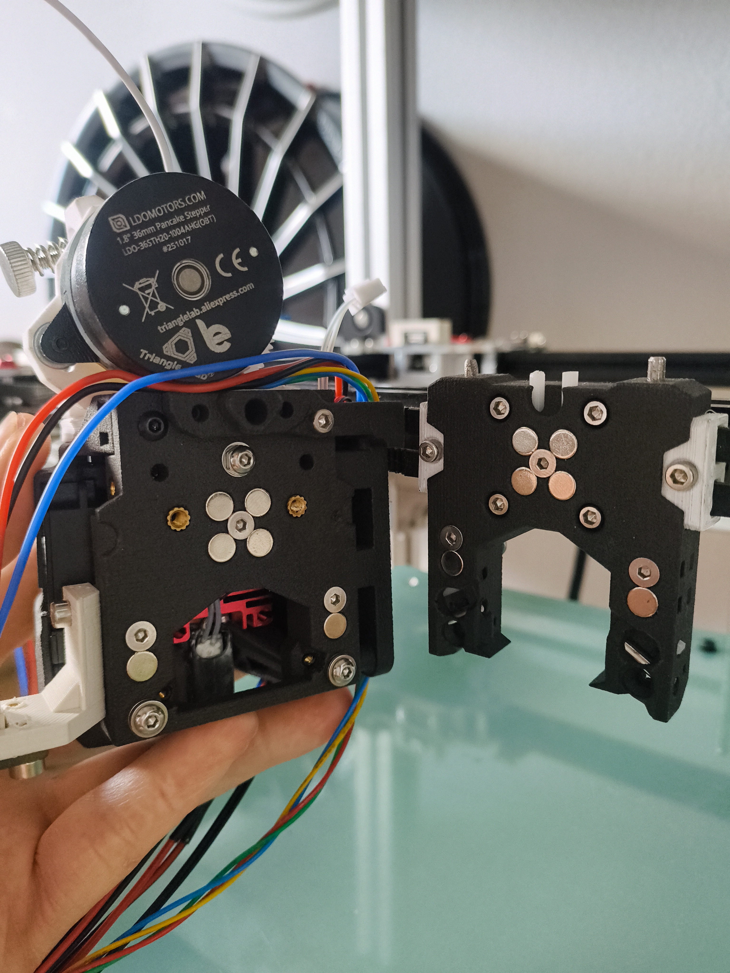
documents/graphics/IMG_20260614_153200073.jpg
