Sprudlwassr/FlexPrint/documents/graphics/IMG_20260614_153229527.jpg

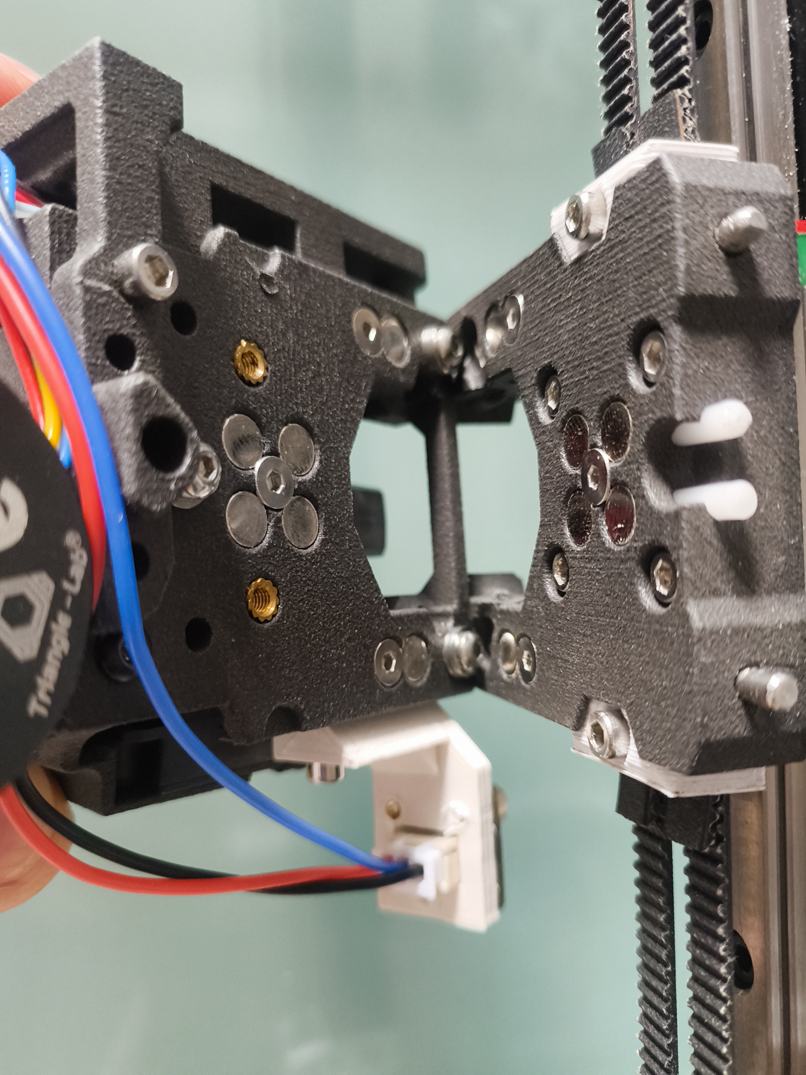
documents/graphics/IMG_20260614_153229527.jpg
