Sprudlwassr/FlexPrint/documents/graphics/IMG_20260614_155911431.jpg

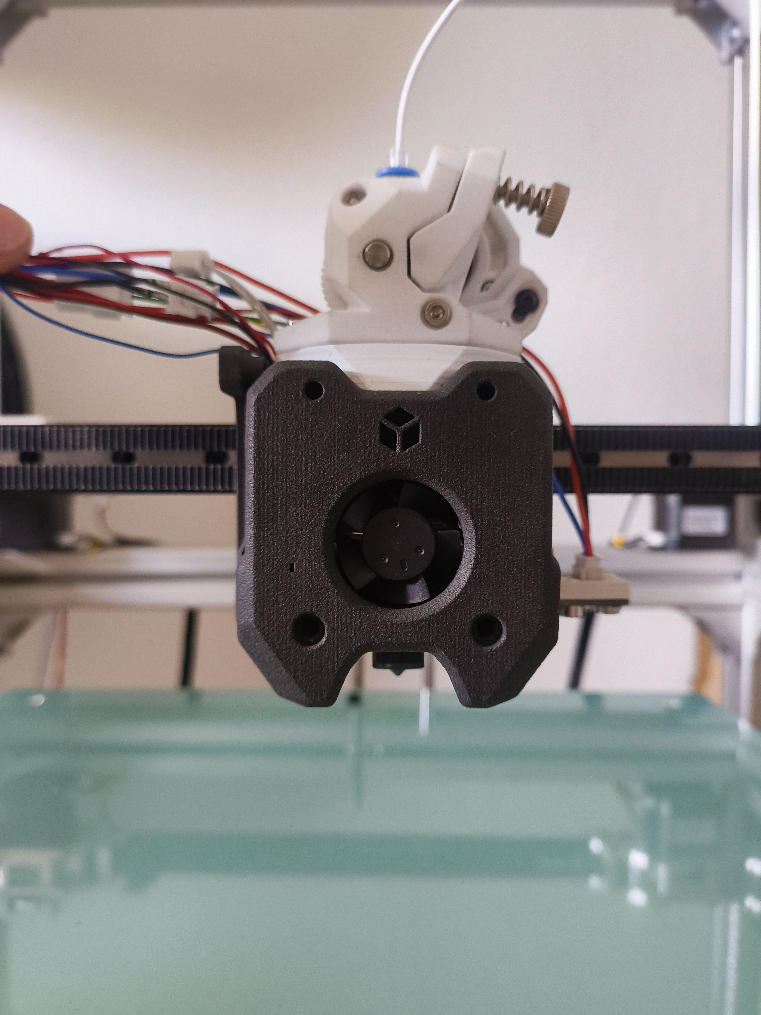
documents/graphics/IMG_20260614_155911431.jpg
