Sprudlwassr/FlexPrint/documents/graphics/IMG_20260625_200511775.jpg

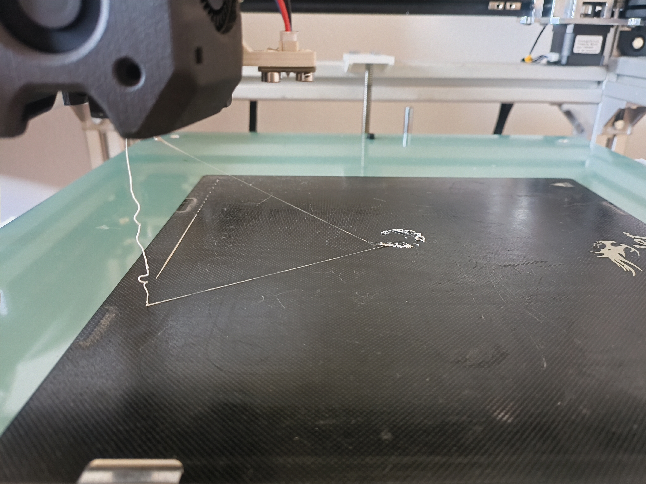
documents/graphics/IMG_20260625_200511775.jpg
