Sprudlwassr/FlexPrint/documents/graphics/IMG_20260625_200519808.jpg

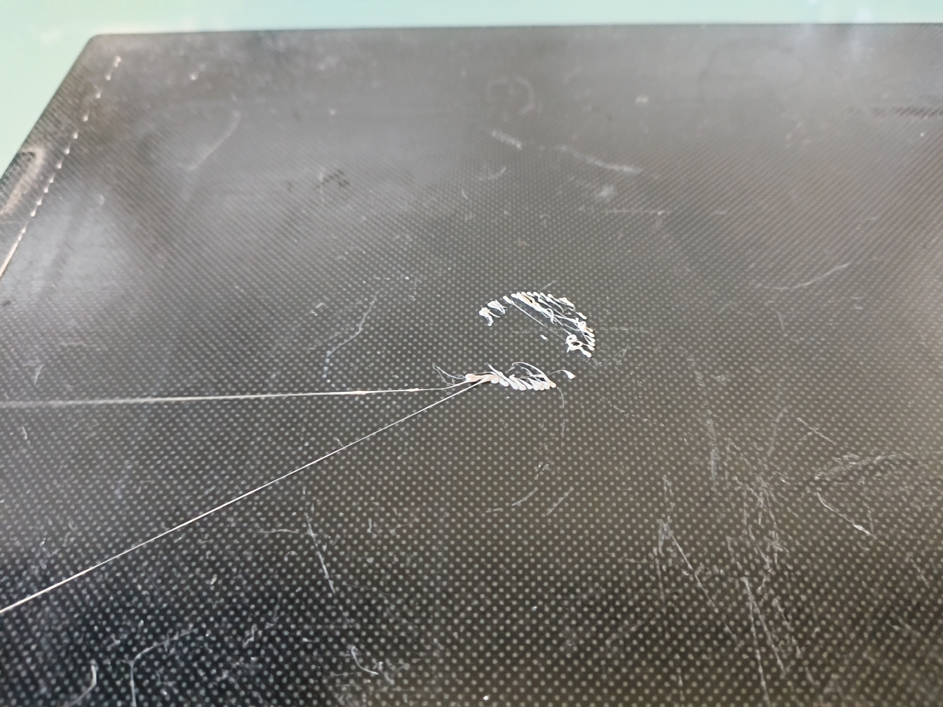
documents/graphics/IMG_20260625_200519808.jpg
