Sprudlwassr/FlexPrint/documents/graphics/IMG_20260625_211125870.jpg

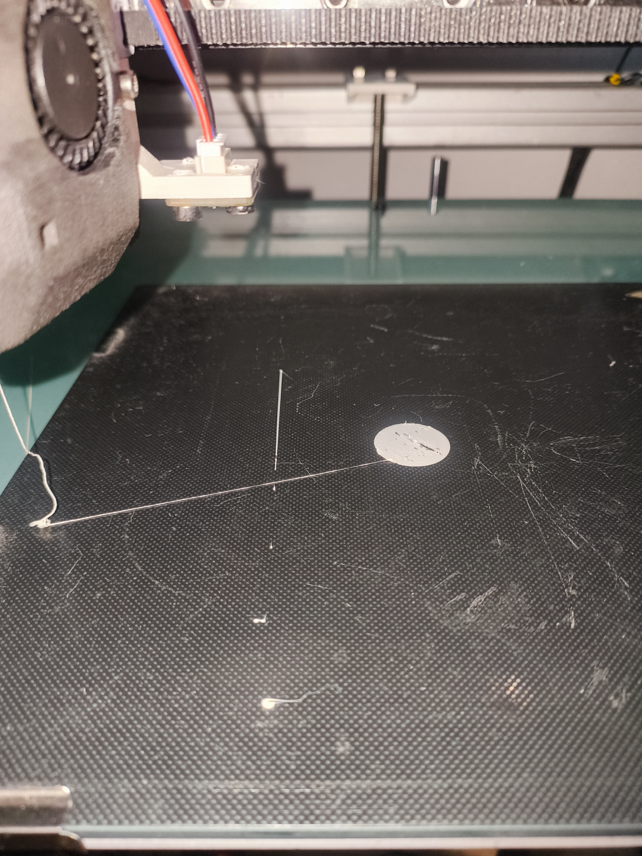
documents/graphics/IMG_20260625_211125870.jpg
