Sprudlwassr/FlexPrint/documents/graphics/IMG_20260625_211136028.jpg

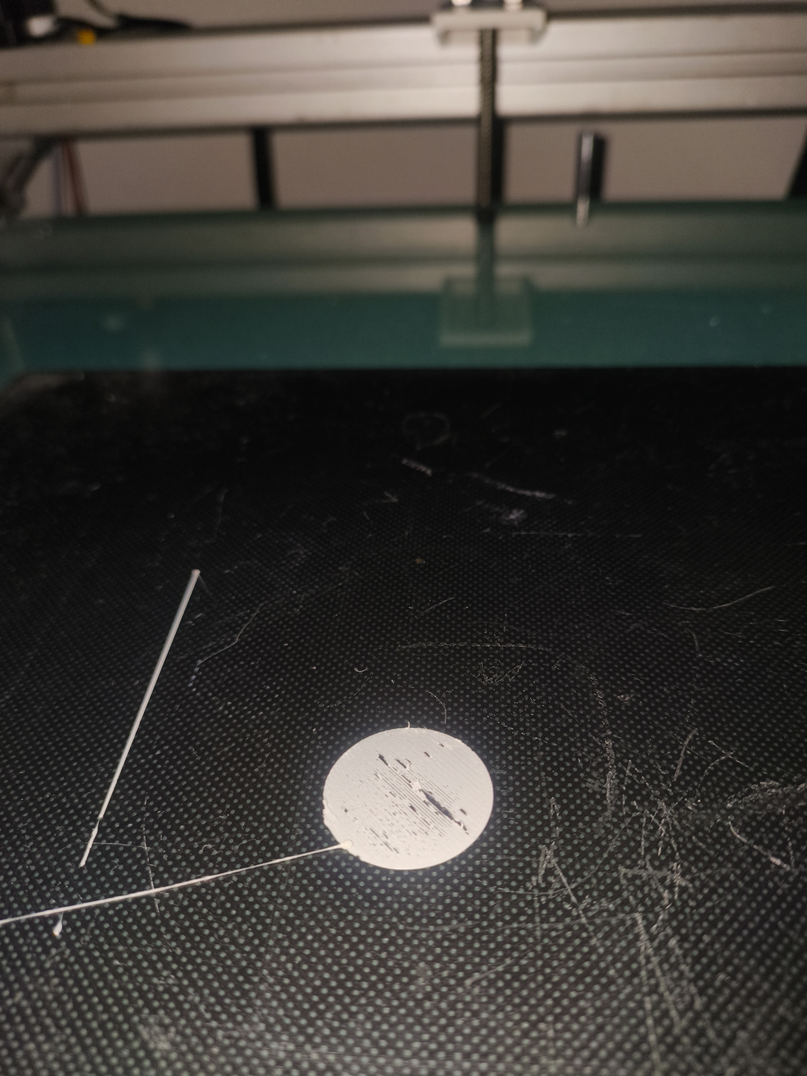
documents/graphics/IMG_20260625_211136028.jpg
