Sprudlwassr/FlexPrint/documents/graphics/IMG_20260625_211608987.jpg

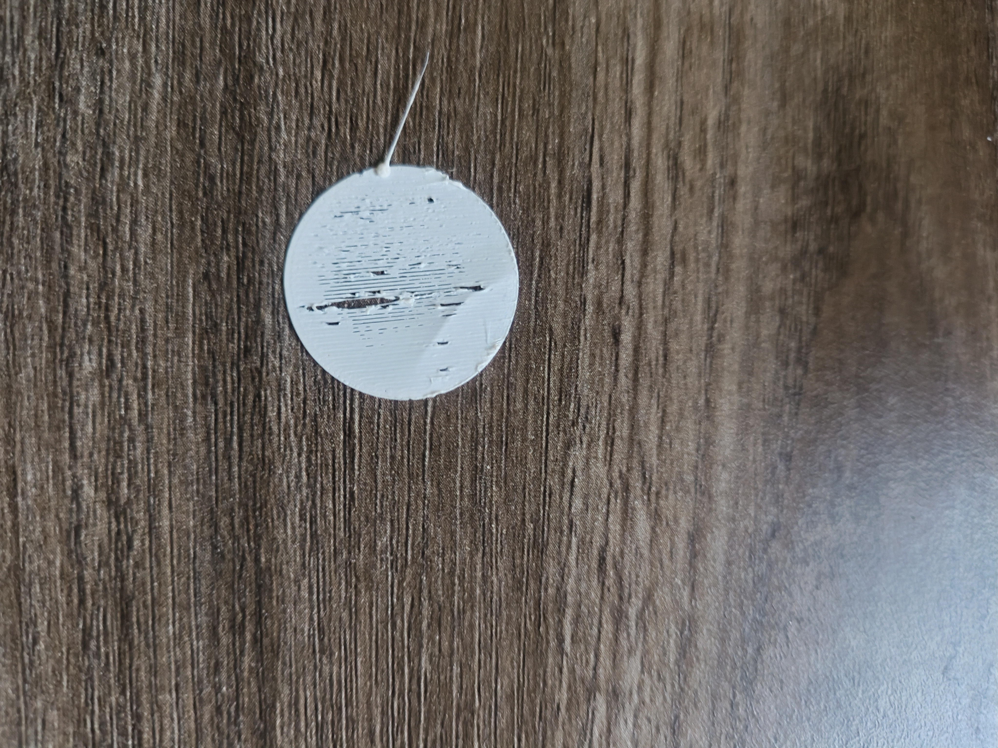
documents/graphics/IMG_20260625_211608987.jpg
