Sprudlwassr/FlexPrint/documents/graphics/IMG_20260625_224914504.jpg

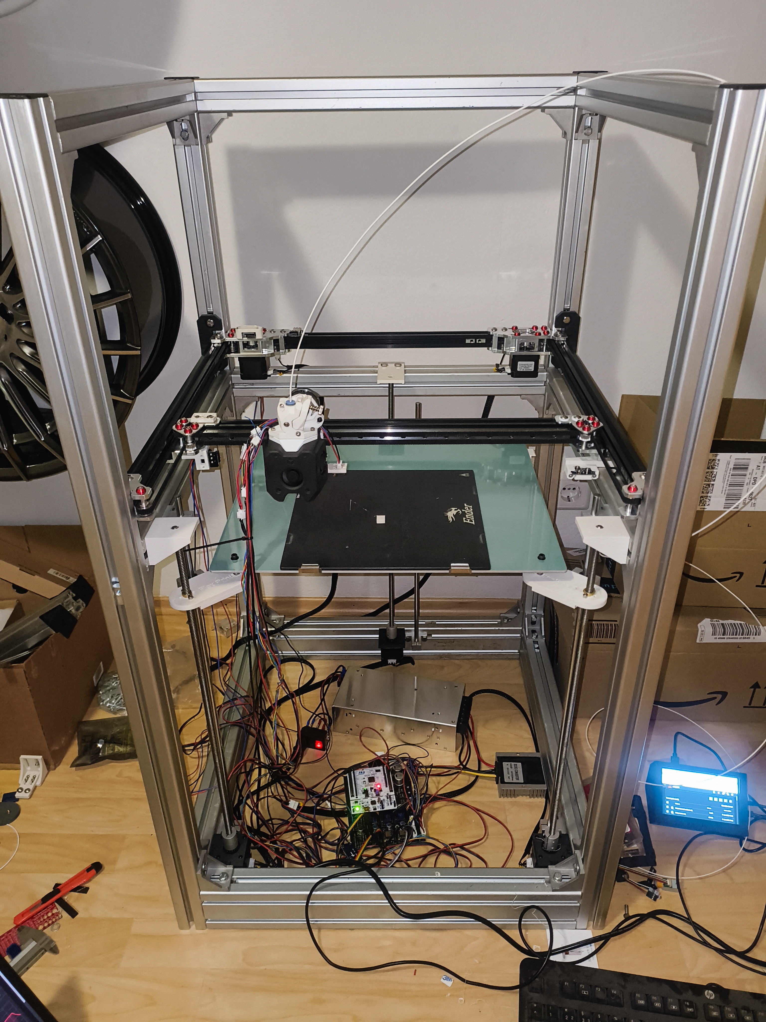
documents/graphics/IMG_20260625_224914504.jpg
