Sprudlwassr/FlexPrint/documents/graphics/IMG_20260625_224919464.jpg

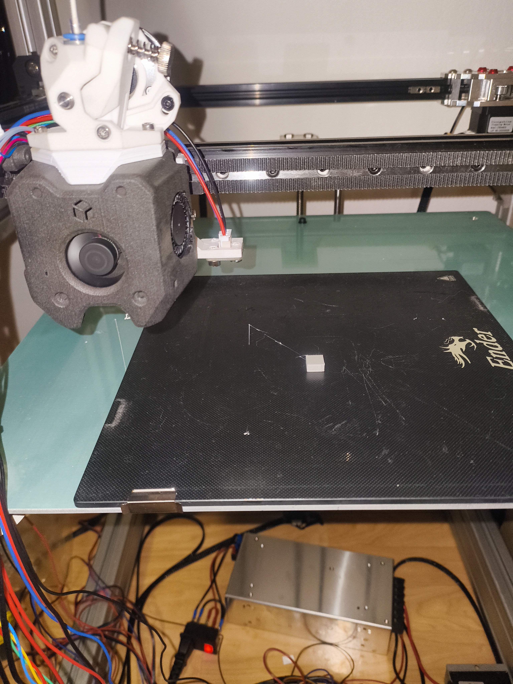
documents/graphics/IMG_20260625_224919464.jpg
