Sprudlwassr/FlexPrint/documents/graphics/IMG_20260625_225244637.jpg

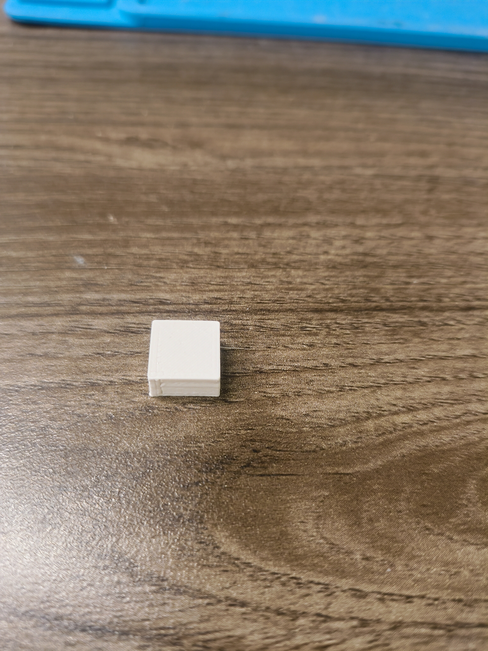
documents/graphics/IMG_20260625_225244637.jpg
