Sprudlwassr/FlexPrint/documents/graphics/IMG_20260625_225251913.jpg

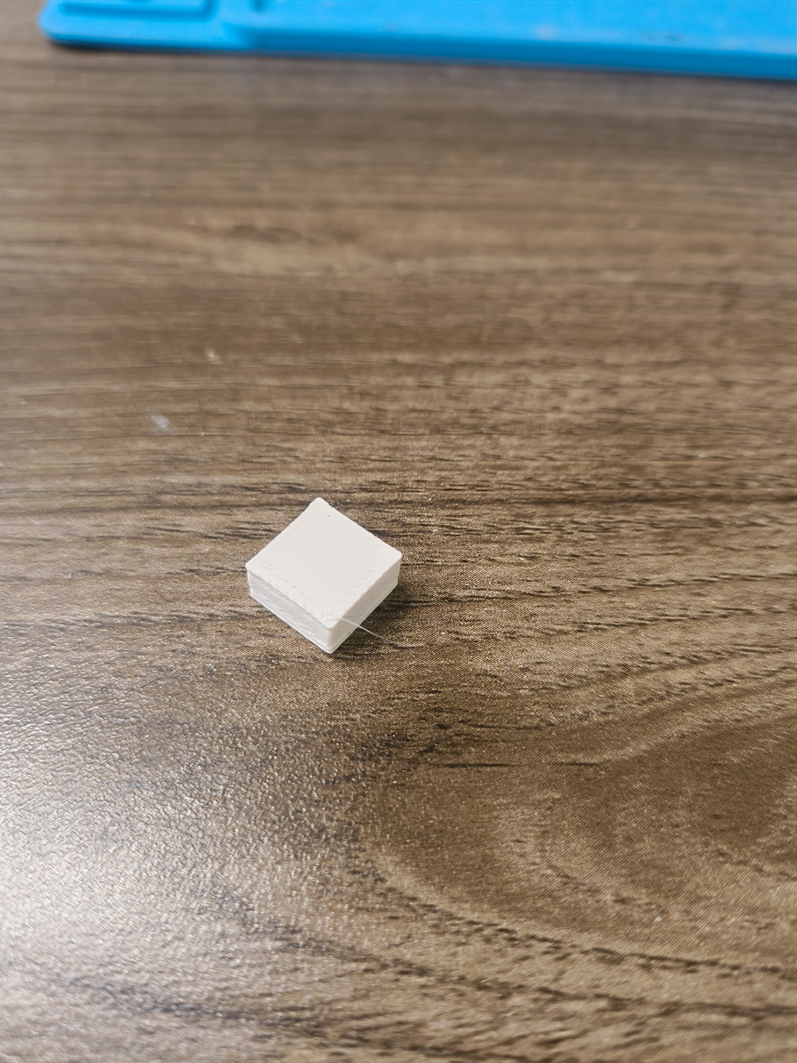
documents/graphics/IMG_20260625_225251913.jpg
