Sprudlwassr/FlexPrint/documents/graphics/IMG_20260625_225320095.jpg

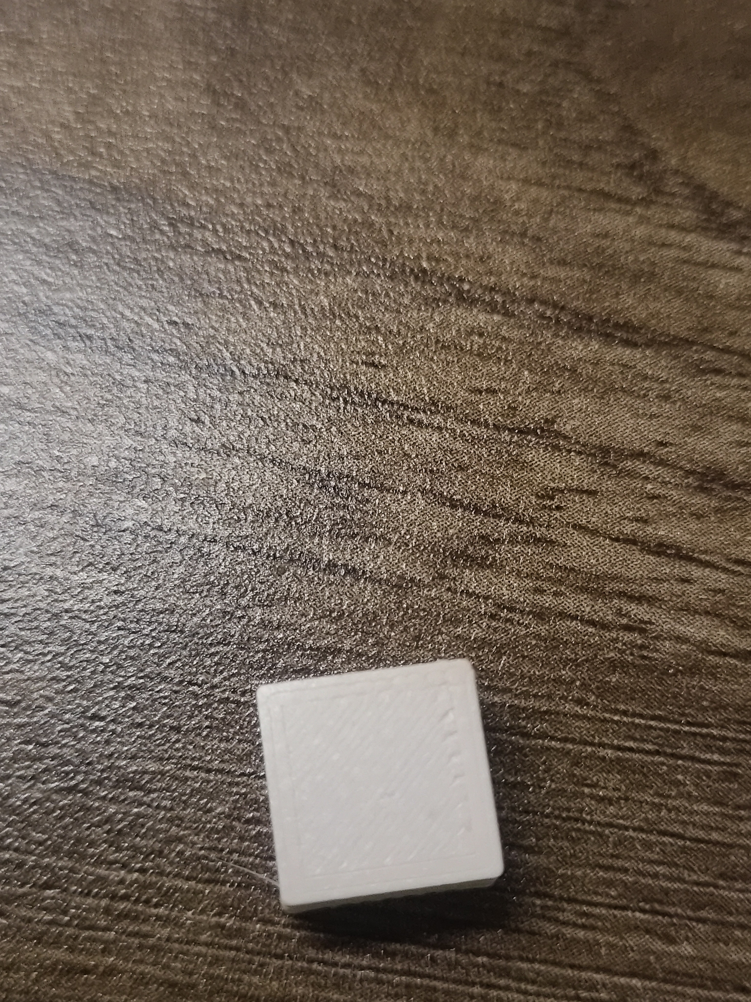
documents/graphics/IMG_20260625_225320095.jpg
