Sprudlwassr/FlexPrint/documents/graphics/IMG_20260625_225336780.jpg

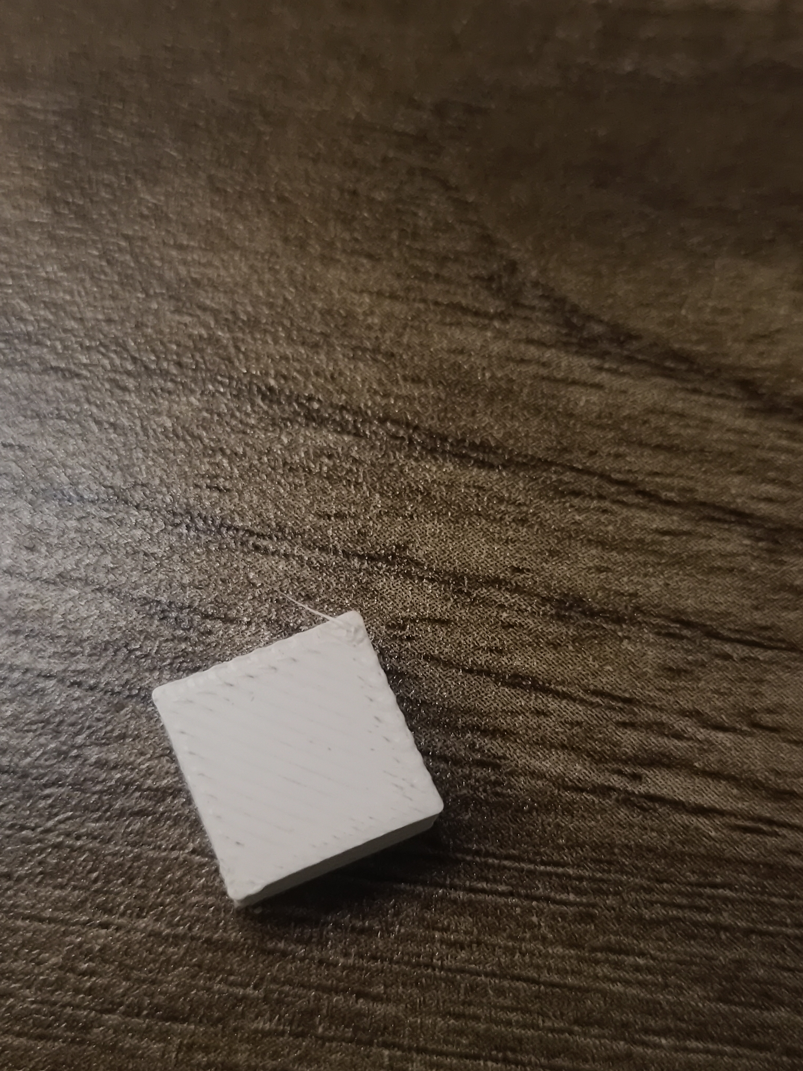
documents/graphics/IMG_20260625_225336780.jpg
