Sprudlwassr/FlexPrint/documents/graphics/IMG_20260625_225348356.jpg

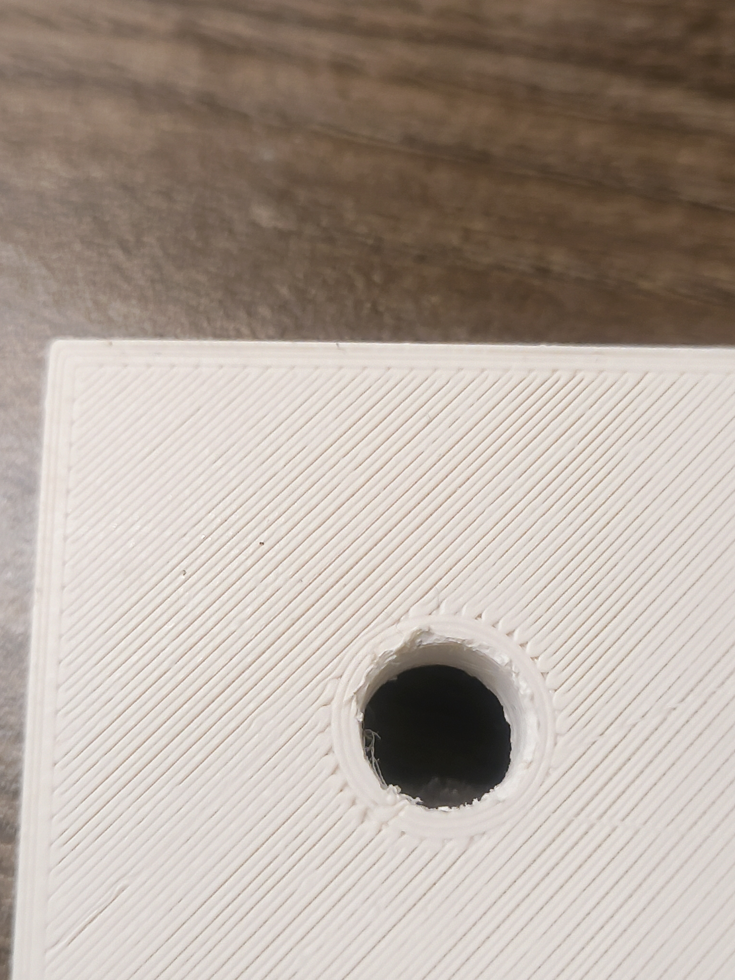
documents/graphics/IMG_20260625_225348356.jpg
