Sprudlwassr/FlexPrint/documents/graphics/IMG_20260625_225423670.jpg

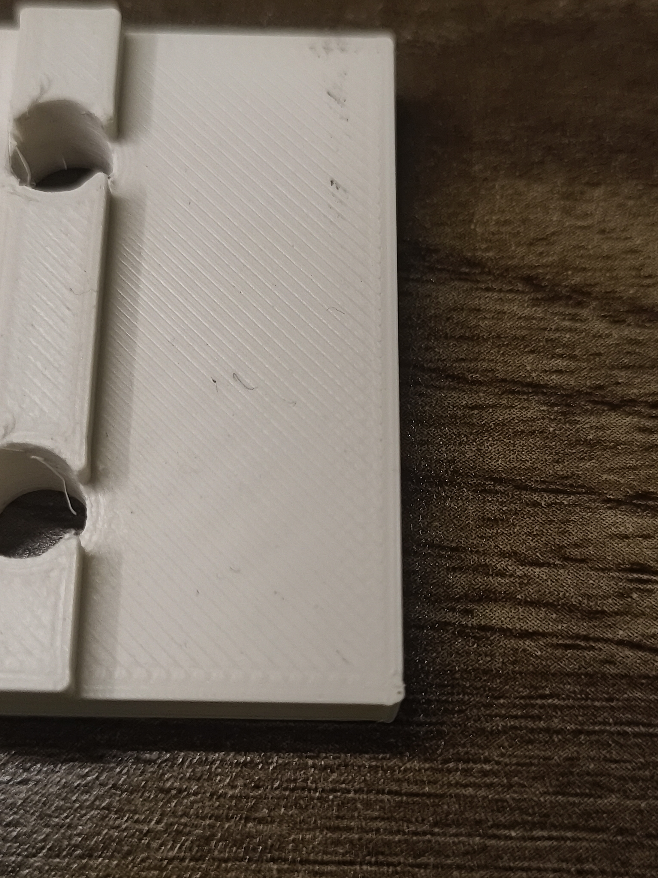
documents/graphics/IMG_20260625_225423670.jpg
