Sprudlwassr/FlexPrint/documents/graphics/IMG_20260625_225550339.jpg

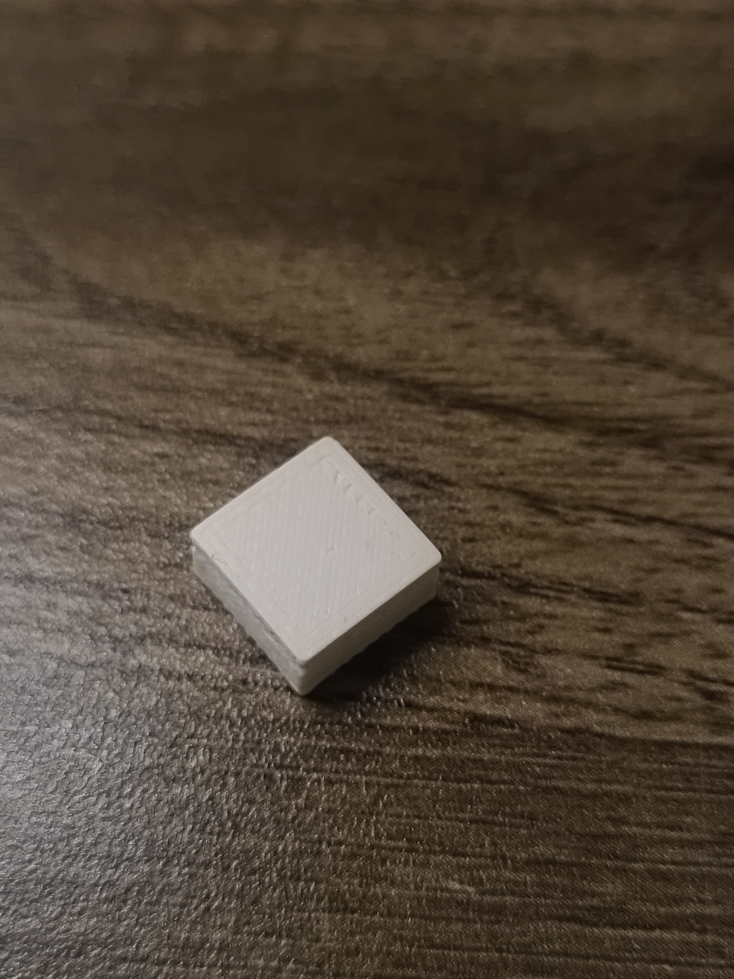
documents/graphics/IMG_20260625_225550339.jpg
