Sprudlwassr/FlexPrint/documents/graphics/IMG_20260625_225917819.jpg

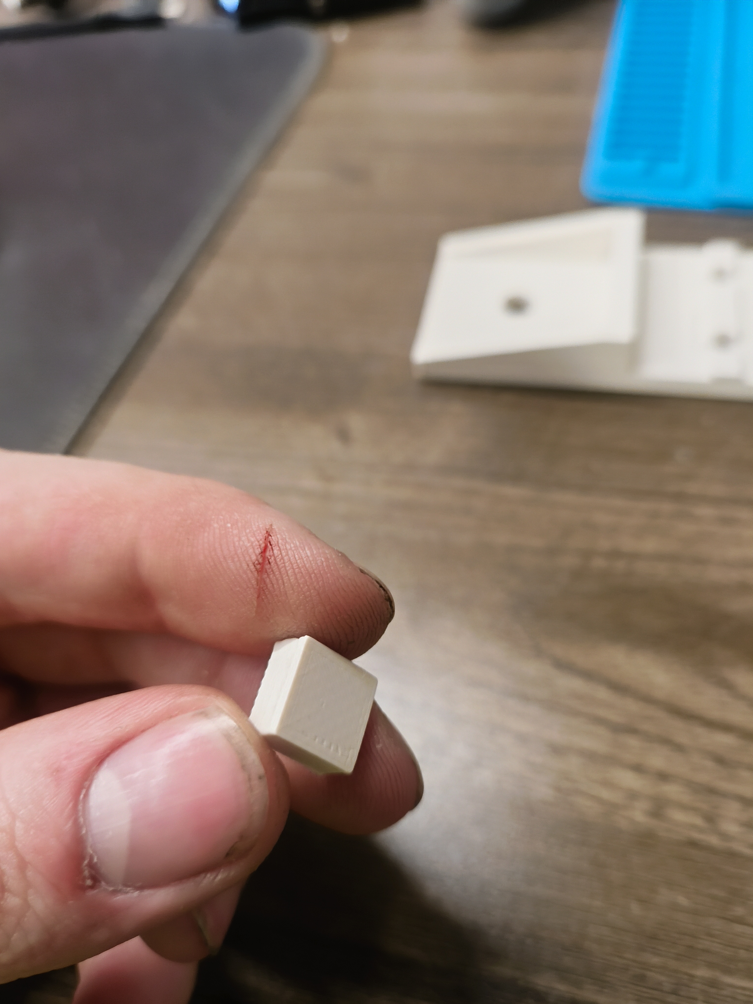
documents/graphics/IMG_20260625_225917819.jpg
