Sprudlwassr/FlexPrint/documents/graphics/IMG_20260626_141014038.jpg

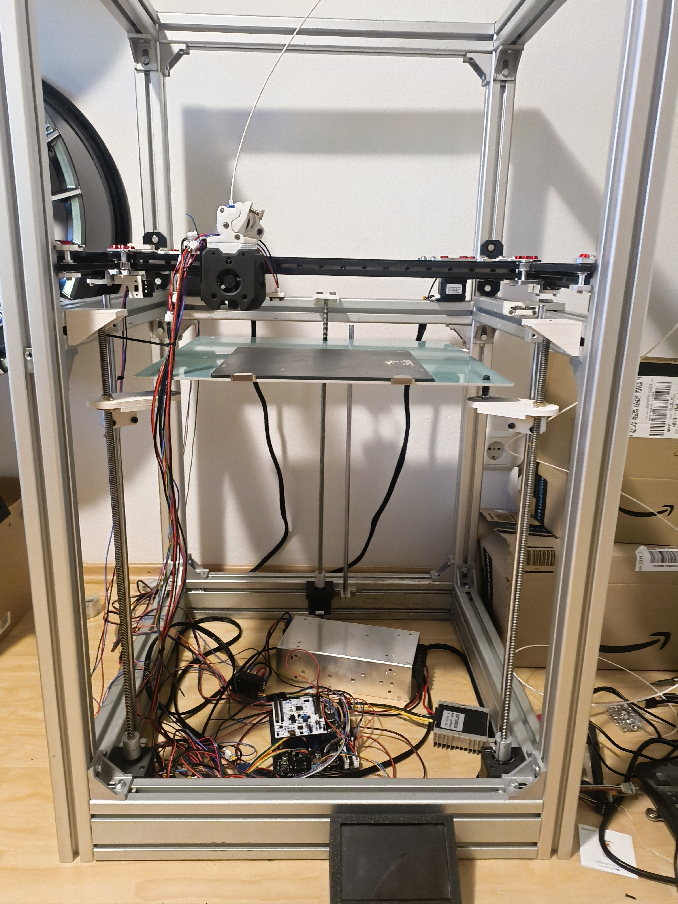
documents/graphics/IMG_20260626_141014038.jpg
