Sprudlwassr/FlexPrint/documents/graphics/IMG_20260626_141024621.jpg

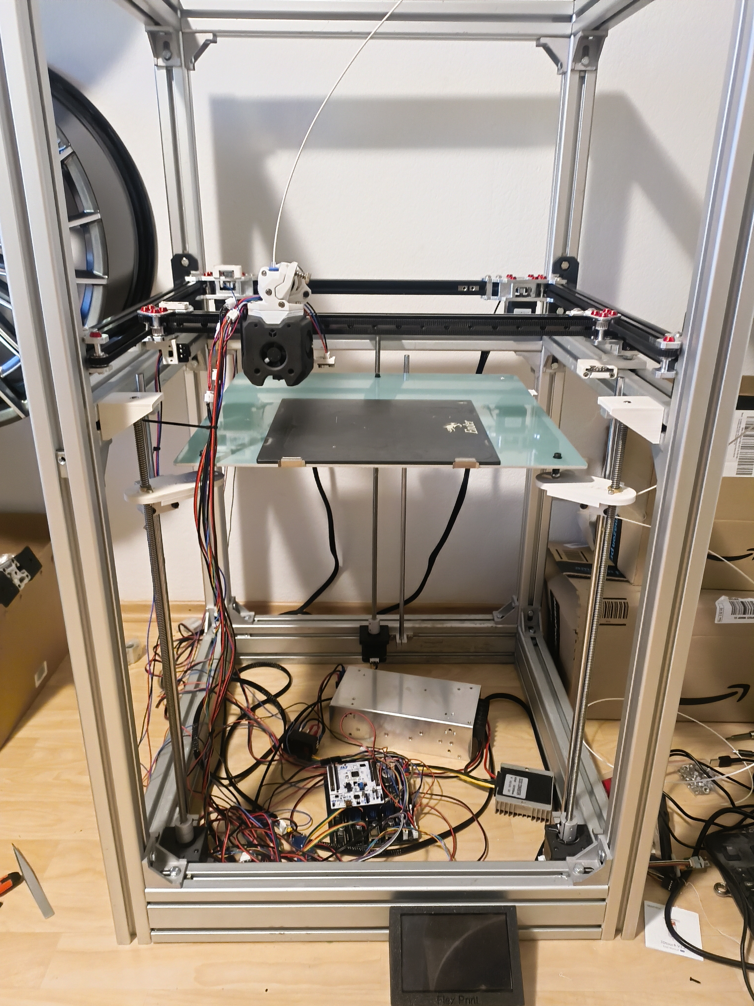
documents/graphics/IMG_20260626_141024621.jpg
