Sprudlwassr/FlexPrint/documents/graphics/IMG_20261011_190035122.jpg

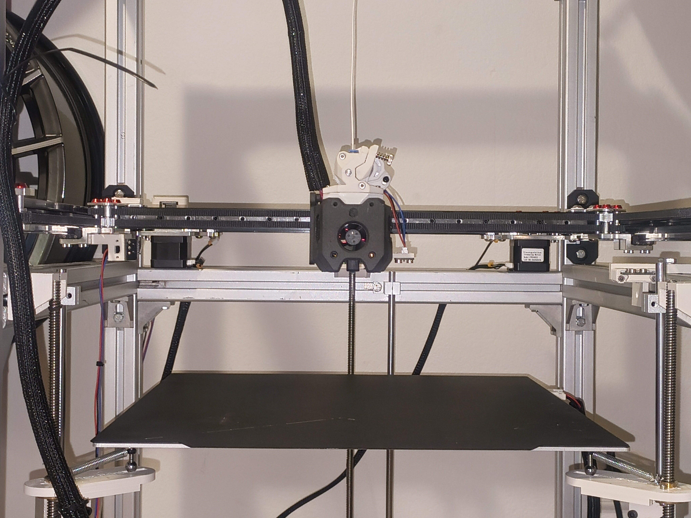
documents/graphics/IMG_20261011_190035122.jpg
