Sprudlwassr/FlexPrint/documents/graphics/IMG_20261012_215731451.jpg

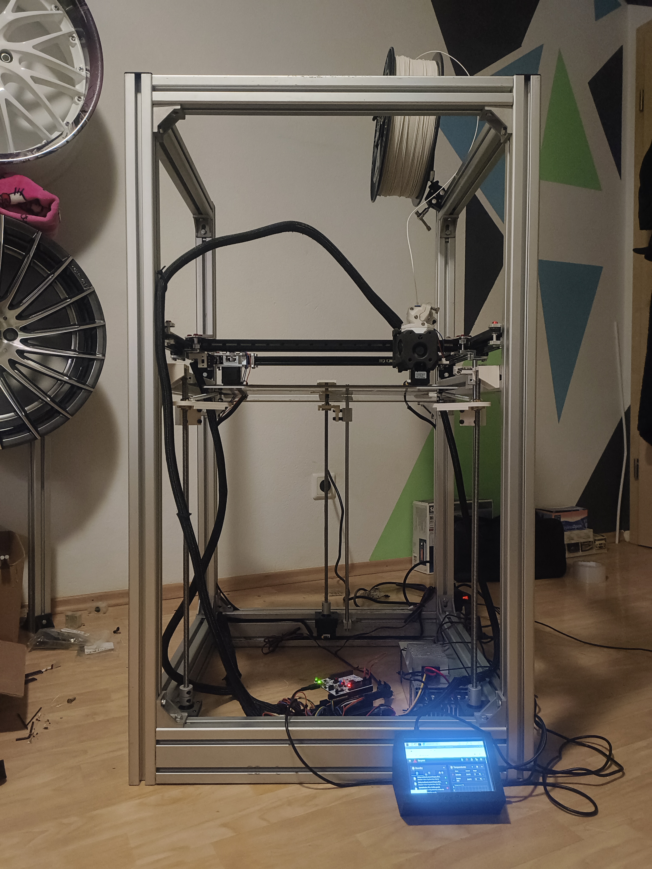
documents/graphics/IMG_20261012_215731451.jpg
