Sprudlwassr/FlexPrint/documents/graphics/Mainboard.png

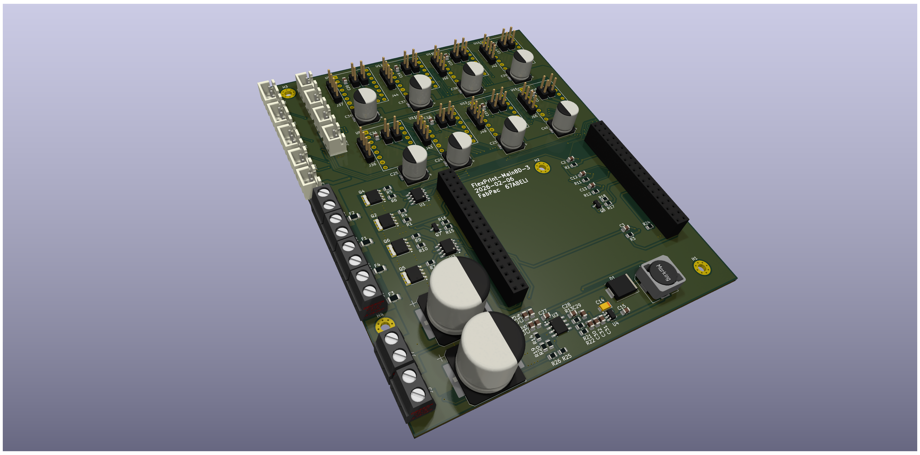
documents/graphics/Mainboard.png
