Sprudlwassr/FlexPrint/documents/graphics/TMC2209_driver.png

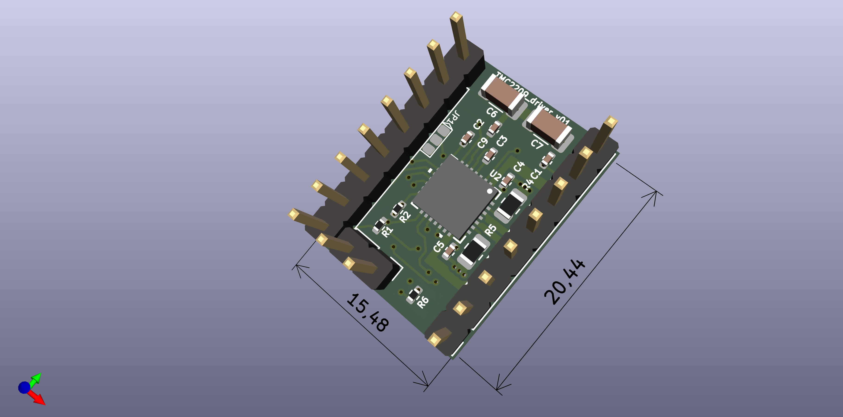
documents/graphics/TMC2209_driver.png
