Sprudlwassr/FlexPrint/documents/graphics/Toolhead_Seite.png

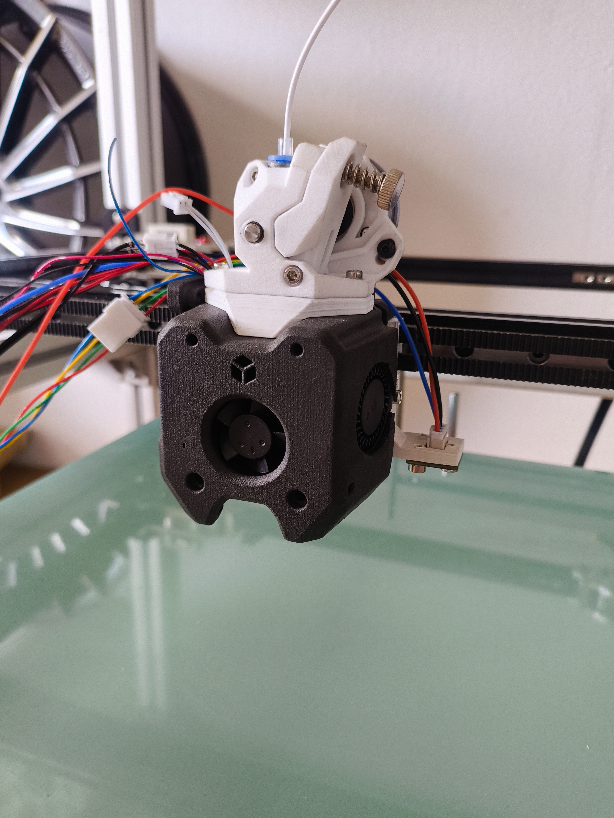
documents/graphics/Toolhead_Seite.png
