Sprudlwassr/FlexPrint/software/03_Dokumentation/Fotos/WhatsApp Image 2026-02-28 at 14.15.20 (2).jpeg

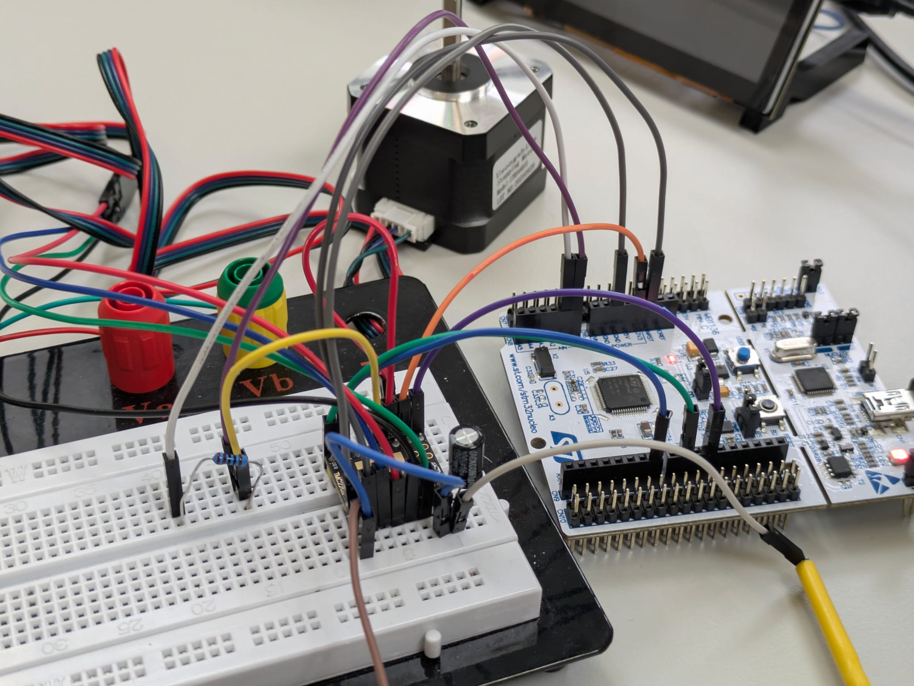
software/03_Dokumentation/Fotos/WhatsApp Image 2026-02-28 at 14.15.20 (2).jpeg
