Sprudlwassr/FlexPrint/software/03_Dokumentation/Fotos/WhatsApp Image 2026-02-28 at 14.15.20 (3).jpeg

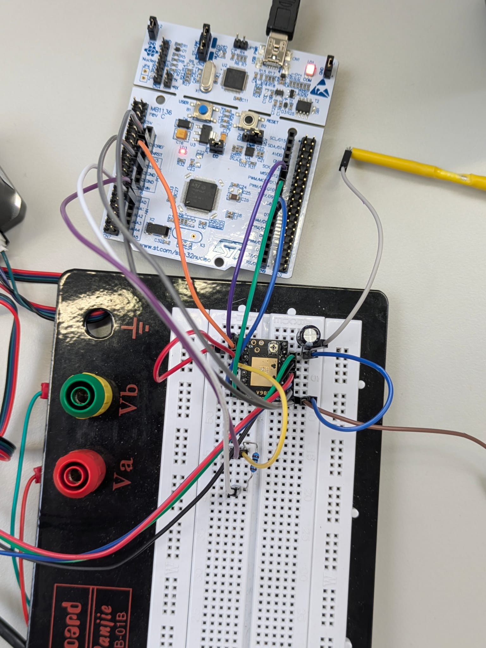
software/03_Dokumentation/Fotos/WhatsApp Image 2026-02-28 at 14.15.20 (3).jpeg
