Sprudlwassr/FlexPrint/software/03_Dokumentation/Fotos/WhatsApp Image 2026-02-28 at 14.15.21.jpeg

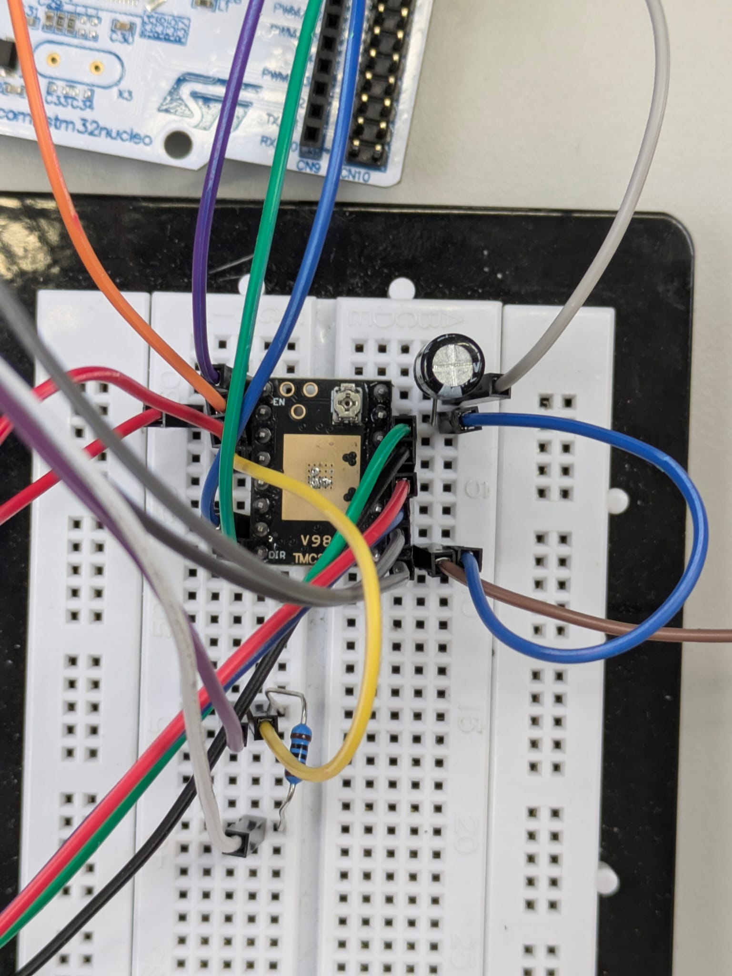
software/03_Dokumentation/Fotos/WhatsApp Image 2026-02-28 at 14.15.21.jpeg
