Sprudlwassr/FlexPrint/hardware/Mainboard/production/bom.csv

Designator | Footprint | Quantity | Value | LCSC Part #
C1, C11 | CP_Elec_16x17.5 | 2 | 470µ
C10, C16, C17, C18, C19, C20, C21, C22 | 0805 | 8 | 100n
C12, C13, C2, C3 | 0805 | 4 | 10u
C14 | CP_EIA-3216-10_Kemet-I | 1 | 2.2uF (tantal)
C15 | 0805 | 1 | 470pF
C23, C24, C25, C36, C37, C38, C39, C40 | CP_Elec_8x10 | 8 | 100µ
C26, C33, C34, C35 | 0805 | 4 | 2.2uF
C27 | 0805 | 1 | 0.1uF
C28 | 0805 | 1 | 4.7pF
C29 | 0805 | 1 | 4.7nF
C30, C31, C32 | 0805 | 3 | 47uF
CN1 | PinSocket_2x19_P2.54mm_Vertical | 1 | NUCLE_F446RE_MORPHO_CN7
CN2 | PinSocket_2x19_P2.54mm_Vertical | 1 | NUCLE_F446RE_MORPHO_CN10
D1 | D_SMC | 1 | B560C
F1, F2 | 1206 | 2 | 3A
F3 | 1206 | 1 | 15A
F4 | 1206 | 1 | Fuse
J1 | JST_XH_B3B-XH-A_1x03_P2.50mm_Vertical | 1 | X_END
J10 | TerminalBlock_bornier-2_P5.08mm | 1 | Power
J12 | JST_XH_B2B-XH-A_1x02_P2.50mm_Vertical | 1 | Part_Cooling2
J13 | JST_XH_B2B-XH-A_1x02_P2.50mm_Vertical | 1 | Part_Cooling1
J2 | JST_XH_B3B-XH-A_1x03_P2.50mm_Vertical | 1 | Y_END
J27 | JST_XH_B3B-XH-A_1x03_P2.50mm_Vertical | 1 | Z_END
J28 | PinHeader_1x02_P2.54mm_Vertical | 1 | X_MS2
J29 | JST_XH_B2B-XH-A_1x02_P2.50mm_Vertical | 1 | HE1_therm
J3 | TerminalBlock_bornier-2_P5.08mm | 1 | +12V
J30 | JST_XH_B2B-XH-A_1x02_P2.50mm_Vertical | 1 | Bed_therm
J31 | PinHeader_1x02_P2.54mm_Vertical | 1 | Z1_MS2
J32 | PinHeader_1x02_P2.54mm_Vertical | 1 | X_MS1
J33 | PinHeader_1x02_P2.54mm_Vertical | 1 | Z1_MS1
J34 | PinHeader_1x02_P2.54mm_Vertical | 1 | Z4_MS2
J35 | PinHeader_1x02_P2.54mm_Vertical | 1 | Z4_MS1
J36 | PinHeader_1x04_P2.54mm_Vertical | 1 | X_Motor
J37 | PinHeader_1x04_P2.54mm_Vertical | 1 | Z1_Motor
J38 | PinHeader_1x02_P2.54mm_Vertical | 1 | Y_MS2
J39 | PinHeader_1x02_P2.54mm_Vertical | 1 | Z2_MS2
J40 | PinHeader_1x02_P2.54mm_Vertical | 1 | Y_MS1
J41 | PinHeader_1x02_P2.54mm_Vertical | 1 | Z2_MS1
J42 | PinHeader_1x04_P2.54mm_Vertical | 1 | Z4_Motor
J43 | PinHeader_1x04_P2.54mm_Vertical | 1 | Y_Motor
J44 | PinHeader_1x04_P2.54mm_Vertical | 1 | Z2_Motor
J45 | PinHeader_1x02_P2.54mm_Vertical | 1 | E_MS2
J46 | PinHeader_1x02_P2.54mm_Vertical | 1 | Z3_MS2
J47 | PinHeader_1x02_P2.54mm_Vertical | 1 | E_MS1
J48 | PinHeader_1x02_P2.54mm_Vertical | 1 | Z3_MS1
J49 | PinHeader_1x04_P2.54mm_Vertical | 1 | E_Motor
J50 | PinHeader_1x04_P2.54mm_Vertical | 1 | Z3_Motor
J51 | JST_XH_B2B-XH-A_1x02_P2.50mm_Vertical | 1 | PWR_therm
J52 | JST_XH_B2B-XH-A_1x02_P2.50mm_Vertical | 1 | HE2_therm
J53 | PinHeader_1x02_P2.54mm_Vertical | 1 | R_MS2
J54 | PinHeader_1x02_P2.54mm_Vertical | 1 | R_MS1
J55 | PinHeader_1x04_P2.54mm_Vertical | 1 | R_Motor
J6 | TerminalBlock_bornier-2_P5.08mm | 1 | Hotend1
J7 | TerminalBlock_bornier-2_P5.08mm | 1 | +24V
J8 | TerminalBlock_bornier-2_P5.08mm | 1 | Hotend2
J9 | TerminalBlock_bornier-2_P5.08mm | 1 | Bed
L1 | L_Wuerth_WE-PDF | 1 | 7.2uH
Q2, Q4, Q5, Q6 | LFPAK56 | 4 | PSMN5R2-60YL
Q7, Q8 | SOT-23 | 2 | AO3400A
R1, R10, R16, R18, R6, R8 | 0805 | 6 | 100k
R11, R12, R2, R3 | 0805 | 4 | 4k7
R13 | 0805 | 1 | 16.9k
R14 | 0805 | 1 | 442k
R15, R17 | 0805 | 2 | 100R
R19 | 0805 | 1 | 90.9k
R20 | 0805 | 1 | 243k
R21 | 0805 | 1 | 53.6k
R22 | 0805 | 1 | 10.2k
R23, R24 | 0805 | 2 | 1k
R4, R5, R7, R9 | 0805 | 4 | 50R
U1, U2 | SOIC-8_3.9x4.9mm_P1.27mm | 2 | MIC4426
U10 | MODULE_TMC2209_SILENTSTEPSTICK | 1 | Z4
U11 | MODULE_TMC2209_SILENTSTEPSTICK | 1 | Y
U12 | MODULE_TMC2209_SILENTSTEPSTICK | 1 | Z2
U13 | MODULE_TMC2209_SILENTSTEPSTICK | 1 | E
U14 | MODULE_TMC2209_SILENTSTEPSTICK | 1 | Z3
U15 | MODULE_TMC2209_SILENTSTEPSTICK | 1 | R
U3 | Texas_R-PDSO-G8_EP2.95x4.9mm_Mask2.4x3.1mm_ThermalVias | 1 | TPS54560BDDA
U4 | SOT-23-5 | 1 | MIC5219-3.3YM5
U8 | MODULE_TMC2209_SILENTSTEPSTICK | 1 | X
U9 | MODULE_TMC2209_SILENTSTEPSTICK | 1 | Z1
