Sprudlwassr/FlexPrint/hardware/TMC2209_driver/TMC2209_driver/Mainboard_Bom.xlsx

Pos | Sourced | References | Value | Footprint | Stk | Stk Gesamt | Preis pro stk | Preis ab 10stk | Gesamtpreise | Anzahl Boards
1 | https://www.reichelt.at/at/de/shop/produkt/vielschicht-kerko_100nf_50v_125_c-207073 | C10, C16, C17, C18, C19, C20, C21, C22, C27 | 100n | C_0805_2012Metric | 9 | 9 | 0.02 | 0.02 | 0.18 | 1
2 | https://www.reichelt.at/at/de/shop/produkt/elko_smd_100_f_50_v_105_c_low_imp_8_x_10_mm-275883 | C23, C24, C25, C36, C37, C38, C39, C40 | 100µ | CP_Elec_8x10 | 8 | 8 | 0.3 | 0.3 | 2.4
3 | https://www.reichelt.at/at/de/shop/produkt/mlcc_0805_10_f_16_v_-10_x6s-409193 | C2, C3, C12, C13 | 10u | C_0805_2012Metric | 4 | 4 | 0.03 | 0.03 | 0.12
4 | https://www.reichelt.at/at/de/shop/produkt/mlcc_0805_2_2_f_25_v_-10_x7r-409169 | C26, C33, C34, C35 | 2.2uF | C_0805_2012Metric | 4 | 4 | 0.03 | 0.03 | 0.12
5 | https://www.reichelt.at/at/de/shop/produkt/mlcc_0805_47_f_6_3_v_-20_x5r-409188 | C30, C31, C32 | 47uF | C_0805_2012Metric | 3 | 3 | 0.1 | 0.1 | 0.3
6 | https://www.reichelt.at/at/de/shop/produkt/elko_smd_470_f_63v_5000h_low_esr-174999 | C1, C11 | 470µ | CP_Elec_16x17.5 | 2 | 2 | 2.01 | 2.01 | 4.02
7 | https://www.reichelt.at/at/de/shop/produkt/smd-tantal_2_2_f_16v_125_c-206498 | C14 | 2.2uF (tantal) | CP_EIA-3216-10_Kemet-I | 1 | 1 | 0.38 | 0.38 | 0.38
8 | https://www.reichelt.at/at/de/shop/produkt/vielschicht-kerko_470pf_50v_125_c-393572 | C15 | 470pF | C_0805_2012Metric | 1 | 1 | 0.04 | 0.04 | 0.04
9 | https://www.reichelt.at/at/de/shop/produkt/vielschicht-kerko_4_7pf_50v_125_c-393596 | C28 | 4.7pF | C_0805_2012Metric | 1 | 1 | 0.04 | 0.04 | 0.04
10 | https://www.reichelt.at/at/de/shop/produkt/mlcc_0805_4_7_nf_50_v_-5_c0g-409187 | C29 | 4.7nF | C_0805_2012Metric | 1 | 1 | 0.03 | 0.03 | 0.03
11 | https://www.reichelt.at/at/de/shop/produkt/smd-widerstand_0805_100_kohm_125_mw_1_-32910 | R1, R6, R8, R10, R16, R18 | 100k | R_0805_2012Metric | 6 | 6 | 0.03 | 0.03 | 0.18
12 | https://www.reichelt.at/at/de/shop/produkt/smd-widerstand_0805_4_7_kohm_125_mw_1_-32894 | R2, R3, R11, R12 | 4k7 | R_0805_2012Metric | 4 | 4 | 0.03 | 0.03 | 0.12
13 | https://www.reichelt.at/at/de/shop/produkt/smd-widerstand_0805_49_9_ohm_125_mw_0_1_-123203 | R4, R5, R7, R9 | 50R | R_0805_2012Metric | 4 | 4 | 0.38 | 0.38 | 1.52
14 | https://www.reichelt.at/at/de/shop/produkt/smd-widerstand_0805_100_ohm_125_mw_1_-32874 | R15, R17 | 100R | R_0805_2012Metric | 2 | 2 | 0.03 | 0.03 | 0.06
15 | https://www.reichelt.at/at/de/shop/produkt/smd-widerstand_0805_1_0_kohm_125_mw_1_-32886 | R23, R24 | 1k | R_0805_2012Metric | 2 | 2 | 0.03 | 0.03 | 0.06
16 | https://www.reichelt.at/at/de/shop/produkt/smd-widerstand_0805_16_9_kohm_125_mw_0_1_-123317 | R13 | 16.9k | R_0805_2012Metric | 1 | 1 | 0.38 | 0.38 | 0.38
17 | https://www.mouser.at/ProductDetail/YAGEO/RC0805FR-07442KL | R14 | 442k | R_0805_2012Metric | 1 | 1 | 0.09 | 0.09 | 0.09
18 | https://www.mouser.at/ProductDetail/SEI-Stackpole/RMCF0805FT90K9 | R19 | 90.9k | R_0805_2012Metric | 1 | 1 | 0.09 | 0.09 | 0.09
19 | https://www.mouser.at/ProductDetail/YAGEO/RC0805FR-07442KL | R20 | 243k | R_0805_2012Metric | 1 | 1 | 0.09 | 0.09 | 0.09
20 | https://www.mouser.at/ProductDetail/Panasonic/ERA-6AEB5362V | R21 | 53.6k | R_0805_2012Metric | 1 | 1 | 0.09 | 0.09 | 0.09
21 | https://www.mouser.at/ProductDetail/SEI-Stackpole/RMCF0805FT10K2 | R22 | 10.2k | R_0805_2012Metric | 1 | 1 | 0.09 | 0.09 | 0.09
22 | https://www.mouser.at/ProductDetail/Wurth-Elektronik/7447798720?qs=E%2F%2FhvbtCqpOcNhO9pFvFww%3D%3D | L1 | 7.2uH | L_Wuerth_WE-PDF | 1 | 1 | 3.06 | 3.06 | 3.06
23 | https://www.mouser.at/ProductDetail/Diodes-Incorporated/B560C?qs=e5T%2FzGlhGObuwwV6I9BY7Q%3D%3D | D1 | B560C | D_SMC | 1 | 1 | 0.44 | 0.44 | 0.44
24 | https://www.mouser.at/ProductDetail/Microchip-Technology/MIC4426ZM?qs=kh6iOki%2FeLEtxNW3ipWFFg%3D%3D | U1, U2 | MIC4426 | SOIC-8_3.9x4.9mm_P1.27mm | 2 | 2 | 1.13 | 1.13 | 2.26
25 | https://www.mouser.at/ProductDetail/Texas-Instruments/TPS54560BDDA?qs=gZXFycFWdAMqSdZZ7nACGQ%3D%3D | U3 | TPS54560BDDA | Texas_R-PDSO-G8_EP2.95x4.9mm_Mask2.4x3.1mm_ThermalVias | 1 | 1 | 5.03 | 5.03 | 5.03
26 | https://www.mouser.at/ProductDetail/Microchip-Technology/MIC5219-3.3YM5-TR?qs=U6T8BxXiZAWojkIJMtSJlw%3D%3D | U4 | MIC5219-3.3YM5 | SOT-23-5 | 1 | 1 | 1.02 | 1.02 | 1.02
35 | https://www.mouser.at/ProductDetail/Bel-Fuse/0685P3000-01?qs=vLWxofP3U2zFsQz51kvowA%3D%3D | F1, F2 | 3A | Fuse_1206_3216Metric | 2 | 2 | 0.52 | 0.52 | 1.04
36 | https://www.mouser.at/ProductDetail/Bel-Fuse/0685P9150-01?qs=vLWxofP3U2wa1wOOHrjskQ%3D%3D | F3 | 15A | Fuse_1206_3216Metric | 1 | 1 | 0.47 | 0.47 | 0.47
37 |  | F4 | Fuse | Fuse_1206_3216Metric | 0 | 0 |  |  | 0
38 | https://www.mouser.at/ProductDetail/Nexperia/PSMN5R2-60YLX?qs=GIi83qBHgilaQeuaFRmccg%3D%3D | Q2, Q4, Q5, Q6 | PSMN5R2-60YL | LFPAK56 | 4 | 4 | 1.64 | 1.64 | 6.56
39 | https://www.reichelt.at/at/de/shop/produkt/mosfet_n-ch_30v_5_7a_0_018r_sot-23-166490 | Q7, Q8 | AO3400A | SOT-23 | 2 | 2 | 0.2 | 0.2 | 0.4
40 |  | CN1, CN2 | NUCLE_F446RE_MORPHO | PinSocket_2x19_P2.54mm_Vertical | 2 | 2 |  |  | 0
42 |  | J1, J2, J27 | X_END, Y_END, Z_END | JST_XH_B3B-XH-A_1x03_P2.50mm_Vertical | 3 | 3 |  |  | 0
44 |  | J3, J6, J7, J8, J9, J10 | Terminal | TerminalBlock_bornier-2_P5.08mm | 6 | 6 |  |  | 0
50 |  | J12, J13, J29, J30, J51, J52 |  | JST_XH_B2B-XH-A_1x02_P2.50mm_Vertical | 6 | 6 |  |  | 0
53 |  | J28, J31, J32, J33, J34, J35, J38, J39, J40, J41, J45, J46, J47, J48, J53, J54 |  | PinHeader_1x02_P2.54mm_Vertical | 16 | 16 |  |  | 0
61 |  | J36, J37, J42, J43, J44, J49, J50, J55 |  | PinHeader_1x04_P2.54mm_Vertical | 8 | 8 |  |  | 0
 |  |  |  |  |  |  |  |  | 30.68
