Sprudlwassr/FlexPrint/hardware/TMC2209_driver/TMC2209_driver/Bom.xlsx

Pos | Sourced | Placed | References | Value | Footprint | Stk | Stk Gesamt | Preis pro stk | Preis ab 10stk | Gesamtpreise | Anzahl Boards
1 | https://www.reichelt.at/at/de/shop/produkt/mlcc_0402_100nf_50_v_x5r_-10_-411526 | no | C3, C4, C5, C9 | 100nF | C_0402_1005Metric | 4 | 40 | €0.02 | €0.02 | €0.80 | 10
2 | https://www.reichelt.at/at/de/shop/produkt/mlcc_1206_10_f_35_v_-10_x5r-409223 | no | C6, C7 | 10µF | C_1206_3216Metric | 2 | 20 | €0.08 | €0.08 | €1.60
3 | https://www.reichelt.at/at/de/shop/produkt/mlcc_0402_4_7uf_10_v_x5r_-20_-411511 | no | C2 | 4.7µF | C_0402_1005Metric | 1 | 10 | €0.03 | €0.03 | €0.30
4 | https://www.reichelt.at/at/de/shop/produkt/mlcc_0402_22nf_50_v_x7r_-10_-411516 | no | C3 | 22n | C_0402_1005Metric | 1 | 10 | €0.02 | €0.02 | €0.20
5 | https://www.reichelt.at/at/de/shop/produkt/smd-widerstand_0402_20_kohm_100_mw_1_-250513 | no | R1, R2, R6 | 20k | R_0402_1005Metric | 3 | 30 | €0.02 | €0.02 | €0.60
6 | https://www.mouser.at/ProductDetail/Panasonic/ERJ-6BSFR12V?qs=e5m3IbTHPW9Q2mo5%252B22eBg%3D%3D | no | R4, R5 | 120m | R_0805_2012Metric | 2 | 20 | €0.24 | €0.15 | €3.10
7 | https://www.reichelt.at/at/de/shop/produkt/tmc2209_schrittmotor-treiber_2_0a-284702 | no | U2 | ~ | TMC2209_QFN28 | 1 | 10 | €3.33 | €3.33 | €33.30
8 | https://www.mouser.at/ProductDetail/Bourns/TC42X-2-203E?qs=A%2FHKLTFiEJHgsib30kUohg%3D%3D | no | RV1 | 20k | TC42X-2-203E | 1 | 10 | €0.39 | €0.29 | €2.90
9 |  | no | J1, J2 | Conn_01x08 | PinHeader_1x08_P2.54mm_Vertical | 2 | 20
10 |  | no | J3 | Conn_01x02 | PinHeader_1x02_P2.54mm_Vertical | 1 | 10
 |  |  |  |  |  |  |  |  | Summe | €42.80
