Sprudlwassr/FlexPrint/hardware/3D-Files/25251_Toolhead_Assembly_(JLC3DP)/MadMaxCarriage_v3.stl

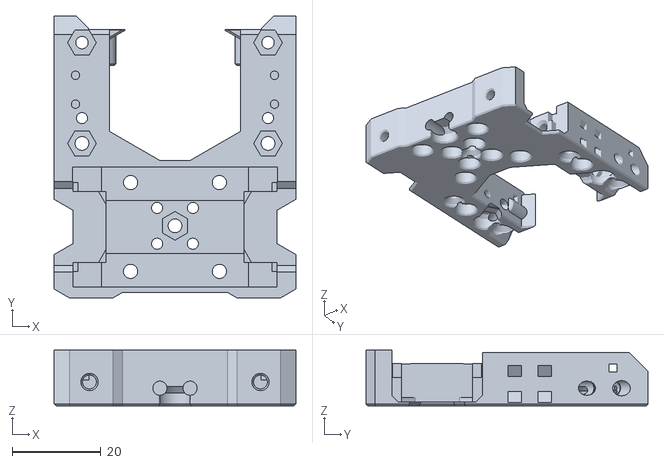
[picture p80: CAD file, 2026-06-08]
hardware/3D-Files/25251_Toolhead_Assembly_(JLC3DP)/MadMaxCarriage_v3.stl
54.4 x 63.5 x 12.6
