Sprudlwassr/FlexPrint/hardware/3D-Files/Haltelasche Z Vorne mit Linear Halterung.3mf

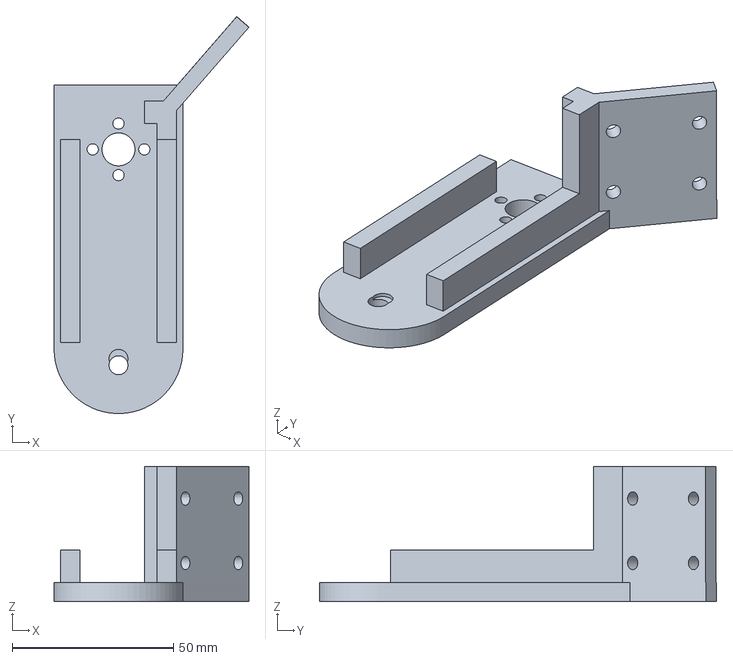
[picture p81: CAD file, 2026-06-08]
hardware/3D-Files/Haltelasche Z Vorne mit Linear Halterung.3mf
60.5 x 123.2 x 42.0 mm
