Sprudlwassr/FlexPrint/hardware/FlexPrint_library/3312J-1-203E.step

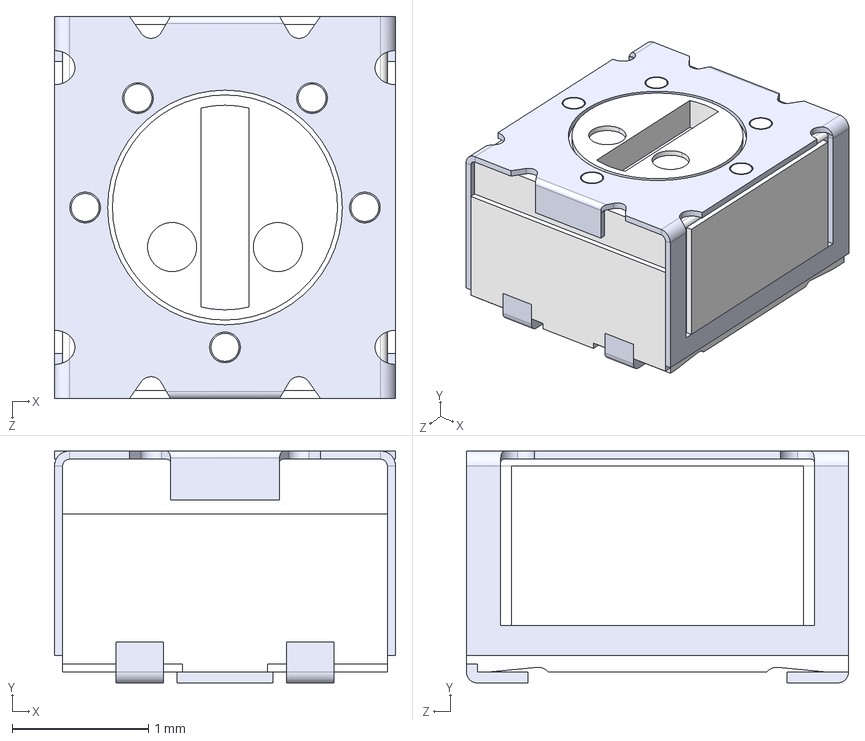
[picture p82: CAD file, 2025-12-04]
hardware/FlexPrint_library/3312J-1-203E.step
2.50 x 1.70 x 2.80 mm
