Sprudlwassr/FlexPrint/hardware/3D-Files/25251_Toolhead_Assembly_(JLC3DP)/A4T_Cowling_Bambu (2).stl

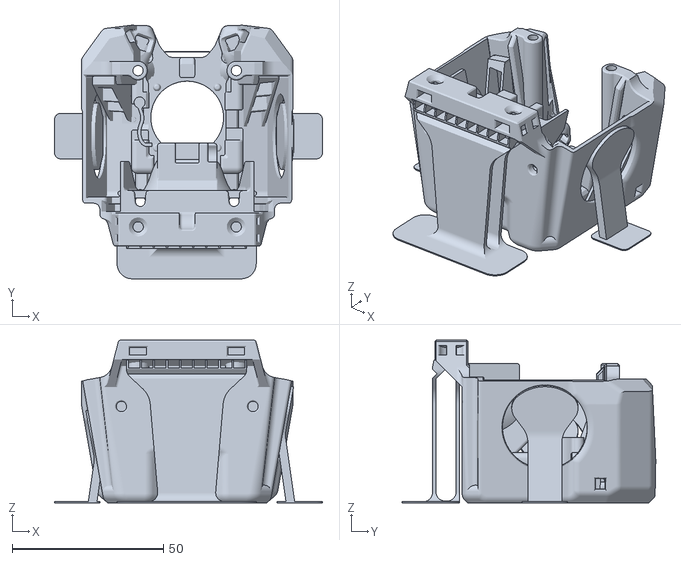
[picture p83: CAD file, 2026-06-08]
hardware/3D-Files/25251_Toolhead_Assembly_(JLC3DP)/A4T_Cowling_Bambu (2).stl
88.6 x 83.8 x 53.8
