Sprudlwassr/FlexPrint/hardware/3D-Files/MGN12_to_MGN9.stl

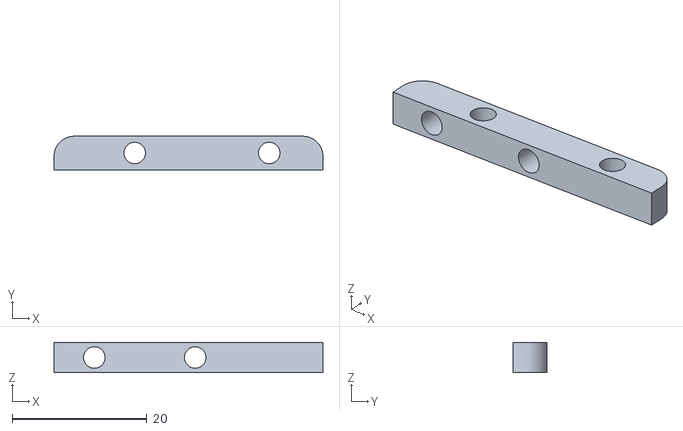
[picture p84: CAD file, 2026-03-27]
hardware/3D-Files/MGN12_to_MGN9.stl
40.0 x 5.00 x 4.50
