Sprudlwassr/FlexPrint/hardware/3D-Files/25251_Toolhead_Assembly_(JLC3DP)/Alternate Bracket_v3.stl

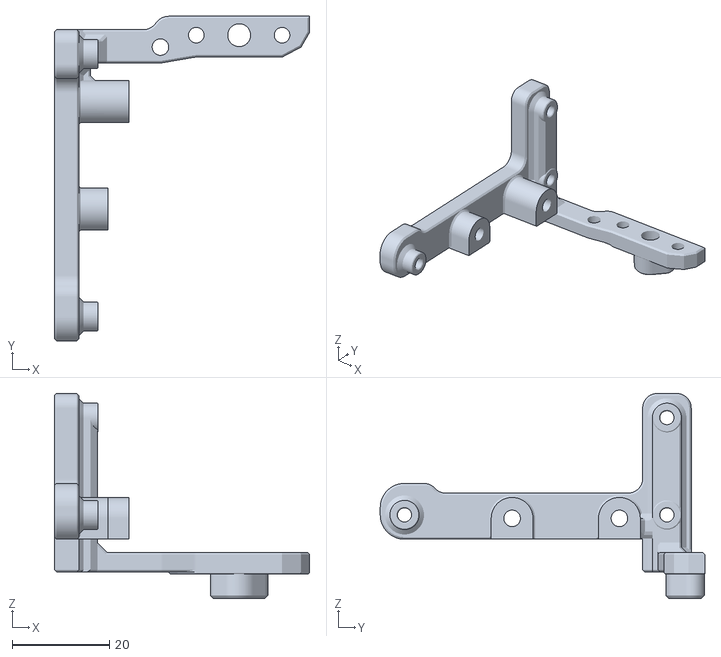
[picture p85: CAD file, 2026-06-08]
hardware/3D-Files/25251_Toolhead_Assembly_(JLC3DP)/Alternate Bracket_v3.stl
52.5 x 66.8 x 42.2
