Sprudlwassr/FlexPrint/(list of files, cad)

Other CAD files:
hardware/3D-Files/25251_Toolhead_Assembly_(JLC3DP)/A4T_Cowling_Bambu_v3 (2).stl
hardware/3D-Files/25251_Toolhead_Assembly_(JLC3DP)/MadMaxCarriage_v2.stl
hardware/3D-Files/25251_Toolhead_Assembly_(JLC3DP)/Alternate Bracket_v2.stl
hardware/3D-Files/25251_Toolhead_Assembly_(JLC3DP)/A4T_Cowling_Bambu_v2 (2).stl
hardware/3D-Files/Haltelasche Z Vorne mit Linear Halterung.stl
