Sprudlwassr/FlexPrint/hardware/3D-Files/25251_Toolhead_Assembly_(JLC3DP)/README.txt

Bitte bei allen Teilen das SLS Verfahren auswählen mit standard Material (3201PA-F Nylon).

Bei den 3 A4T_WWBG Dateien (Main Body, Motor Plate und Tension Arm) bitte das Material auf 3301PA Nylon ändern.

Stückzahl pro Datei ist Standardmäßig 1, wenn eine klammer mit Zahl im Dateinamen ist, dann diese Zahl als Stückzahl nehmen
Bsp.: Plate Assembly (2).stl <-- Quantity 2

Vielen Dank :)
