Sprudlwassr/FlexPrint/hardware/Powersupply/WBDesign1.pdf

## WEBENCH ® Design Report

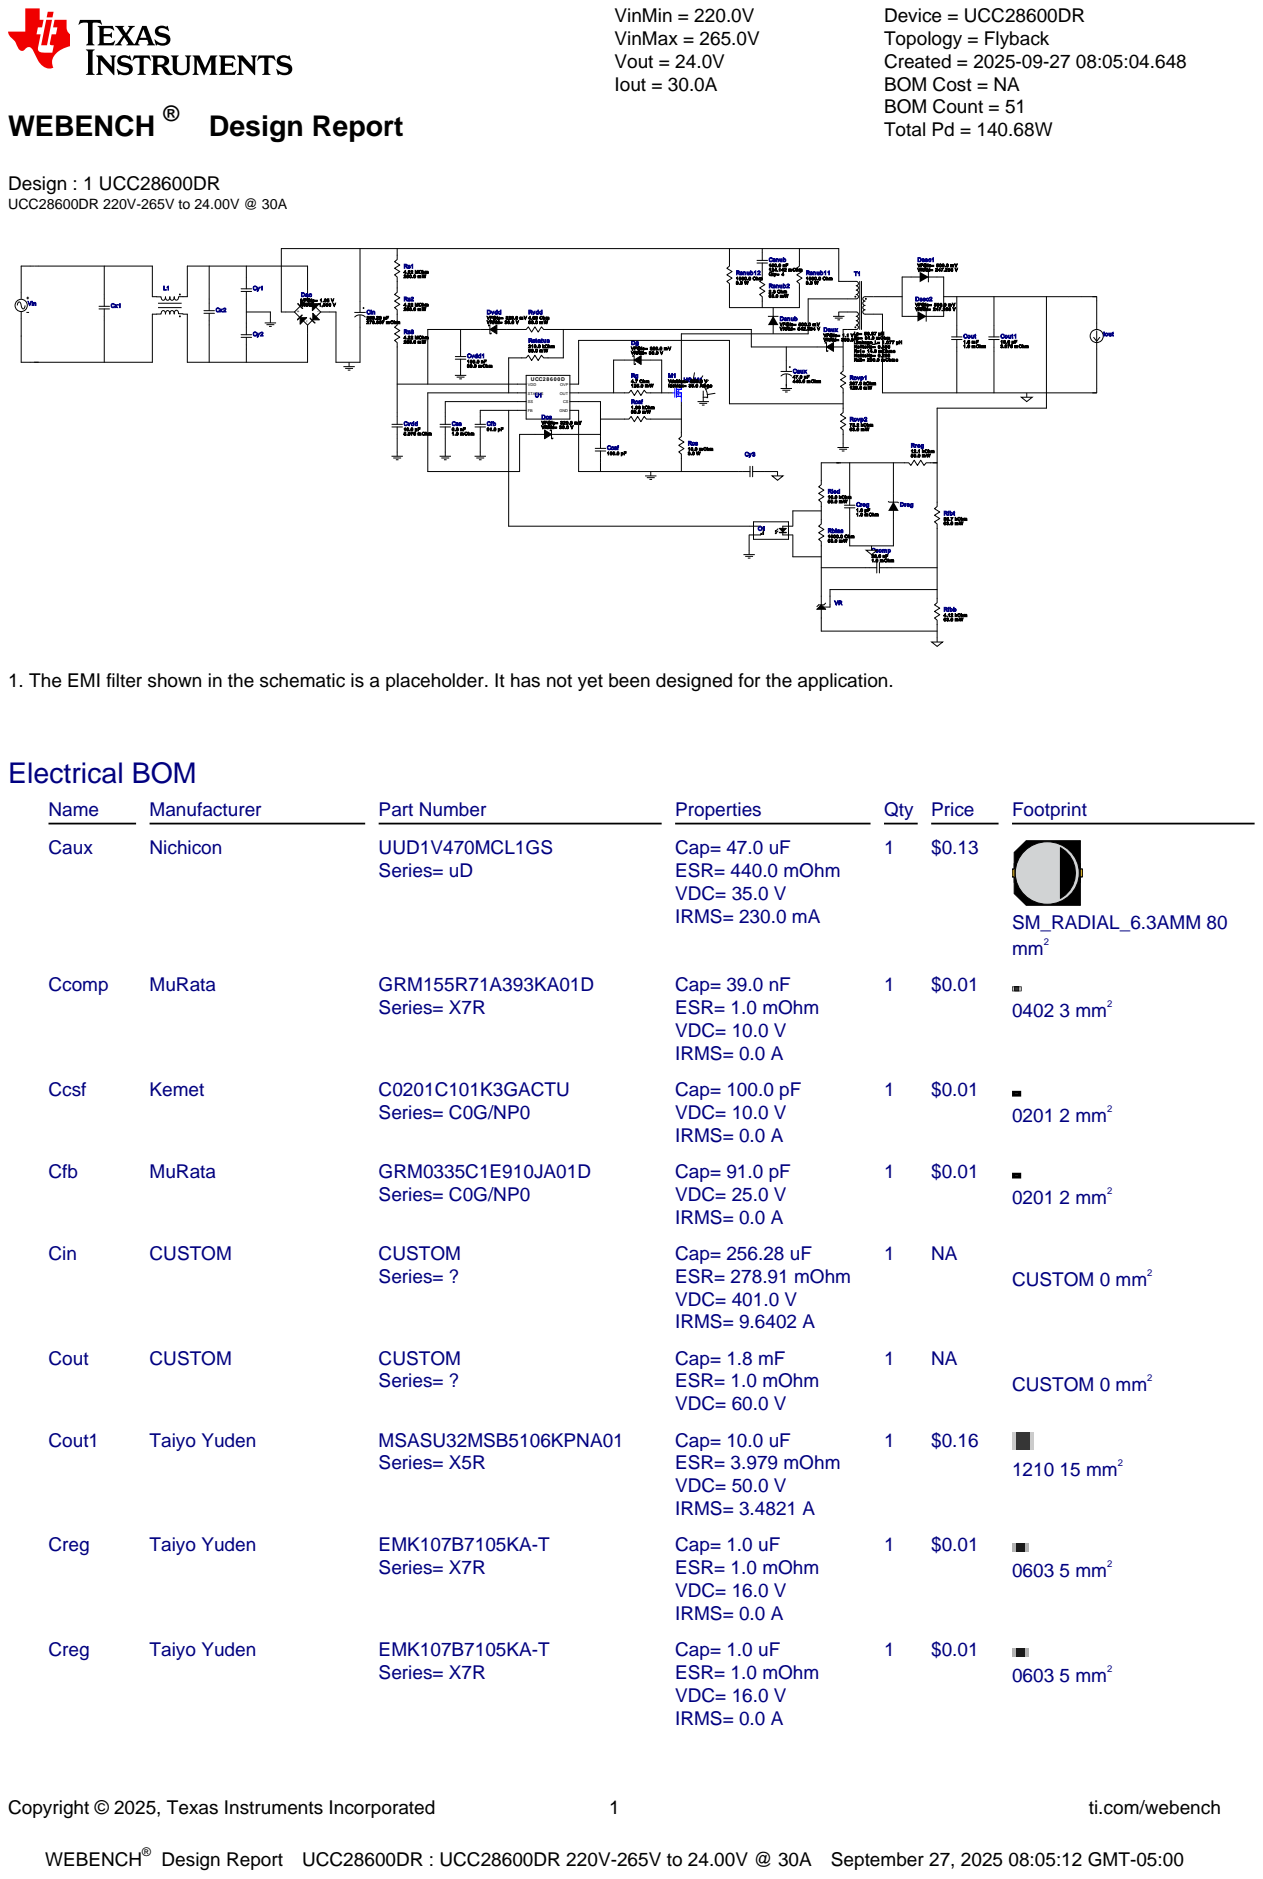
[picture p134: page 1]
Copyright © 2025, Texas Instruments Incorporated; ti.com/webench; WEBENCH®; Design : 1 UCC28600DR UCC28600DR 220V-265V to 24.00V @ 30A; VinMin = 220.0V VinMax = 265.0V Vout = 24.0V Iout = 30.0A; Rfbt 35.7 kOhm; Cvdd1 100.0 nF 30.0 m Ohm; Rsnub12 1000.0 Ohm 3.0 W; Ccom p 39.0 nF 1.0 m Ohm; Rbias 1000.0 Ohm 63.0 m W; Rled 10.0 kOhm; Creg; 1.0 m Ohm; Dreg; Rreg 12.1 kOhm 50.0 m W; Cin; 256.28 µF 278.907 m Ohm; 4.22 MOhm 250.0 m W; ~ ~ VRRM= 1,000 V; Rg 4.7 Ohm 125.0 m W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

Device = UCC28600DR
Topology = Flyback
Created = 2025-09-27 08:05:04.648
BOM Cost = NA
BOM Count = 51
Total Pd = 140.68W

VdsMax= 650.0 V
IdsMax= 35.0 Am ps

1. The EMI filter shown in the schematic is a placeholder. It has not yet been designed for the application.

Design Report UCC28600DR : UCC28600DR 220V-265V to 24.00V @ 30A September 27, 2025 08:05:12 GMT-05:00

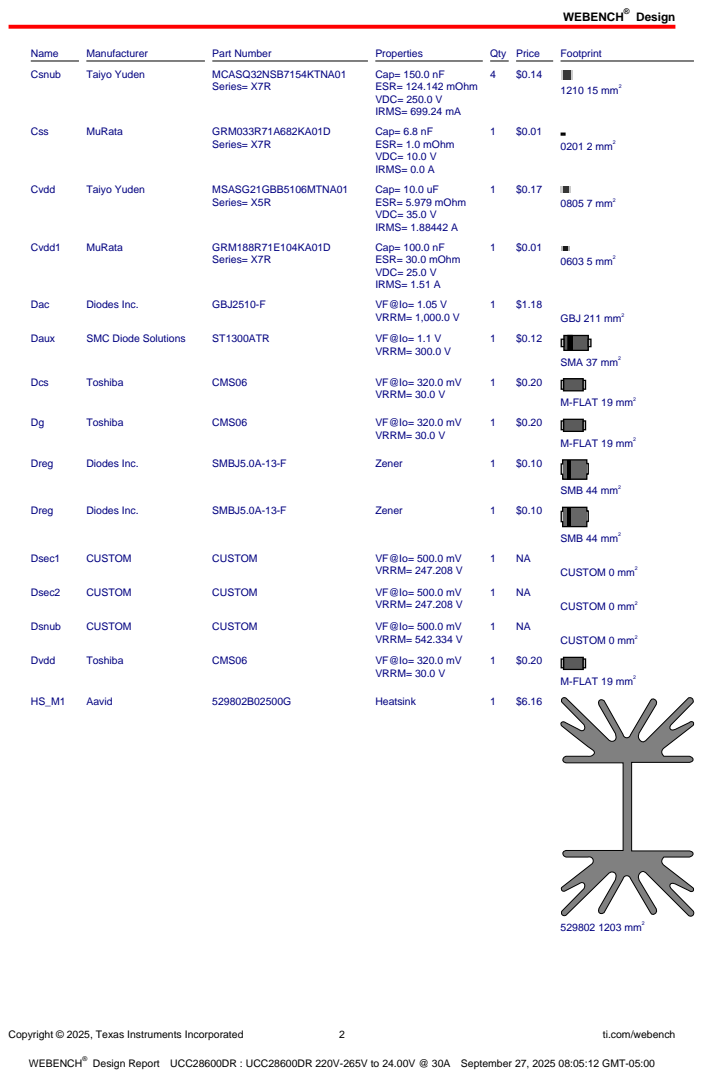
[picture p135: page 2]
Design; Copyright © 2025, Texas Instruments Incorporated; ti.com/webench; Name; Manufacturer; Part Number; Properties; Qty Price; Footprint; Csnub; Taiyo Yuden; MCASQ32NSB7154KTNA01; Series= X7R; Cap= 150.0 nF ESR= 124.142 mOhm VDC= 250.0 V IRMS= 699.24 mA; 1210 15 mm²; Css; MuRata; GRM033R71A682KA01D; Cap= 6.8 nF ESR= 1.0 mOhm VDC= 10.0 V IRMS= 0.0 A; 0201 2 mm²; Cvdd; MSASG21GBB5106MTNA01; Series= X5R; Cap= 10.0 uF ESR= 5.979 mOhm VDC= 35.0 V IRMS= 1.88442 A; 0805 7 mm²; Cvdd1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

Copyright © 2025, Texas Instruments Incorporated | 3 | ti.com/webench
Name | Manufacturer | Part Number | Properties | Qty Price | Footprint
M1 | STMicroelectronics | STP45N65M5 (http://www.st.com/content/ccc/resource/technical/document/datasheet/c4/34/e6/40/6d/70/4b/01/DM00049184.pdf/files/DM00049184.pdf/jcr:content/translations/en.DM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) | VdsMax= 650.0 V IdsMax= 35.0 Amps
1 | $6.03

TO-220AB 79 mm²
O1 | Vishay-Semiconductor | TCMT1107 | Optocoupler | 1 | $0.19
SOP-4 44 mm²
Rbias | Vishay-Dale | CRCW04021K00FKED (http://www.vishay.com/docs/20035/dcrcwe3.pdf) Series= CRCW..e3 | Res= 1000.0 Ohm Power= 63.0 mW Tolerance= 1.0% | 1 | $0.01
0402 3 mm²
Rcs | Susumu Co Ltd | KRL7638-C-R018-F-T1 (http://media.digikey.com/pdf/Data%20Sheets/Susumu%20PDFs/KRL%20Series.pdf) Series= KRL | Res= 18.0 mOhm Power= 3.0 W Tolerance= 1.0% | 1 | $0.56

3015 56 mm²
Rcsf | Vishay-Dale | CRCW04021K96FKED (http://www.vishay.com/docs/20035/dcrcwe3.pdf) Series= CRCW..e3

Res= 1.96 kOhm
Power= 63.0 mW
Tolerance= 1.0%

1 $0.01
0402 3 mm²
Rfbb | Vishay-Dale | CRCW04024K12FKED (http://www.vishay.com/docs/20035/dcrcwe3.pdf) Series= CRCW..e3

Res= 4.12 kOhm
Power= 63.0 mW
Tolerance= 1.0%

1 $0.01
0402 3 mm²
Rfbt | Vishay-Dale | CRCW040235K7FKED (http://www.vishay.com/docs/20035/dcrcwe3.pdf) Series= CRCW..e3

Res= 35.7 kOhm
Power= 63.0 mW
Tolerance= 1.0%

1 $0.01
0402 3 mm²
Rg | Yageo | RC0805FR-074R7L (http://www.yageo.com/documents/recent/PYu%2DRC0805%5F51%5FRoHS%5FL%5F6.pdf) Series= ?

Res= 4.7 Ohm
Power= 125.0 mW
Tolerance= 1.0%

1 $0.01
0805 7 mm²
Rled | Yageo | RC0201FR-0710KL (http://www.yageo.com/exep/pages/download/literatures/PYu%2DR%5FMarking%5F2.pdf) Series= ?

Res= 10.0 kOhm
Power= 50.0 mW
Tolerance= 1.0%

1 $0.01
0201 2 mm²
Rovp1 | Panasonic | ERJ-6ENF2673V Series= ERJ-6E

Res= 267.0 kOhm
Power= 125.0 mW
Tolerance= 1.0%

1 $0.01
0805 7 mm²
Rovp2 | Vishay-Dale | CRCW040273K2FKED (http://www.vishay.com/docs/20035/dcrcwe3.pdf) Series= CRCW..e3

Res= 73.2 kOhm
Power= 63.0 mW
Tolerance= 1.0%

1 $0.01
0402 3 mm²
Rreg | Yageo | RC0201FR-0712K1L (http://www.yageo.com/exep/pages/download/literatures/PYu%2DR%5FMarking%5F2.pdf) Series= ?

Res= 12.1 kOhm
Power= 50.0 mW
Tolerance= 1.0%

1 $0.01
0201 2 mm²
Rreg | Yageo | RC0201FR-0712K1L (http://www.yageo.com/exep/pages/download/literatures/PYu%2DR%5FMarking%5F2.pdf) Series= ?

Res= 12.1 kOhm
Power= 50.0 mW
Tolerance= 1.0%

1 $0.01
0201 2 mm²
Rs1 | Vishay-Dale | CRCW12064M22FKEA (http://www.vishay.com/docs/20035/dcrcwe3.pdf) Series= CRCW..e3

Res= 4.22 MOhm
Power= 250.0 mW
Tolerance= 1.0%

1 $0.01
1206 11 mm²
Rs2 | Vishay-Dale | CRCW12064M22FKEA (http://www.vishay.com/docs/20035/dcrcwe3.pdf) Series= CRCW..e3

Res= 4.22 MOhm
Power= 250.0 mW
Tolerance= 1.0%

1 $0.01
1206 11 mm²
Rs3 | Vishay-Dale | CRCW12064M22FKEA (http://www.vishay.com/docs/20035/dcrcwe3.pdf) Series= CRCW..e3

Res= 4.22 MOhm
Power= 250.0 mW
Tolerance= 1.0%

1 $0.01
1206 11 mm²
Rsnub11 Vishay-Bccomponents | PR03000201001JAC00 (http://www.vishay.com/docs/28729/pr010203.pdf)
| | Series= ?

Res= 1000.0 Ohm
Power= 3.0 W
Tolerance= 5.0%

1 $0.11

PR03 197 mm²
Rsnub12 Vishay-Bccomponents | PR03000201001JAC00 (http://www.vishay.com/docs/28729/pr010203.pdf)
| | Series= ?

Res= 1000.0 Ohm
Power= 3.0 W
Tolerance= 5.0%

1 $0.11

PR03 197 mm²
Rsnub2 | Vishay-Dale | CRCW04022R80FKED (http://www.vishay.com/docs/20035/dcrcwe3.pdf) Series= CRCW..e3

Res= 2.8 Ohm
Power= 63.0 mW
Tolerance= 1.0%

1 $0.01
0402 3 mm²

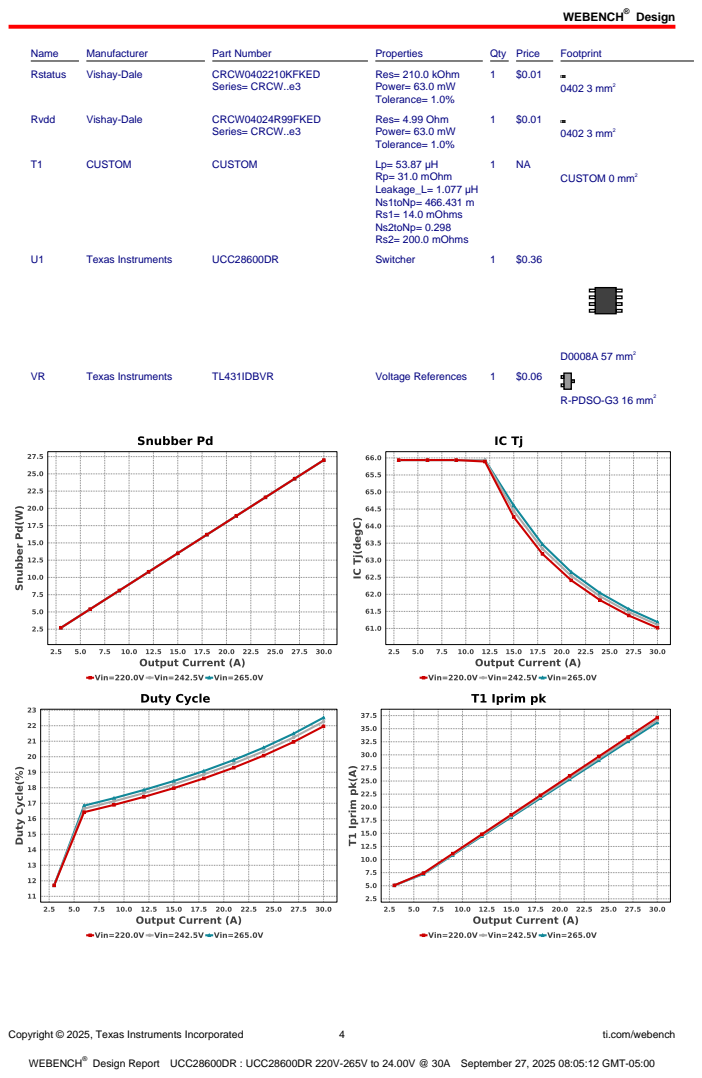
[picture p136: page 4]
Copyright © 2025, Texas Instruments Incorporated; ti.com/webench; Name; Manufacturer; Part Number; Properties; Qty Price; Footprint; Rstatus; Vishay-Dale; CRCW0402210KFKED; Series= CRCW..e3; Res= 210.0 kOhm Power= 63.0 mW Tolerance= 1.0%; 0402 3 mm²; Rvdd; CRCW04024R99FKED; Res= 4.99 Ohm Power= 63.0 mW Tolerance= 1.0%; CUSTOM; Rp= 31.0 mOhm Leakage_L= 1.077 µH Ns1toNp= 466.431 m Rs1= 14.0 mOhms Ns2toNp= 0.298 Rs2= 200.0 mOhms; CUSTOM 0 mm²; Texas Instruments; UCC28600DR; Switcher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

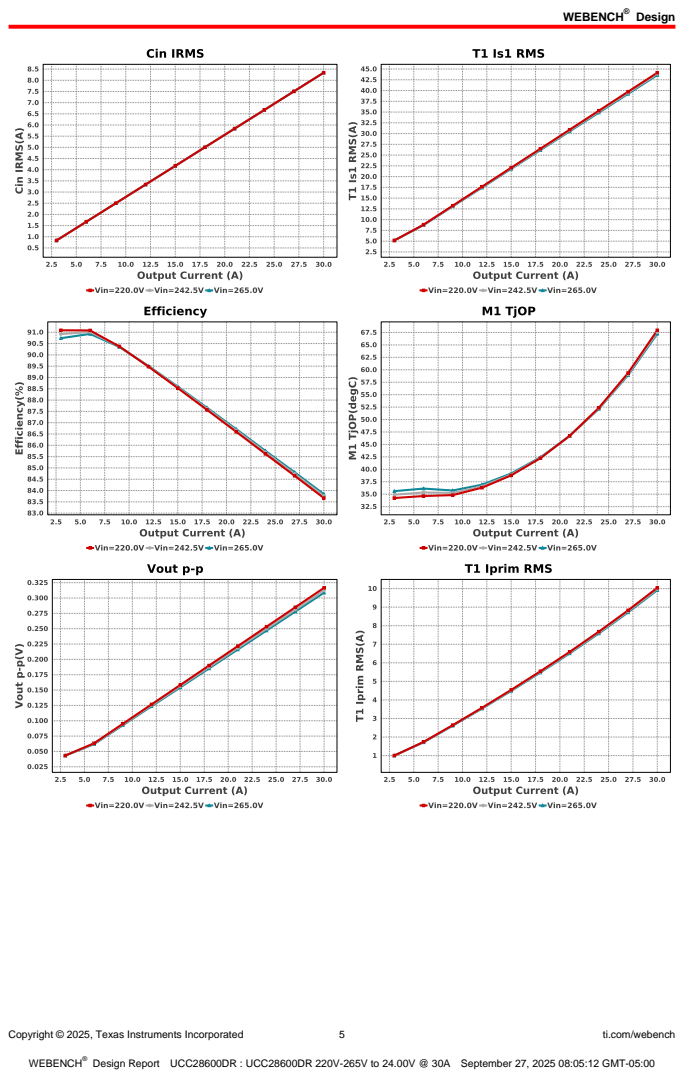
[picture p137: page 5]
Copyright © 2025, Texas Instruments Incorporated; ti.com/webench

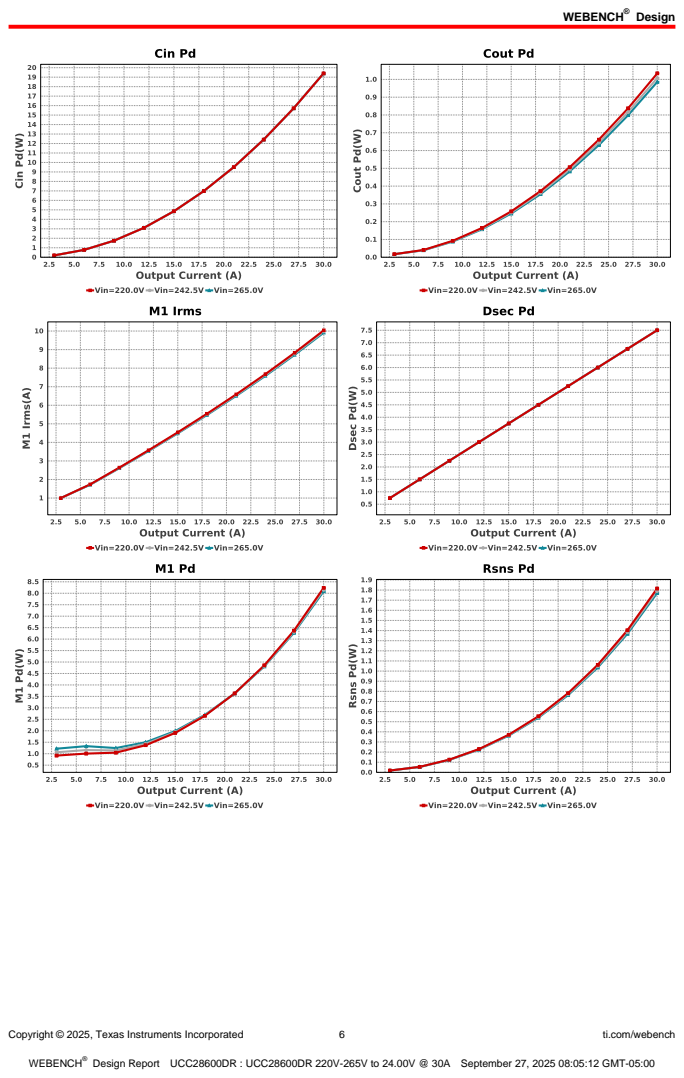
[picture p138: page 6]
Copyright © 2025, Texas Instruments Incorporated; ti.com/webench

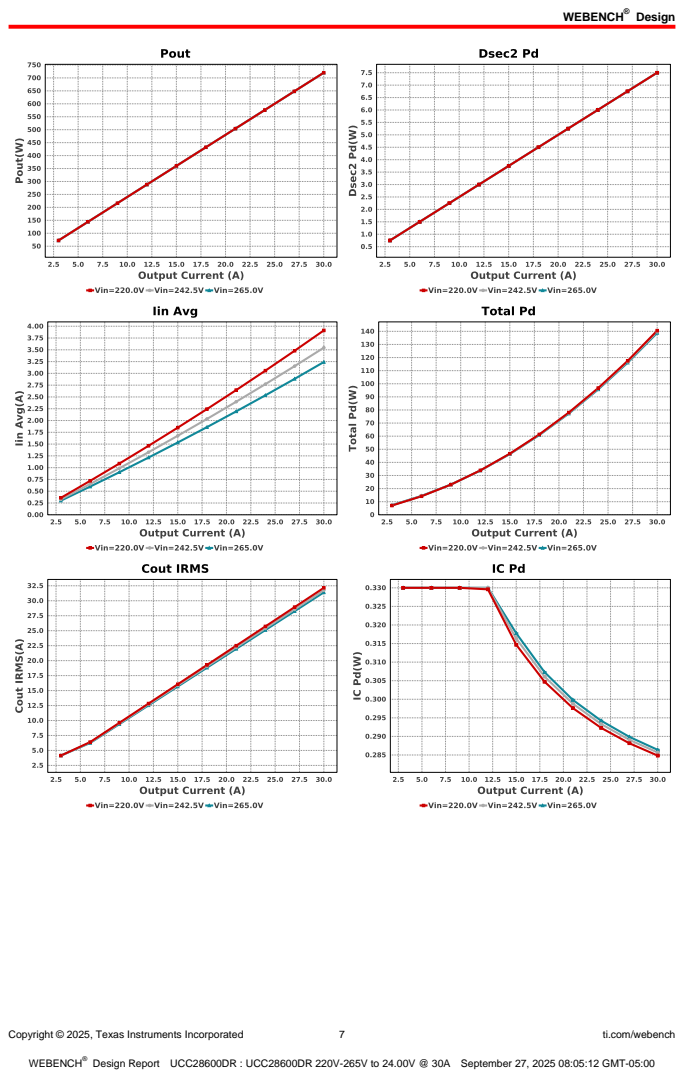
[picture p139: page 7]
Copyright © 2025, Texas Instruments Incorporated; ti.com/webench

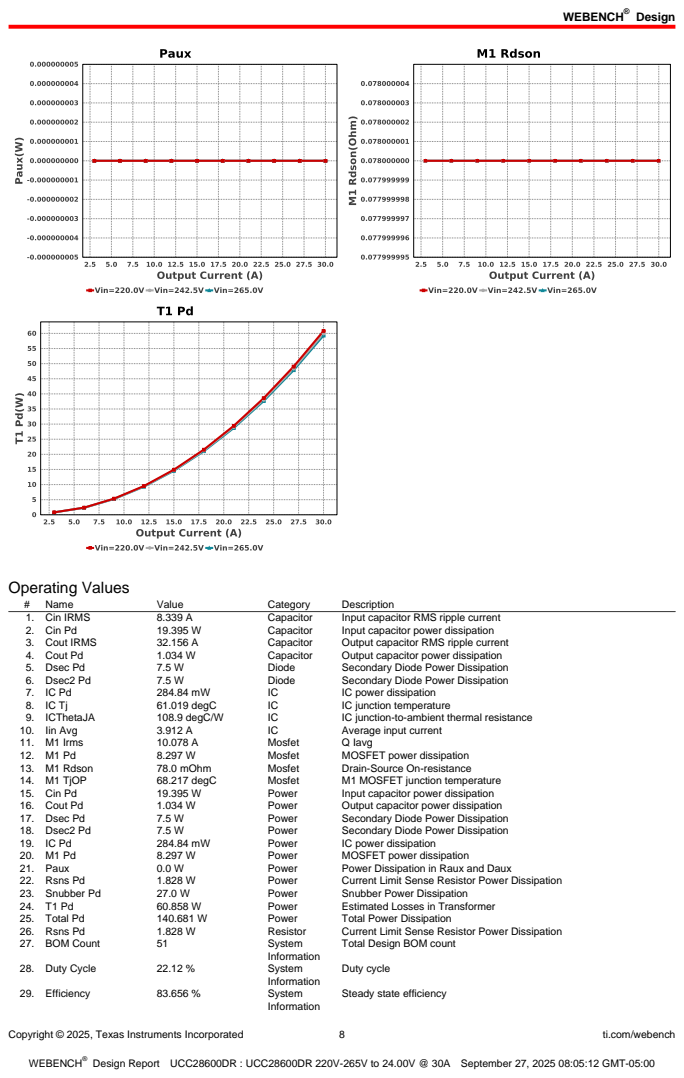
[picture p140: page 8]
Copyright © 2025, Texas Instruments Incorporated; ti.com/webench; Operating Values; Name; Value; Category; Description; 1. Cin IRMS; Capacitor; Input capacitor RMS ripple current; 2. Cin Pd; Input capacitor power dissipation; 3. Cout IRMS; Output capacitor RMS ripple current; 4. Cout Pd; Output capacitor power dissipation; 5. Dsec Pd; Diode; Secondary Diode Power Dissipation; 6. Dsec2 Pd; IC power dissipation; 61.019 degC; IC junction temperature; 9. ICThetaJA; 108.9 degC/W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

Total Design BOM count

Steady state efficiency

Copyright © 2025, Texas Instruments Incorporated | 9 | ti.com/webench
# | Name | Value | Category | Description

30. FootPrint | 2.598 k mm² | System
| | | Information | Total Foot Print Area of BOM components
31. Frequency | 24.258 kHz | System
| | | Information | Switching frequency
32. Iout | 30.0 A | System
| | | Information | Iout operating point
33. Mode | DCM | System
| | | Information | Conduction Mode
34. Pout | 720.06 W | System
| | | Information | Total output power
35. Total BOM | NA | System
| | | Information | Total BOM Cost
36. Vin | 220.0 V | System
| | | Information | Vin operating point
37. Vout | 24.0 V | System
| | | Information | Operational Output Voltage
38. Vout p-p | 316.605 mV | System
| | | Information | Peak-to-peak output ripple voltage
39. Paux | 0.0 W | Transformer | Power Dissipation in Raux and Daux
40. T1 Iprim RMS | 10.078 A | Transformer | Transformer Primary RMS Current
41. T1 Iprim pk | 37.113 A | Transformer | Transformer Primary Peak Current
42. T1 Is1 RMS | 44.143 A | Transformer | Transformer Secondary1 RMS Current
43. T1 Pd | 60.858 W | Transformer | Estimated Losses in Transformer

## Design Inputs

Name | Value | Description
Iout | 30.0 | Maximum Output Current
VinMax | 265.0 | Maximum input voltage
VinMin | 220.0 | Minimum input voltage
Vout | 24.0 | Output Voltage
acFrequency | 50.0 | AC Frequency
| base_pn | | UCC28600 | Base Product Number
source | AC | Input Source Type
Ta | 30.0 | Ambient temperature


Copyright © 2025, Texas Instruments Incorporated | 10 | ti.com/webench

## Assembly

## Component Testing

Some published data on components in datasheets such as Capacitor ESR and Inductor DC resistance is based on conservative values that will guarantee that the components always exceed the specification. For design purposes it is usually better to work with typical values. Since this data is not always available it is a good practice to measure the Capacitance and ESR values of Cin and Cout, and the inductance and DC resistance of L1 before assembly of the board. Any large discrepancies in values should be electrically simulated in WEBENCH to check for instabilities and thermally simulated in WebTHERM to make sure critical temperatures are not exceeded.

## Soldering Component to Board

If board assembly is done in house it is best to tack down one terminal of a component on the board then solder the other terminal. For surface mount parts with large tabs, such as the DPAK, the tab on the back of the package should be pre-tinned with solder, then tacked into place by one of the pins. To solder the tab town to the board place the iron down on the board while resting against the tab, heating both surfaces simultaneously. Apply light pressure to the top of the plastic case until the solder flows around the part and the part is flush with the PCB. If the solder is not flowing around the board you may need a higher wattage iron (generally 25W to 30W is enough).

## Initial Startup of Circuit

It is best to initially power up the board by setting the input supply voltage to the lowest operating input voltage 220.0V and set the input supply's current limit to zero. With the input supply off connect up the input supply to Vin and GND. Connect a digital volt meter and a load if needed to set the minimum Iout of the design from Vout and GND. Turn on the input supply and slowly turn up the current limit on the input supply. If the voltage starts to rise on the input supply continue increasing the input supply current limit while watching the output voltage. If the current increases on the input supply, but the voltage remains near zero, then there may be a short or a component misplaced on the board. Power down the board and visually inspect for solder bridges and recheck the diode and capacitor polarities. Once the power supply circuit is operational then more extensive testing may include full load testing, transient load and line tests to compare with simulation results.

## Load Testing

The setup is the same as the initial startup, except that an additional digital voltmeter is connected between Vin and GND, a load is connected between Vout and GND and a current meter is connected in series between Vout and the load. The load must be able to handle at least rated output power + 50% ( 7.5 watts for this design). Ideally the load is supplied in the form of a variable load test unit. It can also be done in the form of suitably large power resistors. When using an oscilloscope to measure waveforms on the prototype board, the ground leads of the oscilloscope probes should be as short as possible and the area of the loop formed by the ground lead should be kept to a minimum. This will help reduce ground lead inductance and eliminate EMI noise that is not actually present in the circuit.

## Design Assistance

1. Quasi-Resonant Flyback Green-Mode Controller
2. Master key : CD3AC80E598892CF1F32BD0F49DB9A50[v1]
3. UCC28600 Product Folder : http://www.ti.com/product/UCC28600 : contains the data sheet and other resources.

Copyright © 2025, Texas Instruments Incorporated | 11 | ti.com/webench

Important Notice and Disclaimer

TI provides technical and reliability data (including datasheets), design resources (including reference designs), application or other design advice, web tools, safety information, and other resources AS IS and with all faults, and disclaims all warranties. These resources are intended for skilled developers designing with TI products. You are solely responsible for (1) selecting the appropriate TI products for your application, (2) designing, validating and testing your application, and (3) ensuring your application meets applicable standards, and any other safety, security, or other requirements.

These resources are subject to change without notice. TI grants you permission to use these resources only for development of an application that uses the TI products described in the resource. Other reproduction and display of these resources is prohibited. No license is granted to any other TI intellectual property right or to any third party intellectual property right. TI disclaims responsibility for, and you will fully indemnify TI and its representatives against, any claims, damages, costs, losses, and liabilities arising out of your use of these resources.

Providing these resources does not expand or otherwise alter TI's applicable Terms of Sale or other applicable terms available either on ti.com or provided in conjunction with TI products.
