Sprudlwassr/FlexPrint/hardware/TMC2209_driver/bestückungshilfe.pdf

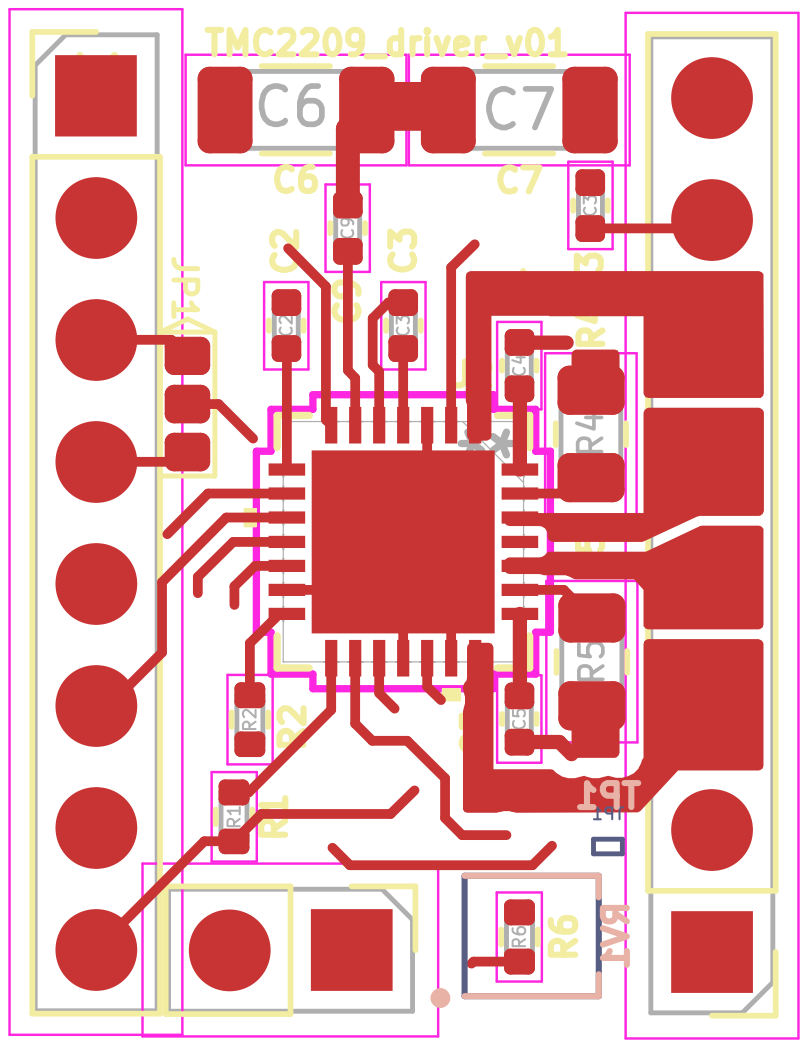
[picture p142: page 1]
