Sprudlwassr/FlexPrint/hardware/Powersupply/Netzteilschematic.pdf

RR

ss

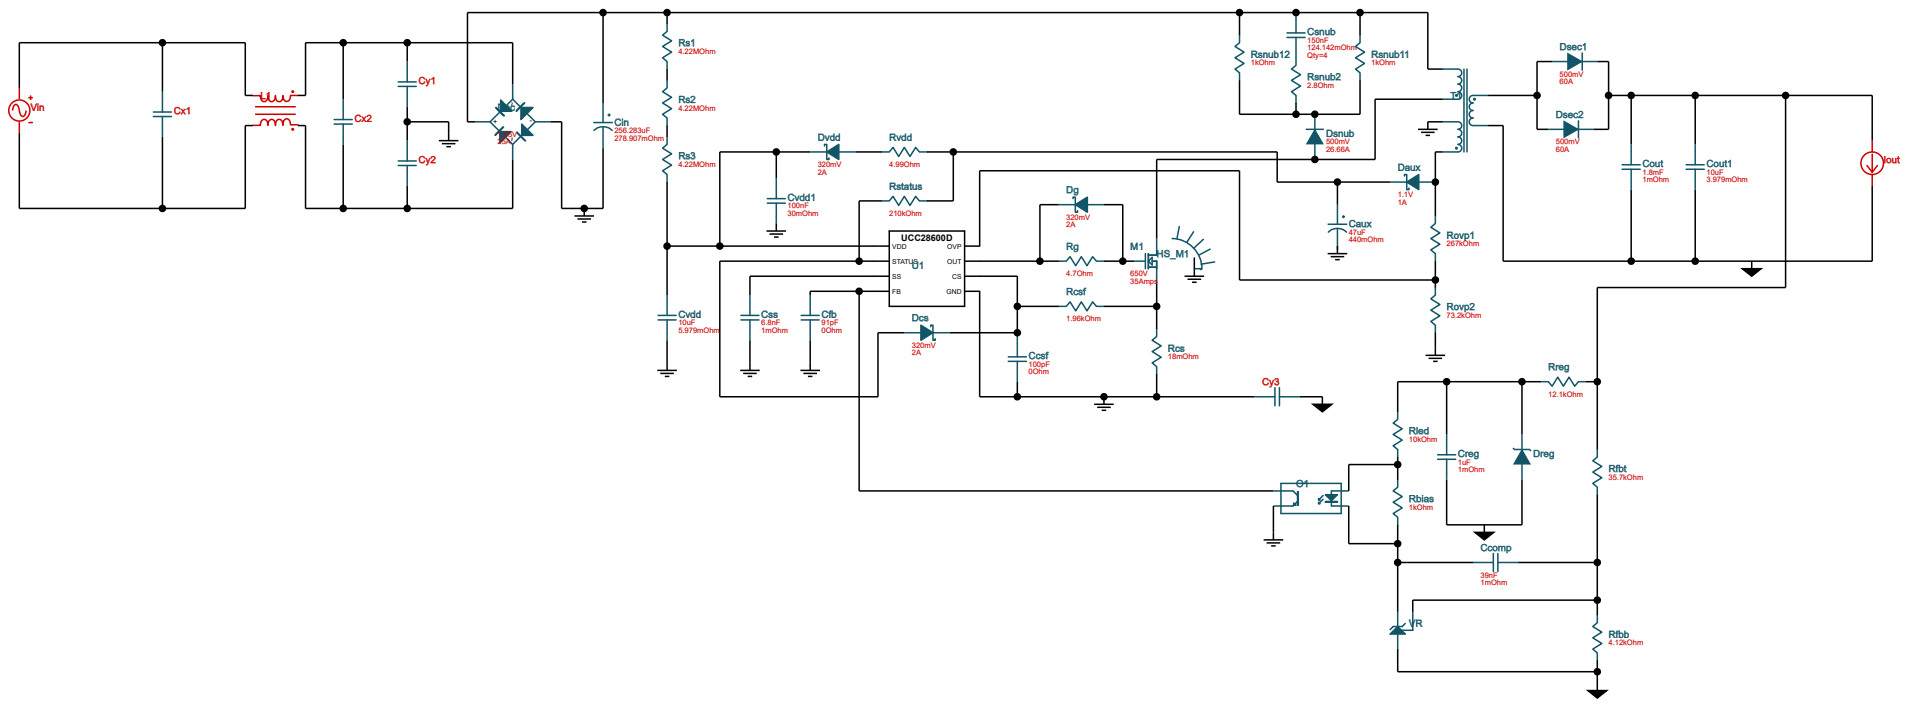
[picture p143: page 1]
bia; Rle; Cin 225566.. 22; TAT; Vin
