Sprudlwassr/FlexPrint/documents/graphics/Mainboard_Schaltplan.pdf

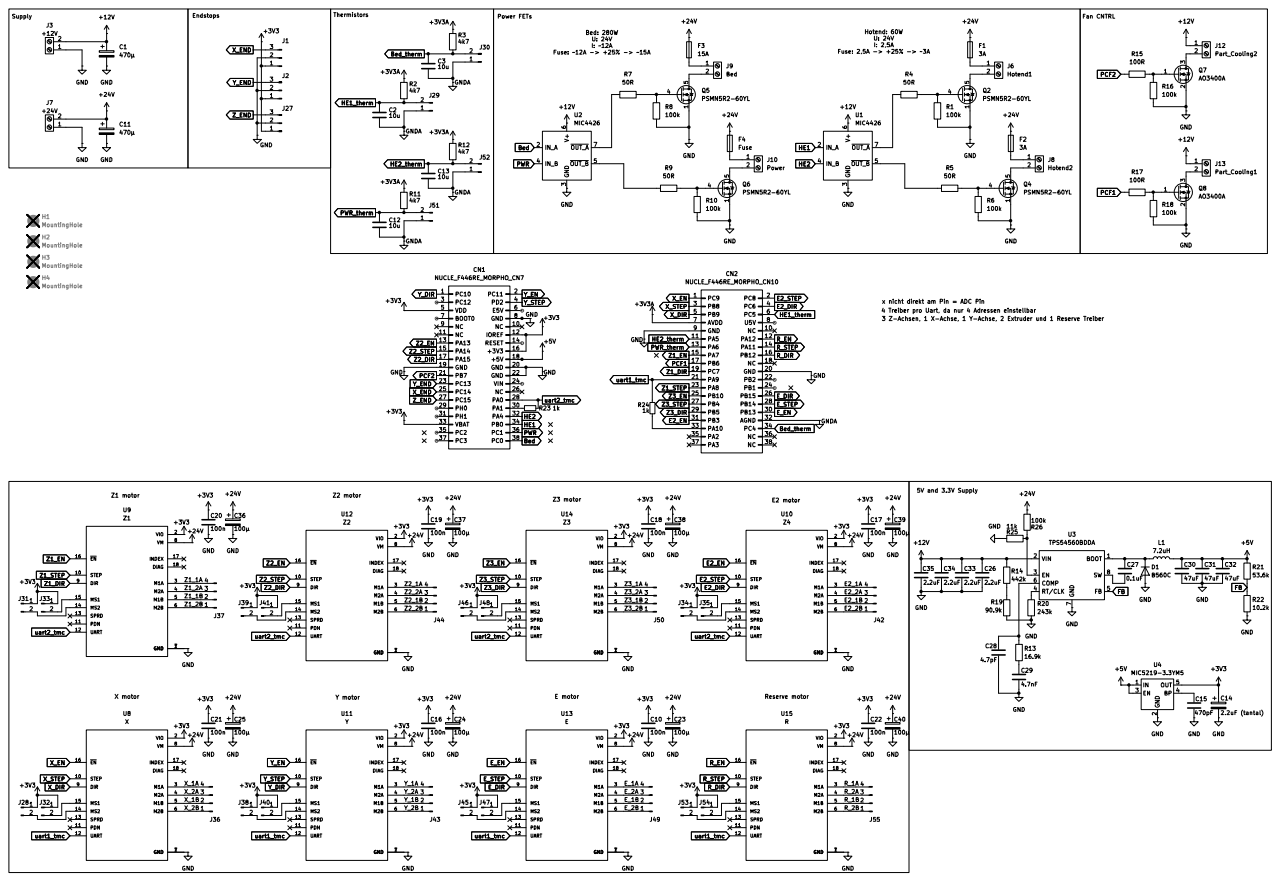
[picture p144: page 1]
