Sprudlwassr/FlexPrint/documents/graphics/Mainboard_Schaltplan2.pdf

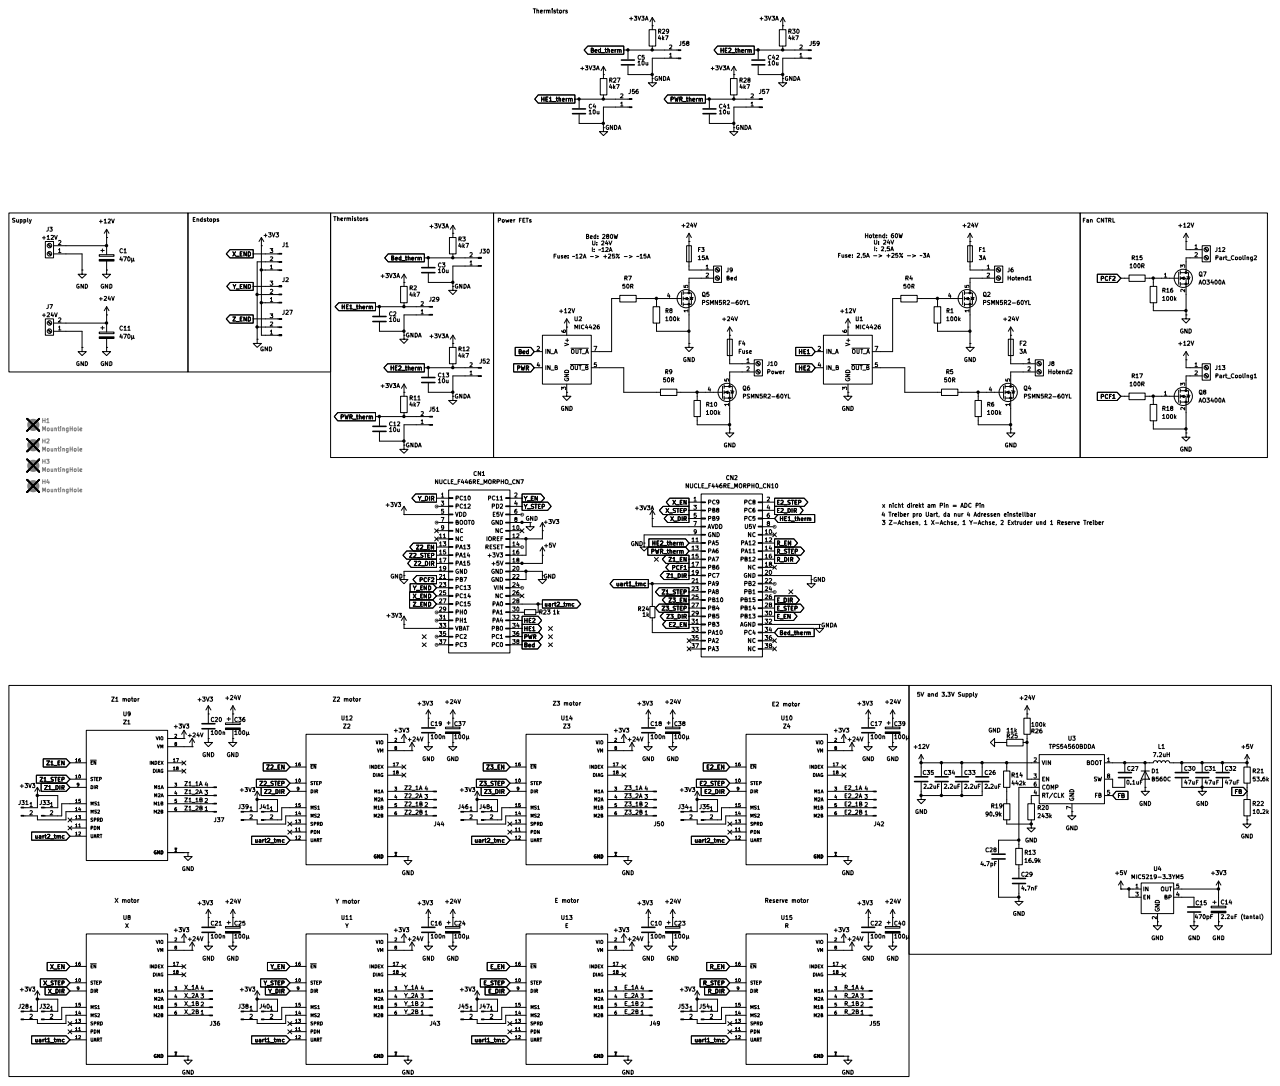
[picture p145: page 1]
