Sprudlwassr/FlexPrint/documents/graphics/Treiberplatine_Schaltplan.pdf

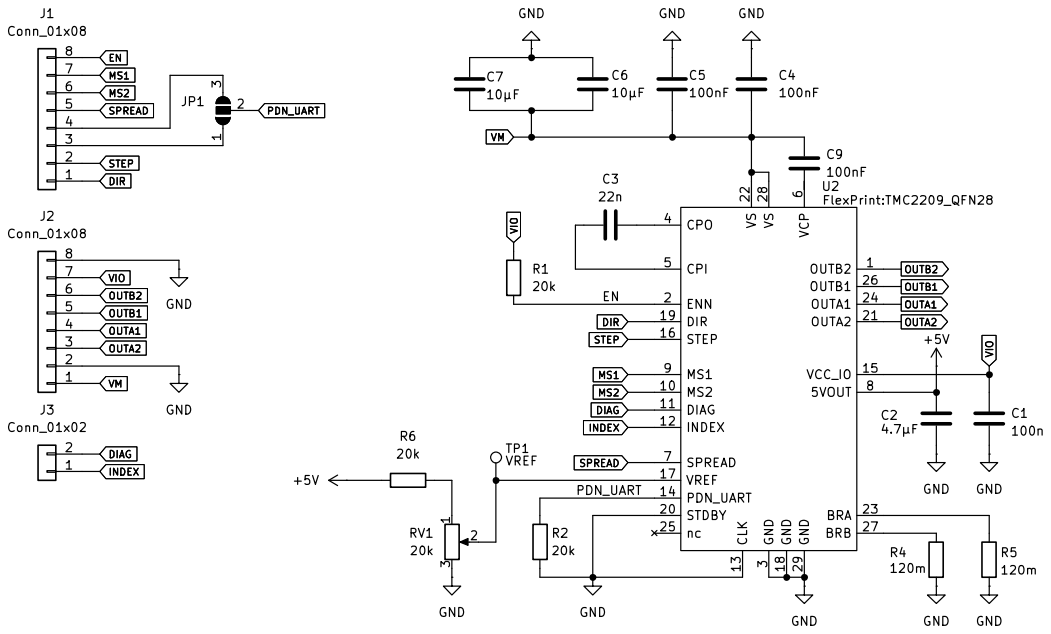
[picture p146: page 1]
