Sprudlwassr/FlexPrint/hardware/TMC2209_driver/TMC2209_driver/TMC2209_driver.kicad_pcb

## KiCad design hardware/TMC2209_driver/TMC2209_driver/TMC2209_driver.kicad_pcb (2026-03-27)

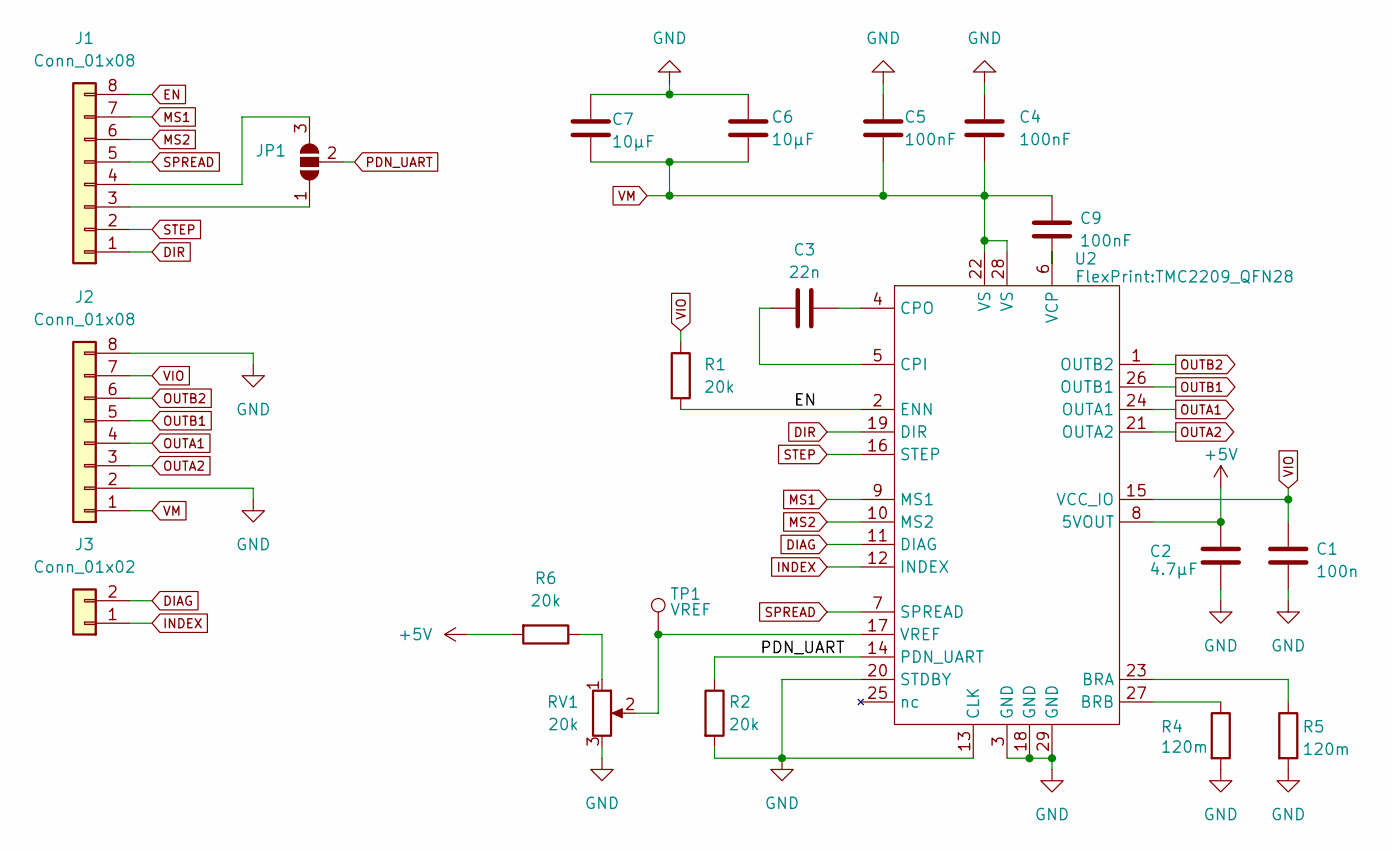
[picture p147: schematic TMC2209_driver.kicad_sch]

Parts:
C1: 100n; C_0402_1005Metric
C2: 4.7µF; C_0402_1005Metric
C3: 22n; C_0402_1005Metric
C4, C5, C9: 100nF; C_0402_1005Metric
C6, C7: 10µF; C_1206_3216Metric
J1, J2: Conn_01x08; PinHeader_1x08_P2.54mm_Vertical
J3: Conn_01x02; PinHeader_1x02_P2.54mm_Vertical
JP1: SolderJumper_3_Open; SolderJumper_3Pads
R1, R2, R6: 20k; R_0402_1005Metric
R4, R5: 120m; R_0805_2012Metric
RV1: 20k; TRIMMER_3312J-1-203E
TP1: VREF; TestPoint_Pad_D1.0mm
U2: TMC2209_QFN28

Connections:
+5V: C2.1, R6.2, U2.8 (5VOUT)
DIAG: J3.2, U2.11 (DIAG)
DIR: J1.1, U2.19 (DIR)
EN: J1.8, R1.2, U2.2 (ENN)
GND: C1.2, C2.2, C4.1, C5.1, C6.1, C7.1, J2.2, J2.8, R2.2, R4.2, R5.2, RV1.3, U2.3 (GND), U2.13 (CLK), U2.18 (GND), U2.20 (STDBY), U2.29 (GND)
INDEX: J3.1, U2.12 (INDEX)
MS1: J1.7, U2.9 (MS1)
MS2: J1.6, U2.10 (MS2)
unnamed: J1.3, JP1.1 (A)
unnamed: J1.4, JP1.3 (B)
unnamed: R6.1, RV1.1
unnamed: R5.1, U2.23 (BRA)
unnamed: R4.1, U2.27 (BRB)
unnamed: C3.1, U2.5 (CPI)
unnamed: C3.2, U2.4 (CPO)
unnamed: C9.2, U2.6 (VCP)
unnamed: RV1.2, TP1.1, U2.17 (VREF)
OUTA1: J2.4, U2.24 (OUTA1)
OUTA2: J2.3, U2.21 (OUTA2)
OUTB1: J2.5, U2.26 (OUTB1)
OUTB2: J2.6, U2.1 (OUTB2)
PDN_UART: JP1.2 (C), R2.1, U2.14 (PDN_UART)
SPREAD: J1.5, U2.7 (SPREAD)
STEP: J1.2, U2.16 (STEP)
VIO: C1.1, J2.7, R1.1, U2.15 (VCC_IO)
VM: C4.2, C5.2, C6.2, C7.2, C9.1, J2.1, U2.22 (VS), U2.28 (VS)

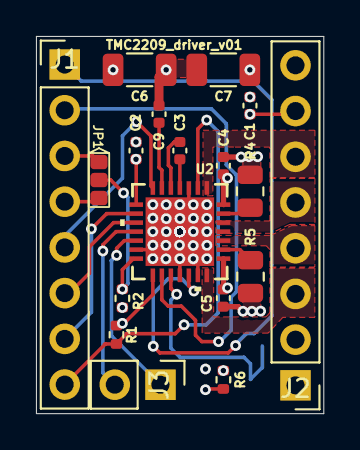
[picture p148: board TMC2209_driver.kicad_pcb from above]

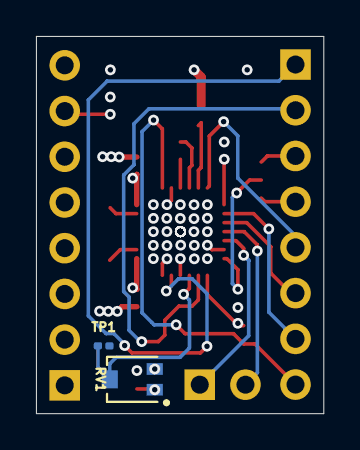
[picture p149: board TMC2209_driver.kicad_pcb from below]

Board: 4 copper layers, 16.0 x 21.0 mm, 20 parts (2 on the bottom side), 26 nets.
