Sprudlwassr/FlexPrint/hardware/Mainboard/Mainboard.kicad_pcb

## KiCad design hardware/Mainboard/Mainboard.kicad_pcb (2026-03-27)

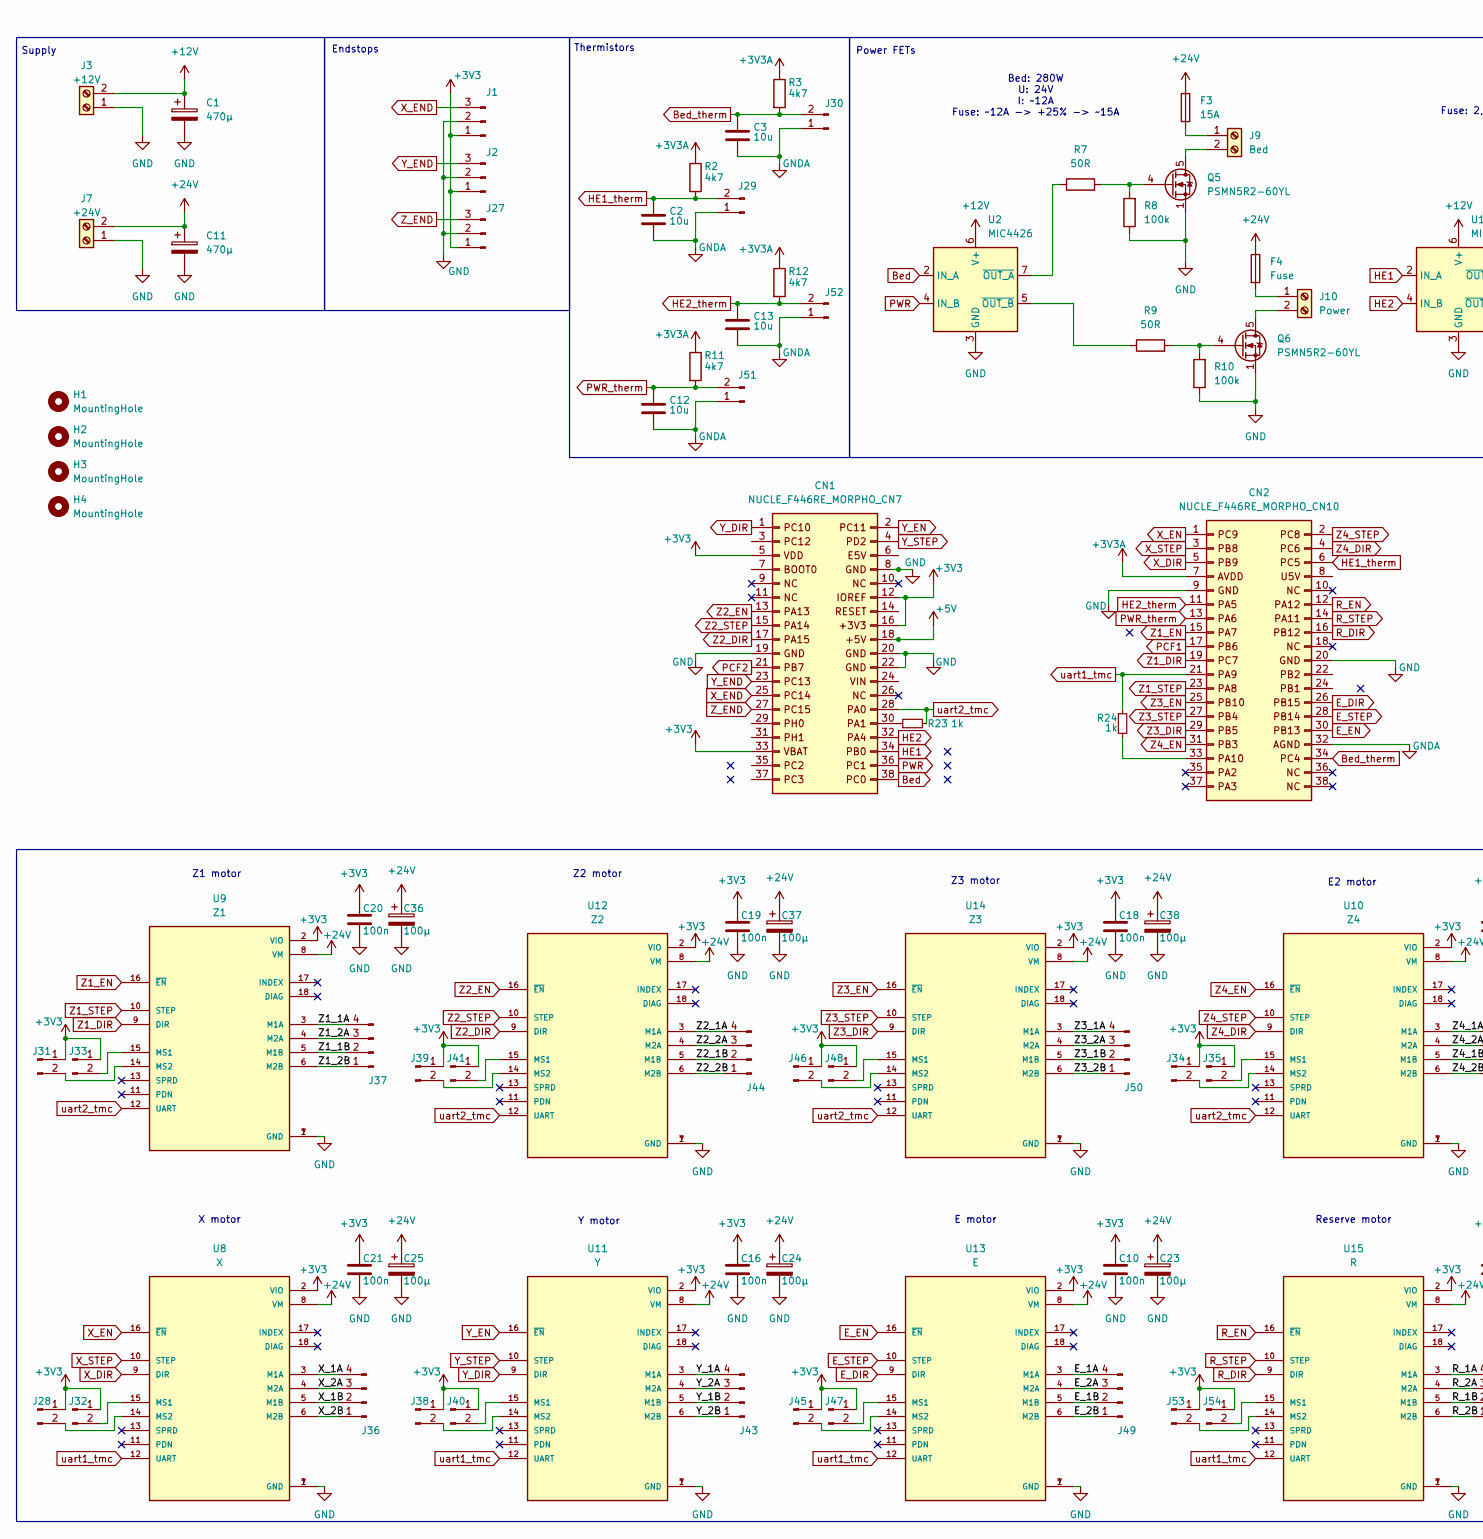
[picture p150: schematic Mainboard.kicad_sch, part in row 1, column 1]

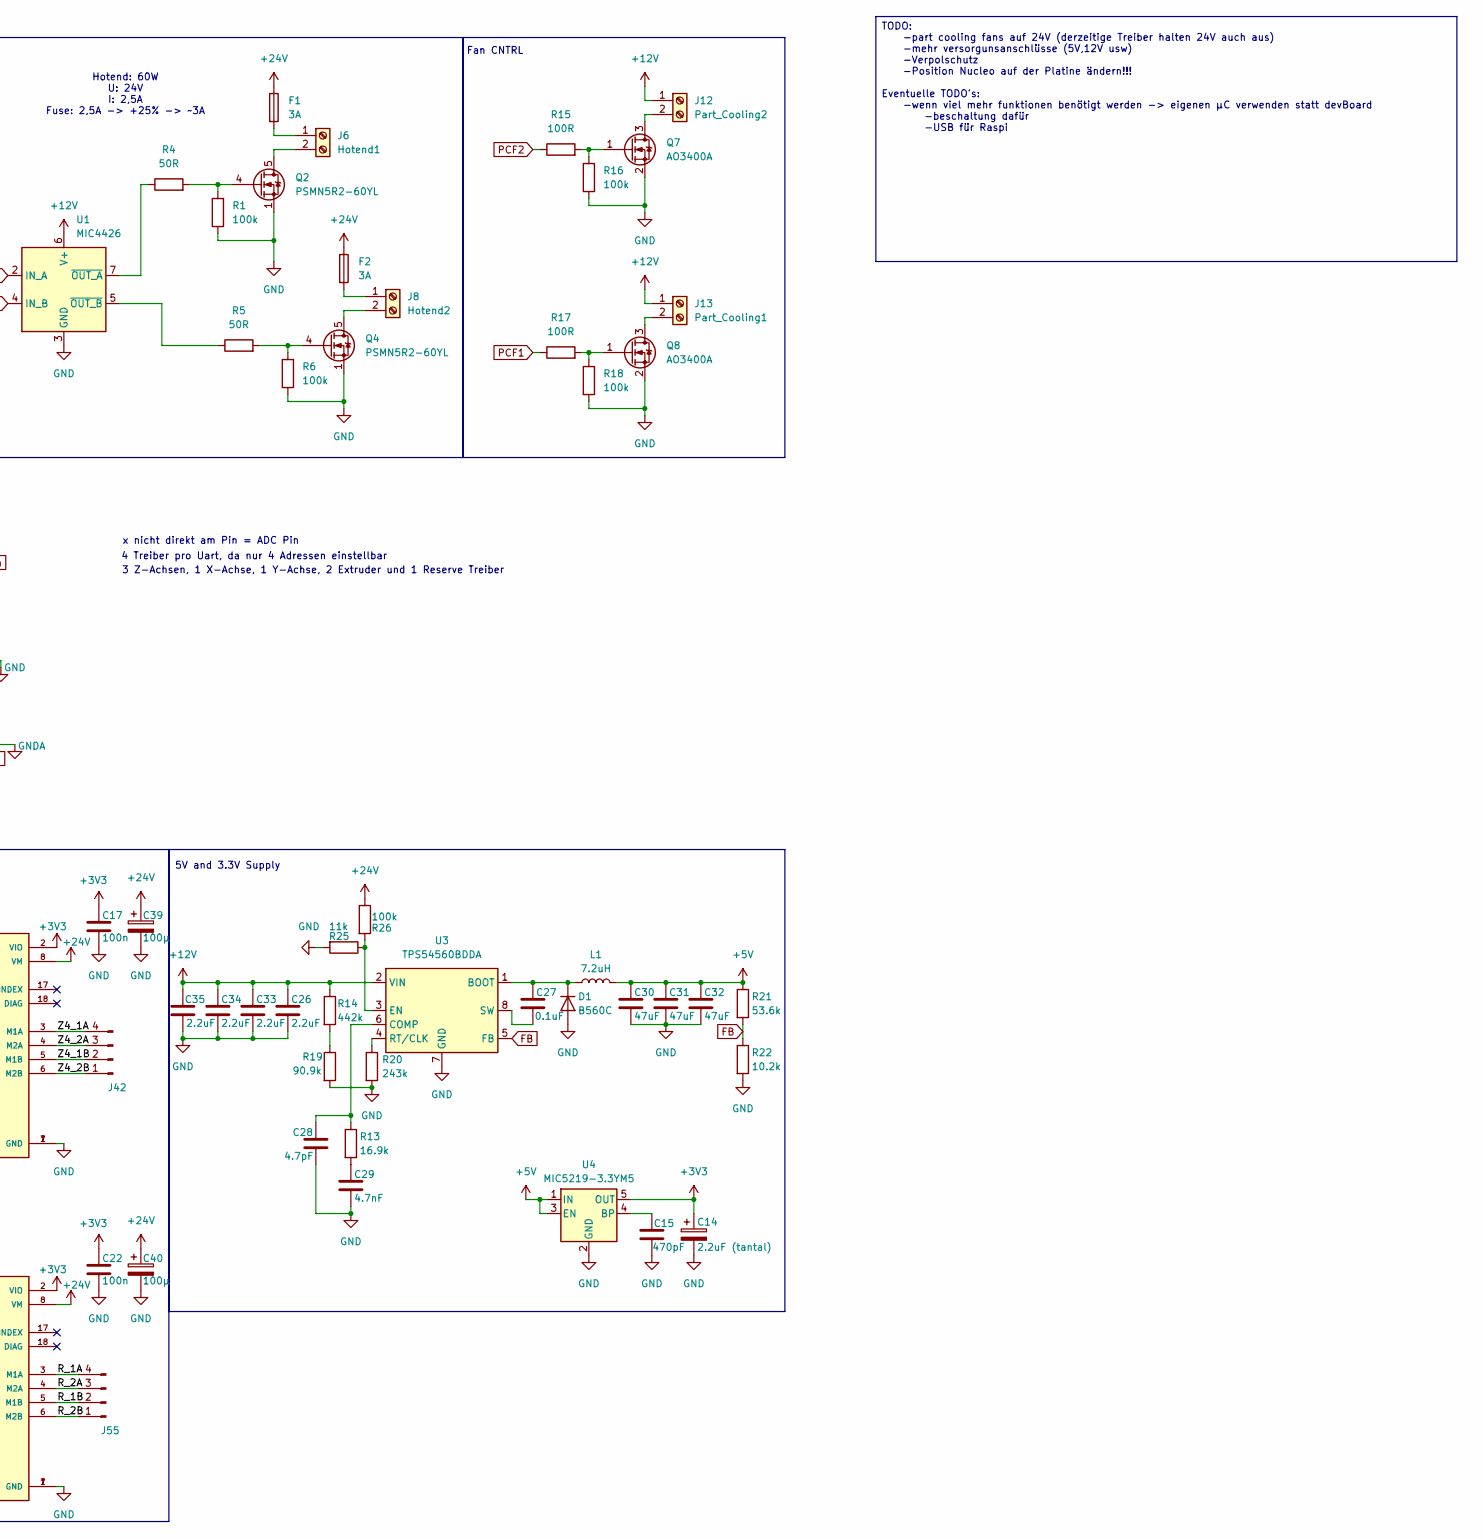
[picture p151: schematic Mainboard.kicad_sch, part in row 1, column 2]

Parts:
C1, C11: 470µ; CP_Elec_16x17.5
C2, C3, C12, C13: 10u; C_0805_2012Metric
C10, C16, C17, C18, C19, C20, C21, C22: 100n; C_0805_2012Metric
C14: 2.2uF (tantal); CP_EIA-3216-10_Kemet-I
C15: 470pF; C_0805_2012Metric
C23, C24, C25, C36, C37, C38, C39, C40: 100µ; CP_Elec_8x10
C26, C33, C34, C35: 2.2uF; C_0805_2012Metric
C27: 0.1uF; C_0805_2012Metric
C28: 4.7pF; C_0805_2012Metric
C29: 4.7nF; C_0805_2012Metric
C30, C31, C32: 47uF; C_0805_2012Metric
CN1: NUCLE_F446RE_MORPHO_CN7; PinSocket_2x19_P2.54mm_Vertical
CN2: NUCLE_F446RE_MORPHO_CN10; PinSocket_2x19_P2.54mm_Vertical
D1: B560C; D_SMC
F1, F2: 3A; Fuse_1206_3216Metric
F3: 15A; Fuse_1206_3216Metric
F4: Fuse; Fuse_1206_3216Metric
H1, H2, H3, H4: MountingHole; MountingHole_2.7mm_M2.5_Pad_Via
J1: X_END; JST_XH_B3B-XH-A_1x03_P2.50mm_Vertical
J2: Y_END; JST_XH_B3B-XH-A_1x03_P2.50mm_Vertical
J3: +12V; TerminalBlock_bornier-2_P5.08mm
J6: Hotend1; TerminalBlock_bornier-2_P5.08mm
J7: +24V; TerminalBlock_bornier-2_P5.08mm
J8: Hotend2; TerminalBlock_bornier-2_P5.08mm
J9: Bed; TerminalBlock_bornier-2_P5.08mm
J10: Power; TerminalBlock_bornier-2_P5.08mm
J12: Part_Cooling2; JST_XH_B2B-XH-A_1x02_P2.50mm_Vertical
J13: Part_Cooling1; JST_XH_B2B-XH-A_1x02_P2.50mm_Vertical
J27: Z_END; JST_XH_B3B-XH-A_1x03_P2.50mm_Vertical
J28: X_MS2; PinHeader_1x02_P2.54mm_Vertical
J29: HE1_therm; JST_XH_B2B-XH-A_1x02_P2.50mm_Vertical
J30: Bed_therm; JST_XH_B2B-XH-A_1x02_P2.50mm_Vertical
J31: Z1_MS2; PinHeader_1x02_P2.54mm_Vertical
J32: X_MS1; PinHeader_1x02_P2.54mm_Vertical
J33: Z1_MS1; PinHeader_1x02_P2.54mm_Vertical
J34: Z4_MS2; PinHeader_1x02_P2.54mm_Vertical
J35: Z4_MS1; PinHeader_1x02_P2.54mm_Vertical
J36: X_Motor; PinHeader_1x04_P2.54mm_Vertical
J37: Z1_Motor; PinHeader_1x04_P2.54mm_Vertical
J38: Y_MS2; PinHeader_1x02_P2.54mm_Vertical
J39: Z2_MS2; PinHeader_1x02_P2.54mm_Vertical
J40: Y_MS1; PinHeader_1x02_P2.54mm_Vertical
J41: Z2_MS1; PinHeader_1x02_P2.54mm_Vertical
J42: Z4_Motor; PinHeader_1x04_P2.54mm_Vertical
J43: Y_Motor; PinHeader_1x04_P2.54mm_Vertical
J44: Z2_Motor; PinHeader_1x04_P2.54mm_Vertical
J45: E_MS2; PinHeader_1x02_P2.54mm_Vertical
J46: Z3_MS2; PinHeader_1x02_P2.54mm_Vertical
J47: E_MS1; PinHeader_1x02_P2.54mm_Vertical
J48: Z3_MS1; PinHeader_1x02_P2.54mm_Vertical
J49: E_Motor; PinHeader_1x04_P2.54mm_Vertical
J50: Z3_Motor; PinHeader_1x04_P2.54mm_Vertical
J51: PWR_therm; JST_XH_B2B-XH-A_1x02_P2.50mm_Vertical
J52: HE2_therm; JST_XH_B2B-XH-A_1x02_P2.50mm_Vertical
J53: R_MS2; PinHeader_1x02_P2.54mm_Vertical
J54: R_MS1; PinHeader_1x02_P2.54mm_Vertical
J55: R_Motor; PinHeader_1x04_P2.54mm_Vertical
L1: 7.2uH; L_Wuerth_WE-PDF
Q2, Q4, Q5, Q6: PSMN5R2-60YL; LFPAK56
Q7, Q8: AO3400A; SOT-23
R1, R6, R8, R10, R16, R18, R26: 100k; R_0805_2012Metric
R2, R3, R11, R12: 4k7; R_0805_2012Metric
R4, R5, R7, R9: 50R; R_0805_2012Metric
R13: 16.9k; R_0805_2012Metric
R14: 442k; R_0805_2012Metric
R15, R17: 100R; R_0805_2012Metric
R19: 90.9k; R_0805_2012Metric
R20: 243k; R_0805_2012Metric
R21: 53.6k; R_0805_2012Metric
R22: 10.2k; R_0805_2012Metric
R23, R24: 1k; R_0805_2012Metric
R25: 11k; R_0805_2012Metric
U1, U2: MIC4426; SOIC-8_3.9x4.9mm_P1.27mm
U3: TPS54560BDDA; Texas_R-PDSO-G8_EP2.95x4.9mm_Mask2.4x3.1mm_ThermalVias
U4: MIC5219-3.3YM5; SOT-23-5
U8: X; MODULE_TMC2209_SILENTSTEPSTICK; PARTREV 1.20
U9: Z1; MODULE_TMC2209_SILENTSTEPSTICK; PARTREV 1.20
U10: Z4; MODULE_TMC2209_SILENTSTEPSTICK; PARTREV 1.20
U11: Y; MODULE_TMC2209_SILENTSTEPSTICK; PARTREV 1.20
U12: Z2; MODULE_TMC2209_SILENTSTEPSTICK; PARTREV 1.20
U13: E; MODULE_TMC2209_SILENTSTEPSTICK; PARTREV 1.20
U14: Z3; MODULE_TMC2209_SILENTSTEPSTICK; PARTREV 1.20
U15: R; MODULE_TMC2209_SILENTSTEPSTICK; PARTREV 1.20

Connections:
+3V3: C10.1, C14.1, C16.1, C17.1, C18.1, C19.1, C20.1, C21.1, C22.1, CN1.5, CN1.12, CN1.16, CN1.33, J1.1, J2.1, J27.1, J28.1, J31.1, J32.1, J33.1, J34.1, J35.1, J38.1, J39.1, J40.1, J41.1, J45.1, J46.1, J47.1, J48.1, J53.1, J54.1, U4.5 (OUT), U8.2 (VIO), U9.2 (VIO), U10.2 (VIO), U11.2 (VIO), U12.2 (VIO), U13.2 (VIO), U14.2 (VIO), U15.2 (VIO)
+3V3A: CN2.7, R2.1, R3.1, R11.1, R12.1
+5V: C30.1, C31.1, C32.1, CN1.18, L1.2, R21.1, U4.1 (IN), U4.3 (EN)
+12V: C1.1, C26.1, C33.1, C34.1, C35.1, J3.2, J12.1, J13.1, R14.1, U1.6 (V+), U2.6 (V+), U3.2 (VIN)
+24V: C11.1, C23.1, C24.1, C25.1, C36.1, C37.1, C38.1, C39.1, C40.1, F1.1, F2.1, F3.1, F4.1, J7.2, R26.1, U8.8 (VM), U9.8 (VM), U10.8 (VM), U11.8 (VM), U12.8 (VM), U13.8 (VM), U14.8 (VM), U15.8 (VM)
/E_1A: J49.4, U13.3 (M1A)
/E_1B: J49.2, U13.5 (M1B)
/E_2A: J49.3, U13.4 (M2A)
/E_2B: J49.1, U13.6 (M2B)
/R_1A: J55.4, U15.3 (M1A)
/R_1B: J55.2, U15.5 (M1B)
/R_2A: J55.3, U15.4 (M2A)
/R_2B: J55.1, U15.6 (M2B)
/X_1A: J36.4, U8.3 (M1A)
/X_1B: J36.2, U8.5 (M1B)
/X_2A: J36.3, U8.4 (M2A)
/X_2B: J36.1, U8.6 (M2B)
/Y_1A: J43.4, U11.3 (M1A)
/Y_1B: J43.2, U11.5 (M1B)
/Y_2A: J43.3, U11.4 (M2A)
/Y_2B: J43.1, U11.6 (M2B)
/Z1_1A: J37.4, U9.3 (M1A)
/Z1_1B: J37.2, U9.5 (M1B)
/Z1_2A: J37.3, U9.4 (M2A)
/Z1_2B: J37.1, U9.6 (M2B)
/Z2_1A: J44.4, U12.3 (M1A)
/Z2_1B: J44.2, U12.5 (M1B)
/Z2_2A: J44.3, U12.4 (M2A)
/Z2_2B: J44.1, U12.6 (M2B)
/Z3_1A: J50.4, U14.3 (M1A)
/Z3_1B: J50.2, U14.5 (M1B)
/Z3_2A: J50.3, U14.4 (M2A)
/Z3_2B: J50.1, U14.6 (M2B)
/Z4_1A: J42.4, U10.3 (M1A)
/Z4_1B: J42.2, U10.5 (M1B)
/Z4_2A: J42.3, U10.4 (M2A)
/Z4_2B: J42.1, U10.6 (M2B)
Bed: CN1.38, U2.2 (IN_A)
Bed_therm: C3.1, CN2.34, J30.2, R3.2
E_DIR: CN2.26, U13.9 (DIR)
E_EN: CN2.30, U13.16 (~EN)
E_STEP: CN2.28, U13.10 (STEP)
FB: R21.2, R22.1, U3.5 (FB)
GND: C1.2, C10.2, C11.2, C14.2, C15.2, C16.2, C17.2, C18.2, C19.2, C20.2, C21.2, C22.2, C23.2, C24.2, C25.2, C26.2, C28.2, C29.2, C30.2, C31.2, C32.2, C33.2, C34.2, C35.2, C36.2, C37.2, C38.2, C39.2, C40.2, CN1.8, CN1.19, CN1.20, CN1.22, CN2.9, CN2.20, D1.2 (A), J1.2, J2.2, J3.1, J7.1, J27.2, Q2.1 (S), Q2.2 (S), Q2.3 (S), Q4.1 (S), Q4.2 (S), Q4.3 (S), Q5.1 (S), Q5.2 (S), Q5.3 (S), Q6.1 (S), Q6.2 (S), Q6.3 (S), Q7.2 (S), Q8.2 (S), R1.1, R6.1, R8.1, R10.1, R16.1, R18.1, R19.2, R20.2, R22.2, R25.2, U1.3 (GND), U2.3 (GND), U3.7 (GND), U3.9 (GND), U4.2 (GND), U8.1 (GND), U8.7 (GND), U9.1 (GND), U9.7 (GND), U10.1 (GND), U10.7 (GND), U11.1 (GND), U11.7 (GND), U12.1 (GND), U12.7 (GND), U13.1 (GND), U13.7 (GND), U14.1 (GND), U14.7 (GND), U15.1 (GND), U15.7 (GND)
GNDA: C2.2, C3.2, C12.2, C13.2, CN2.32, J29.1, J30.1, J51.1, J52.1
HE1: CN1.34, U1.2 (IN_A)
HE1_therm: C2.1, CN2.6, J29.2, R2.2
HE2: CN1.32, U1.4 (IN_B)
HE2_therm: C13.1, CN2.11, J52.2, R12.2
unnamed: C29.1, R13.2
unnamed: CN1.30, R23.1
unnamed: CN2.33, R24.2
unnamed: C27.1, D1.1 (K), L1.1, U3.1 (BOOT)
unnamed: F1.2, J6.1
unnamed: J6.2, Q2.5 (D)
unnamed: F2.2, J8.1
unnamed: J8.2, Q4.5 (D)
unnamed: F3.2, J9.1
unnamed: J9.2, Q5.5 (D)
unnamed: F4.2, J10.1
unnamed: J10.2, Q6.5 (D)
unnamed: J12.2, Q7.3 (D)
unnamed: J13.2, Q8.3 (D)
unnamed: J28.2, U8.14 (MS2)
unnamed: J31.2, U9.14 (MS2)
unnamed: J32.2, U8.15 (MS1)
unnamed: J33.2, U9.15 (MS1)
unnamed: J34.2, U10.14 (MS2)
unnamed: J35.2, U10.15 (MS1)
unnamed: J38.2, U11.14 (MS2)
unnamed: J39.2, U12.14 (MS2)
unnamed: J40.2, U11.15 (MS1)
unnamed: J41.2, U12.15 (MS1)
unnamed: J45.2, U13.14 (MS2)
unnamed: J46.2, U14.14 (MS2)
unnamed: J47.2, U13.15 (MS1)
unnamed: J48.2, U14.15 (MS1)
unnamed: J53.2, U15.14 (MS2)
unnamed: J54.2, U15.15 (MS1)
unnamed: Q2.4 (G), R1.2, R4.2
unnamed: Q4.4 (G), R5.2, R6.2
unnamed: Q5.4 (G), R7.2, R8.2
unnamed: Q6.4 (G), R9.2, R10.2
unnamed: Q7.1 (G), R15.2, R16.2
unnamed: Q8.1 (G), R17.2, R18.2
unnamed: R14.2, R19.1
unnamed: R4.1, U1.7 (~OUT_A)
unnamed: R5.1, U1.5 (~OUT_B)
unnamed: R7.1, U2.7 (~OUT_A)
unnamed: R9.1, U2.5 (~OUT_B)
unnamed: C28.1, R13.1, U3.6 (COMP)
unnamed: R25.1, R26.2, U3.3 (EN)
unnamed: R20.1, U3.4 (RT/CLK)
unnamed: C27.2, U3.8 (SW)
unnamed: C15.1, U4.4 (BP)
PCF1: CN2.17, R17.1
PCF2: CN1.21, R15.1
PWR: CN1.36, U2.4 (IN_B)
PWR_therm: C12.1, CN2.13, J51.2, R11.2
R_DIR: CN2.16, U15.9 (DIR)
R_EN: CN2.12, U15.16 (~EN)
R_STEP: CN2.14, U15.10 (STEP)
X_DIR: CN2.5, U8.9 (DIR)
X_EN: CN2.1, U8.16 (~EN)
X_END: CN1.25, J1.3
X_STEP: CN2.3, U8.10 (STEP)
Y_DIR: CN1.1, U11.9 (DIR)
Y_EN: CN1.2, U11.16 (~EN)
Y_END: CN1.23, J2.3
Y_STEP: CN1.4, U11.10 (STEP)
Z1_DIR: CN2.19, U9.9 (DIR)
Z1_EN: CN2.15, U9.16 (~EN)
Z1_STEP: CN2.23, U9.10 (STEP)
Z2_DIR: CN1.17, U12.9 (DIR)
Z2_EN: CN1.13, U12.16 (~EN)
Z2_STEP: CN1.15, U12.10 (STEP)
Z3_DIR: CN2.29, U14.9 (DIR)
Z3_EN: CN2.25, U14.16 (~EN)
Z3_STEP: CN2.27, U14.10 (STEP)
Z4_DIR: CN2.4, U10.9 (DIR)
Z4_EN: CN2.31, U10.16 (~EN)
Z4_STEP: CN2.2, U10.10 (STEP)
Z_END: CN1.27, J27.3
uart1_tmc: CN2.21, R24.1, U8.12 (UART), U11.12 (UART), U13.12 (UART), U15.12 (UART)
uart2_tmc: CN1.28, R23.2, U9.12 (UART), U10.12 (UART), U12.12 (UART), U14.12 (UART)

Notes on the sheet:
x nicht direkt am Pin = ADC Pin
Y motor
5V and 3.3V Supply
Hotend: 60W U: 24V I: 2,5A Fuse: 2,5A -> +25% -> ~3A
Reserve motor
Z3 motor
Supply
Z2 motor
E motor
Endstops
E2 motor
Bed: 280W U: 24V I: ~12A Fuse: ~12A -> +25% -> ~15A
4 Treiber pro Uart, da nur 4 Adressen einstellbar
Power FETs
Thermistors
Fan CNTRL
Z1 motor
3 Z-Achsen, 1 X-Achse, 1 Y-Achse, 2 Extruder und 1 Reserve Treiber
X motor
TODO: -part cooling fans auf 24V (derzeitige Treiber halten 24V auch aus) -mehr versorgunsanschlüsse (5V,12V usw) -Verpolschutz -Position Nucleo auf der Platine ändern!!! Eventuelle TODO's: -wenn viel mehr funktionen benötigt werden -> eigenen µC verwenden statt devBoard -beschaltung dafür -USB für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

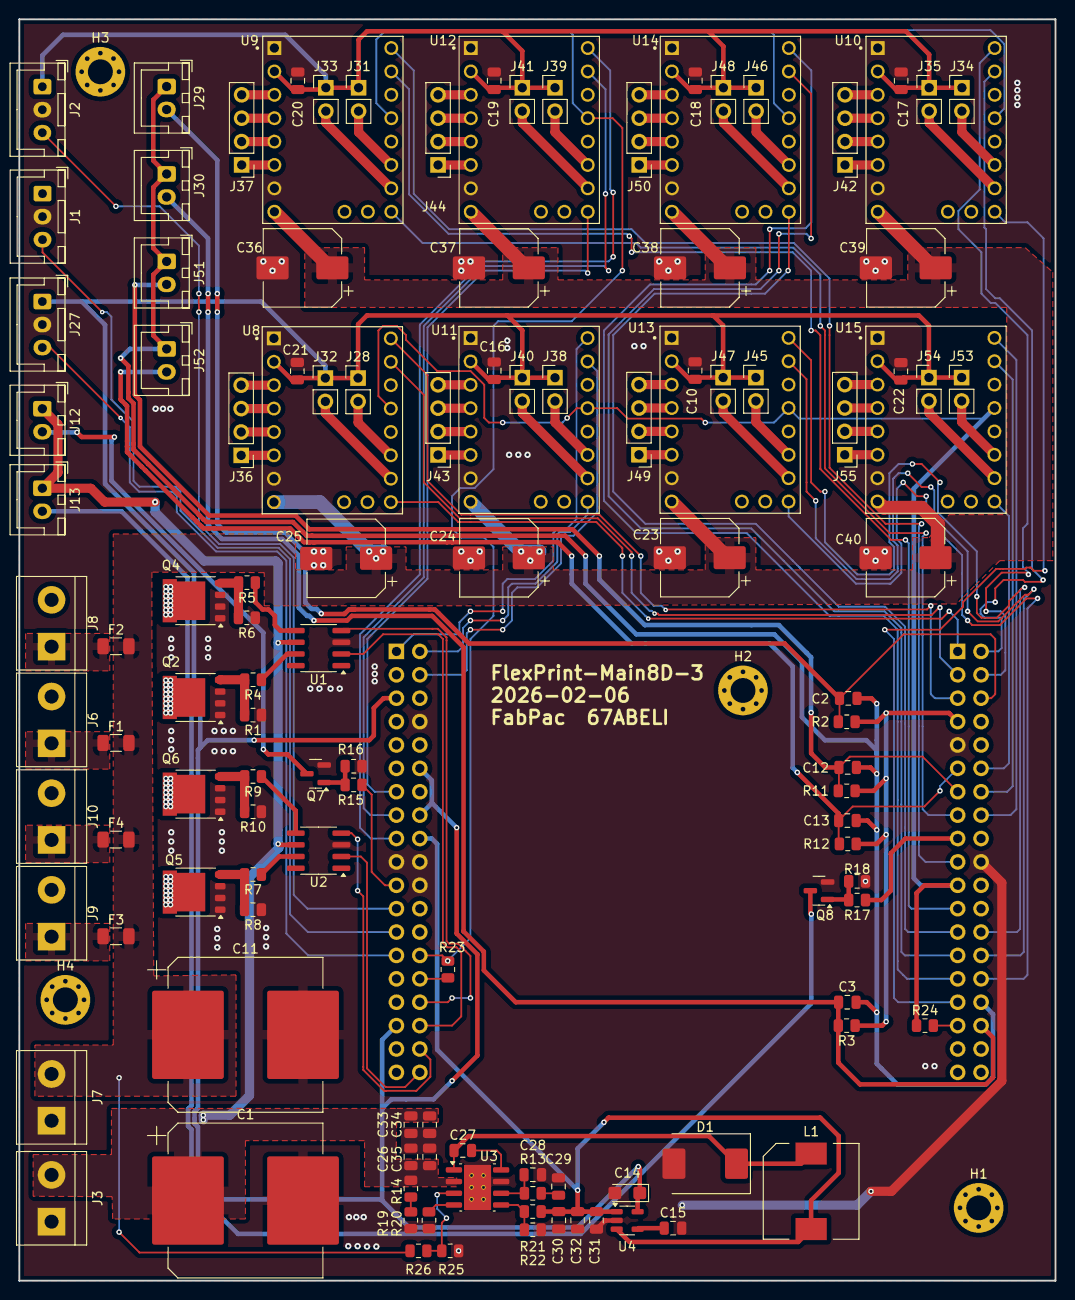
[picture p152: board Mainboard.kicad_pcb from above]

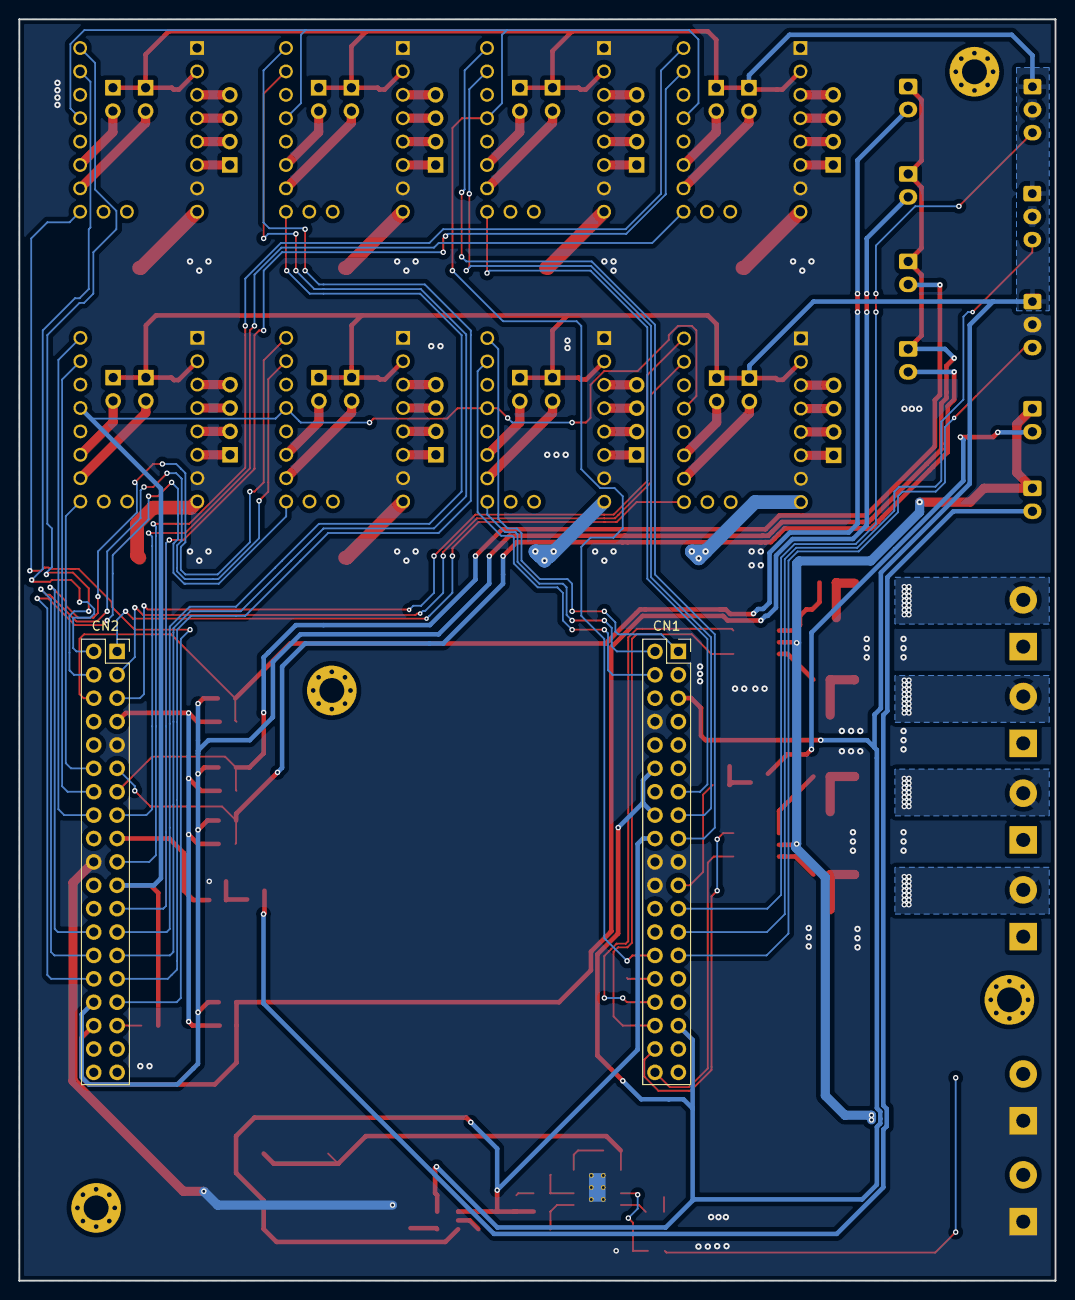
[picture p153: board Mainboard.kicad_pcb from below]

Board: 2 copper layers, 112.5 x 137.0 mm, 129 parts (2 on the bottom side), 125 nets.
