Sprudlwassr/FlexPrint/(commit log)

2025-09-20 20.09.2025 BOM hinzugefügt
2025-09-28 updated mainboard schematics
2025-10-26 driver board for TMC2209
2025-12-04 finished driver board design
2025-12-05 driver board finalized, mainboard started placing FET drivers
2025-12-12 Mainboard changes + BOM for Driver
2026-02-28 Printer.cfg Backup + Softwaredoku Update
2026-03-07 Widgets (nicht funktionsfähig)
    Evtl. kann er die Dateien nicht richtig aufrufen
2026-04-25 Update Pi Temperature
